spring-soft/lychee-music-hardware/pcb/资料/参考资料/pj320a_back.jpg

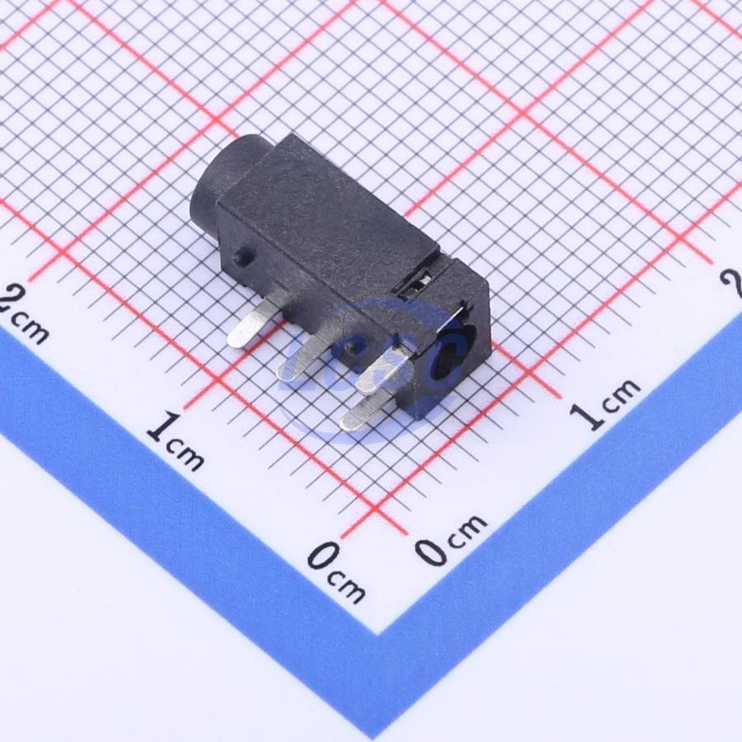
pcb/资料/参考资料/pj320a_back.jpg
