spring-soft/lychee-music-hardware/pcb/资料/设计规格书/README.md

# ESP-Music PCB 设计包 · 从这里开始

---

# 一、这台设备是什么？

## 1.1 一句话

**一台放在桌上、连上家里 WiFi、用耳机听自己音乐库的小播放器。**

## 1.2 它解决什么问题

你家电脑 / NAS / 树莓派上跑着一个 **Navidrome**（开源的自建音乐服务器），里面存着你收藏的全部歌曲。

想听歌的时候：

| 传统做法 | ESP-Music |
|---|---|
| 打开电脑 → 等开机 → 打开网页/客户端 → 找歌 | **插上耳机就能听** |
| 或者掏手机 → 解锁 → 打开 App → 连服务器 | 按键切歌，不看手机 |

**它就是一台"专用音乐终端"** —— 不干别的，只为听歌。

## 1.3 长什么样

```
        ┌─────────────────────────────┐
        │  ┌───────────────────────┐  │
        │  │                       │  │
        │  │   1.8 寸彩屏 128×160  │  │   ← 显示歌名、封面、歌词、进度条
        │  │                       │  │
        │  └───────────────────────┘  │
        │                             │
        │   [K1]  [K2]  [K3]  [K4]    │   ← 4 个按键
        │                             │
        │  ○耳机孔            [Type-C] │   ← 板边：3.5mm 耳机口 + Type-C
        └─────────────────────────────┘
            约 60 × 45 mm，巴掌大
```

## 1.4 怎么用（用户操作流程）

```
1. 插上 Type-C 线供电
      ↓  屏幕亮起，出现启动动画
2. 自动连上你家的 WiFi
      ↓
3. 自动连上你的 Navidrome 服务器
      ↓
4. 自动接着上次听的歌、上次的位置继续放
      ↓
5. 插上耳机就能听
```

**全程不需要任何设置**（WiFi 和服务器地址之前配过一次，存在设备里）。

## 1.5 屏幕显示什么

```
┌─────────────────────────────┐
│ ♪ 越来越不懂                 │  ← 歌名（只显歌名，不带歌手）
│ ┌────────┐                  │
│ │        │  窗外的雨 淋湿了  │  ← 歌词（3 行，当前行高亮）
│ │ 封面   │  我的眼睛          │
│ │        │  我却看不清        │
│ └────────┘                  │
│ ████████░░░░░░  01:23/04:12 │  ← 进度条 + 时间
└─────────────────────────────┘
```

## 1.6 四个按键干什么

| 按键 | 短按 | 长按 |
|---|---|---|
| **K1** | 下一首 | 收藏 / 取消收藏这首歌 |
| **K2** | 播放 / 暂停 | 进入音量调节 |
| **K3** | 上一首 | 打开歌曲列表 |
| **K4** | 切换显示模式（封面+歌词 / 全屏歌词 / 全屏封面） | 打开主菜单 |

**主菜单**里还有：蓝牙遥控、切换音乐来源（最近播放/我的收藏/随机30首）、**屏上搜索**、屏幕亮度、重连 WiFi、系统信息。

## 1.7 还能干什么

| 功能 | 说明 |
|---|---|
| **手机网页控制台** | 手机连上它的 WiFi 或和它同一个局域网，浏览器打开它的 IP 就能选歌、拖进度、看封面 |
| **蓝牙遥控** | 打开"蓝牙遥控"模式后，它会变成蓝牙键盘，**K1~K4 摇身变成控制手机/电脑播放的遥控器** |
| **屏上搜索** | 用 4 个按键在屏幕上打拼音搜歌（设备自带拼音输入法，因为服务器不支持拼音搜索） |
| **收藏双向同步** | 设备上收藏的歌，会同步到 Navidrome 服务器 |

## 1.8 为什么要重新画板

现在的硬件是在**面包板上用杜邦线**连起来的（开发板 + 音频模块 + 屏幕模块各自一块小板），有三个问题：

| 问题 | 现象 |
|---|---|
| **接触不良** | 听歌时断断续续的咔哒声 |
| **音质差** | 没有地平面、杜邦线当天线、功放的开关噪声串进模拟通路 → 底噪大 |
| **不可靠** | 松散、碰一下就断、做不成成品 |

**画一块 PCB 能同时解决这三个问题**：完整地平面 + 短走线 + 焊接替代插接。

## 1.9 新板和旧硬件的区别

| | 旧（面包板） | 新（自制 PCB） |
|---|---|---|
| 主控 | 整块开发板（ESP32-S3-COREBOARD V1.4） | **裸模组** ESP32-S3-WROOM-1-N16R8 |
| 音频 | ES8388 模块 + **PAM8406 功放 + 喇叭** | **ES8388 直接推耳机**，删掉功放和喇叭 |
| 屏幕 | 8 针模块 + 排母 | **1.8" 裸屏 + FPC 座** |
| 连接 | 杜邦线 | **PCB 走线** |

> **为什么删掉功放**：用户只要耳机不要喇叭。而且 **D 类功放的开关噪声正是耳机底噪的主要来源**，删掉等于从根上消除噪声。ES8388 本身内置 40mW 耳机功放，直接就能推 16Ω/32Ω 耳机。

---

# 二、你的任务

**用立创EDA 画出这块板子的原理图和 PCB，交嘉立创制造 + 贴片。**

```
读规格书 → 建工程 → 放元件 → 连线 → 转PCB → 布局 → 布线 → 铺铜 → 下单
```

**完整的设计信息全在 `电路设计规格书.md` 里。**

---

# 三、文档索引

## 📌 主文档：`电路设计规格书.md`

| 章节 | 内容 |
|---|---|
| **第 2 节** | ⭐ **元件清单 —— 每个元件在立创EDA里搜什么、选哪个、封装是什么** |
| **第 3 节** | ⭐ **完整网表 —— 哪个脚连哪个脚** |
| **第 4 节** | ⭐ **在立创EDA里的 10 步操作流程** |
| **第 5 节** | ⭐ **布局位置指引（含分区示意图）** |
| 第 7 节 | 关键参数说明（为什么用这些值） |
| 第 8 节 | 屏幕规格（含 14 脚定义） |
| 第 9 节 | 主控引脚分配表 |
| 第 10 节 | 固件侧配置（I2C 地址等） |
| 第 11 节 | ❗️ 不可违反的硬约束 |

## 📁 `esp32s3/` —— ESP32-S3 与现有硬件资料

| 文件 | 是什么 |
|---|---|
| `ESP32-S3-SCH-V1.4.pdf` | **现有开发板的完整原理图**（USB 部分、自动下载电路、外设接口都可以参考） |
| `ESP32-S3-Metric.pdf` / `ESP32-S3-inch.pdf` | 开发板尺寸图 |
| `sch.txt` / `sch.xml` | 上面原理图的**文字提取版**（可以搜索引脚连接，比看 PDF 快） |
| `sch-1.png` / `usb2-1.png` / `crop_*.png` | 原理图局部截图（USB、RGB、自动下载电路、接口座等） |
| `ES8388+PAM8406立体声CODEC音频模块资料.docx` | **现有音频模块的完整资料**，含实物图、引脚定义、规格参数 |
| `esp32-es8388-v1.1.zip` | 一个针对 ESP32-ES8388 开发板的 ESP-IDF 参考工程（可看 ES8388 代码怎么写的） |

## 📁 `屏幕规格书/` —— 要采购的 1.8" 屏

| 文件 | 是什么 |
|---|---|
| **`UN1770197-C-V02（C14).pdf`** | ⭐ **要买的就是这个版本**：14PIN 插拔式，0.5mm 间距，金手指朝屏幕反面 → 配「**下接**」FPC 座 |
| `UN1770196-C-V03 (H14).pdf` | 同款屏的「14PIN 焊接式」（0.8mm 间距，**不要买**） |
| `M180-128160-RGB-8.pdf` | 同款屏的「8 针排针模块」版（就是现在用的那种） |
| `ST7735S_V1.1_20111121.pdf` | ⭐ **ST7735S 驱动芯片原厂手册（201 页）**，调屏幕时序/伽马靠它 |
| `原理图.pdf` | 屏幕转接板的原理图 |

## 📁 `固件引脚定义/` —— 引脚定义的权威来源

| 文件 | 是什么 |
|---|---|
| `board.h` | 固件里所有引脚的 `#define`（**引脚分配的最终依据**） |
| `board.c` | ES8388 初始化、寄存器序列、音量控制、I2S 配置 |

---

# 四、工具

**立创EDA** —— 免费、中文、元件库直接对接嘉立创商城（元件有库存和价格，能一键下单）。

下载：https://lceda.cn/page/download

### ⚠️ 选「专业版」还是「标准版」

| | 专业版 | 标准版 |
|---|---|---|
| 下载体积 | 346 MB | 95 MB |
| **内存要求** | **8 GB** | 4 GB |
| 装机后占用 | 1.1 GB | 236 MB |

> **本项目用「标准版」完全够。** 唯一区别是专业版有层次原理图、多板设计这些**大型项目**才用得上的功能 —— 这块 45 个元件的单板用不上。
>
> （下载页上 `lceda-pro-...` 是专业版，纯 `lceda-...` 是标准版。）

---

# 五、最终要做出来的东西

```
一块约 60 × 45 mm 的 4 层板，焊好约 45 个元件：

  ┌ ESP32-S3-WROOM-1-N16R8 模组     主控 + WiFi + 蓝牙
  ├ ES8388                          音频 Codec（内置耳机功放）
  ├ TLV75733 LDO                    5V → 3.3V
  ├ Type-C 座                       供电 + 烧录 + 串口 + JTAG
  ├ 3.5mm 立体声耳机座
  ├ FPC 座（0.5mm 14P）             接 1.8" 屏
  ├ 背光 MOSFET + 限流电阻
  ├ 6 个轻触开关                    K1-K4 + RESET + BOOT
  └ 约 32 个电阻电容磁珠

插上屏 → 插上耳机 → 插上 USB 线烧固件 → 就能听歌
```

**制造方式**：嘉立创一站式（PCB 打样 + SMT 贴片 + 插件焊接），到手即成品板。

---

# 六、⚠️ 三条最容易翻车的地方

| # | 注意 | 后果 |
|---|---|---|
| 1 | **模组天线区正下方不能铺铜，且要悬出板边** | 铜在天线下面 → WiFi 辐射效率大幅下降，信号差、卡顿 |
| 2 | **`IO35` / `IO36` / `IO37` 绝对不能接任何东西** | 被 Octal PSRAM 芯片内部占用。网上例程用的是 N8R2（Quad PSRAM）版本，那三根能用，**不能照抄** |
| 3 | **ES8388 的 `CE` 脚必须接 `VCC`** | 决定 I2C 地址（CE=1 → 0x11，正是固件用的）。接错 → 芯片完全无响应 |

（完整清单见规格书第 11 节）
