spring-soft/lychee-music-hardware/交接说明.md

# ESP-Music 项目交接说明

> 交给 DSH（或任何接手的人/agent）的第一份文档。看完这份就能上手，不用重新摸索。
> 最后更新：2026-10-04

> ## 🆕 2026-10-07 更新：拆成两条分支，面包板那条冻结在原版
>
> 面包板与实际 PCB 现在是**两条独立的 git 分支**，各自把板型钉死在受版本控制的
> `firmware/sdkconfig.forced` 里，所以互不干扰、也不依赖那个含密码的 `sdkconfig.local`：
>
> | 分支 | 内容 | 板型 |
> |---|---|---|
> | `breadboard` | **原版 + 24bit 输出**（没有编码器 / TF 卡 / 离线模式 / 新增网页模式接口） | 钉死 `=y` |
> | `v2-pcb` | M9 全部功能（编码器 / TF 卡 / 离线曲库 / 在线离线双模式 / 收藏同步 / 网页模式扫描接口）**+ 24bit 输出** | 钉死 `=n` |
>
> ### 🎵 2026-10-07：24bit 解码已开通（两条分支都有，面包板上真机验证通过）
>
> 改动前整条链路写死 16bit：24bit FLAC 被 `ae_normalize()` 压成 16bit 才送进 DAC
> （播放页显示"24"是**源**位深，芯片实际按 16 在放）。现在 >16bit 的源按原精度送出。
>
> - **>16bit 的源** → 24bit 输出：**32bit 槽 + 数据 MSB 左对齐**，ES8388 `0x17 = 0x00`
> - **≤16bit 的源** → 16bit 输出（与改动前**逐字节相同**，有独立 memcpy 快路径）
> - 为什么不用 24bit 槽：`bclk_div = mclk/(2×槽位宽)` 必须整除，256/48 = 5.33 做不出来；
>   32bit 槽是 256/64 = 4 ✓
> - 回退开关：`audio_engine.c` 顶部 `#define AUDIO_OUT_ALLOW_24BIT 0`
> - 详情（含真机抓出的两个 bug）：`docs\开发记录\esp-music-24bit.md`
>
> ⚠️ **听感上基本听不出来**（差异是 −96dB 级量化噪声，埋在模拟噪声地板之下）。
> 它的意义是"不再无谓丢信息"。真正的听感瓶颈是 MCLK 抖动（S3 无 APLL），那要改硬件。
>
> ⚠️ 顺带修了一个**既有**缺陷：`board_measure_ws_hz()` 原来除以"请求窗口"而不是"实际窗口"
> （`vTaskDelay` 只保证至少睡够），忙时会报出 +30% 的**假**频率。它还会让旧记录里的
> "44.1k 偏差 −7.9‰（MCLK 分数分频）"变成假象 —— 修好后实测是 **−0.2‰**。
>
> ⚠️ **切分支后必须删 `firmware/sdkconfig` 再编译。**
> 它是 gitignore 的生成物，跨分支会残留旧配置 —— 实测从 `v2-pcb` 切到 `breadboard` 后，
> `sdkconfig` 里还带着 M9 打开的 FATFS 长文件名，而面包板分支的 `sdkconfig.forced`
> 里没有那几行，`sync_sdkconfig.py` 不会把它改回去。
>
> ⚠️ **只有 `firmware/` 在 git 里。** `docs/`、`pcb/`、根目录的 README 与本文
> **都不受 git 管辖**，所以它们不随分支切换 —— 看文档时先分清讲的是哪条线。
>
> ### 编译与烧录速度（实测，2026-10-07）
>
> | 场景 | 用时 |
> |---|---|
> | 什么都没改，再 build | **1.9 秒** |
> | 改一个 `.c` 再 build | **30.9 秒**（大部分是链接 2.5MB ELF + 生成镜像） |
> | 全量（删 `build/` 或 fullclean） | **181 秒**（2033 个目标文件 / 127 个静态库） |
> | 全量 + ccache 热缓存 | **122 秒**（省 33%；命中率 1926/1928 ≈ 100%） |
> | 全量 + ccache 冷缓存 | 305 秒（首次要多写缓存，之后就赚回来） |
>
> ccache 只省得下"编译"那一段；剩下的**链接 + 生成镜像 + configure 约 120 秒是地板**，
> 所以别指望更快。另外：`ccache` 的开关是环境变量 `IDF_CCACHE_ENABLE`（写在
> `env/idf.sh` 与 `E:\Espressif\idf.sh` 里）—— **不能**在 `CMakeLists.txt` 里
> `set(CCACHE_ENABLE ...)`，因为 `idf.py` 每次都用命令行 `-D` 传这个变量，会把它压掉
> （试过一轮才发现，坑记在 `CMakeLists.txt` 的注释里）。缓存目录钉在
> `E:\Espressif\ccache`（避开中文用户名路径）。
>
> 所以日常这么用：
> - 只改代码 → `idf.sh build`，**不要** fullclean
> - 只烧 app（`assets.bin` 没变）→ `idf.sh -p COM4 app-flash monitor`，约 50 秒
>   （**全量烧要 ~2.5 分钟**，因为它每次都重写 1.8MB 的 assets —— 这是"感觉编译很慢"
>   的一大半来源，"编译"其实只占其中一段）
> - 换板型 / 切分支 → **必须** `fullclean`（引脚宏影响多个组件的条件编译）
>
> ### M9 相关文档（都是 `v2-pcb` 线的）
>
> - `docs\开发记录\esp-music-m9-offline-tf.md` —— 实施记录 + **真机校准清单 10 项**
> - `docs\踩坑与设计记忆\esp-music-tfcard-plan.md` —— 方案与边界（⚠️ 这份曾丢失，已重建）
> - 顺手修过一个既有 bug：网页控制台 `max_uri_handlers`(32) 小于实际路由数(33)，
>   最后一条 `/api/hid/send` 一直静默 404。已放宽到 40。
>
> **当前实测状态**：面包板原版已烧回板上并跑通（菜单 5 项 / 设置 1 项 = 原样）。
> ⚠️ V2 板还没做好 —— 编码器 / TF 卡 / 离线曲库**尚未在真机上验证过**。

---

## 0. 这是什么

一台**自己画板、自己写固件的 WiFi 音乐播放器**。

```
  Navidrome 音乐服务器 ──WiFi──> [自研 PCB: ESP32-S3-N16R8]
                                        │
                                        ├─ 音频: ES8388 编解码 → 3.5mm 耳机座
                                        ├─ 显示: 1.8" ST7735 160×128 彩屏
                                        ├─ 输入: 4 个按键 (K1~K4)
                                        └─ 网页控制台 + 按键操作
```

固件自己实现：FLAC/MP3/AAC 解码、环形缓冲、直出无损、LVGL 界面、网页控制台。
**不是**刷现成固件改配置，是从零写的工程（约 9500 行 C，12 个自研 component）。

---

## 1. 目录结构

```
E:\program\esp-music\
├── 交接说明.md          ← 本文件
├── README.md            ← 索引 + 快速开始
│
├── firmware\            ← 固件源码（ESP-IDF 工程，带完整 .git 历史）
│   ├── components\      ← 12 个自研组件（板级/音频/UI/网络/播放器/网页控制台…）
│   ├── main\app_main.c  ← 启动编排（8 步开机流程）
│   ├── managed_components\  ← 第三方依赖（已下载，可离线编译）
│   ├── sdkconfig.local  ← ⚠️ 含 WiFi 和 Navidrome 密码，见第 7 节
│   └── tools\           ← 资源生成脚本（字库/拼音/图标）
│
├── pcb\                 ← PCB 设计（嘉立创EDA专业版）
│   ├── esp-music-player-V1+V2工程包.epro2  ← ★ 完整工程包（V1+V2 两块板）
│   ├── V2-TF卡版-单板.epro2
│   ├── V2-TF卡版-Gerber-新.zip             ← ★ 最新打样文件（已下单）
│   ├── 接线表与引脚定义.md                 ← ★ 引脚权威文档
│   ├── 交付说明.md / 交付说明-PCB布线.md
│   ├── SMT_BOM元件清单.xlsx / SMT_贴片坐标.xlsx
│   ├── 元件采购清单*.csv/md                ← 立创商城配单
│   ├── 设计数据\        ← bom.json / netlist.json（EDA 导出的结构化数据）
│   ├── 资料\            ← 芯片手册、屏幕规格书、固件引脚补丁后的 board.h/.c
│   ├── 工具\            ← 99 个 EDA 自动化脚本（见第 6 节）
│   └── 旧文件备份\      ← 早期迭代产物（历史存档，一般不用看）
│
├── docs\                ← 开发记录（★ 信息密度最高，接手先读）
│   ├── 方案与进度（正式）.md     ← 47KB，完整方案 + 进度表
│   ├── esp-music-全部代码.txt    ← 61 个手写文件的拼合版带行号索引
│   ├── 开发记录\                 ← 18 篇专题笔记（音频链路/字库/按键/持久化/搜索…）
│   └── 踩坑与设计记忆\           ← 从 Claude 记忆导出的硬事实（引脚/吞吐/坑）
│
├── env\                 ← 构建环境包装脚本
│   ├── idf.sh           ← ★ 编译入口（Git Bash 下用这个，别直接用 idf.py）
│   └── msys_shim.py     ← 绕开 ESP-IDF 的 Git Bash 检测
│
└── 归档\                ← 原始备份 zip
    ├── lychee-music-backup-20260925.zip  ← 固件的原始备份（212MB）
    └── ESP-Music-PCB.zip
```

---

## 2. 硬件

### 两块板

| | V1 | V2（当前主线） |
|---|---|---|
| 嘉立创工程 | `PCB1` | **`PCB1_1`** |
| 特点 | 面包板验证版 | **TF 卡版**（+ 旋转编码器 + TF 卡槽）|
| 状态 | 已制造 | 已下单，**固件尚未适配新增硬件** |

### V2 引脚表（权威，来自 `pcb\接线表与引脚定义.md` + EDA 导出）

| 功能 | 固件宏 → GPIO |
|---|---|
| I2C | `SDA=1` `SCL=2` |
| I2S（音频） | `MCLK=42` `BCLK=41` `WS=39` `DOUT=40` |
| LCD | `SCLK=4` `MOSI=5` `RST=6` `DC=7` `CS=15` `BL=16` |
| 按键 | `K1=38` `K2=8` `K3=18` `K4=17` |
| 🆕 旋转编码器 | `ENC_A=9` `ENC_B=10` `ENC_SW=11` |
| 🆕 TF 卡 | `TF_CS=12` `TF_MISO=13` `TF_CD=14` |

### ⚠️ 相对面包板版的 3 处关键变化（不打补丁 K1 直接失效）

1. **`KEY_K1`: GPIO3 → GPIO38**。IO3 是 strapping 脚，上电被拉低会进 JTAG。
   **不打补丁就烧录，固件去轮询悬空的 IO3，K1 完全没反应。**
2. 删 `BOARD_PIN_PA_EN`（GPIO47）—— 去掉 PAM8406 功放，ES8388 内置耳放直推耳机。
3. 删 `BOARD_PIN_I2S_DIN`（GPIO38）—— 不录音，GPIO38 正好腾给 K1。

补丁文件 `pcb\firmware-patch.diff`，**打好补丁的版本**在 `pcb\资料\固件引脚定义\board.{h,c}`。
（当前 `firmware\` 里的 board 组件已包含这些改动。）

### ⚠️ TF 卡的关键硬约束

- **TF 卡和屏幕共用 SPI 总线**（`CLK=IO4`、`MOSI=IO5`），**靠 CS 区分**（屏幕 IO15 / TF 卡 IO12）。
- TF 卡 DAT1/DAT2 悬空 → 是 **SPI 模式**，不是 SD 1-bit 模式。
- **电量显示做不到**：IP5306 直接驱动 3 颗 LED，**没有任何一路回到 ESP32**。
  要显示电量必须重新打板加 ADC 分压网络。那 3 颗 LED 就是唯一电量指示。

---

## 3. 固件现状

### 已完成并**实机验证**（面包板上跑通）

| 里程碑 | 内容 |
|---|---|
| M0 | 工具链 / 分区 / PSRAM / 板级 bring-up |
| M1 | 音频管道（解码 → 环形缓冲 → I2S），MP3 精确到帧、FLAC 不崩 |
| M2 | 联网 + Navidrome 拉流 |
| M3 | 播放页 UI（封面/歌名/滚动/进度） |
| M4 | 按键 + 列表页/菜单页/音量页 + 来源切换 |
| M5 | 网页控制台（27 个接口） |
| M6 | 最近播放/收藏落盘 + 与 Navidrome 双向同步 + 开机续播 |
| M8 | 屏幕上的拼音搜索 |

### 近期优化（都在 `v2-pcb` 分支）

- **无损直出**：首次播放 `format=raw` 直出原文件，只有 seek 才转码
- **WiFi 吞吐 100 → 233+ KB/s**：砍掉 BLE + 调 WiFi 接收缓冲 + TCP 窗口 8K→64K
- 实测最重的一首（1864kbps / 24bit / 48kHz，需 233 KB/s）**FLAC 直出、欠载 0**
- 播放页显示解码格式/直出或转码/实时速率
- 内存用量图表页（长按系统信息页的 K3 进入）
- 开机第 7 步「同步曲库」：修掉"本地列表 suffix 为空 → 整列歌变 MP3"的 bug

### 🆕 2026-10-06 新增（代码已完成，等 V2 板验证）

| 项 | 状态 |
|---|---|
| 旋转编码器（PCNT 正交 + 全菜单方向键） | ✅ 完成。**面包板变体不编译**（K1/K2 语义一字未改）；V2 变体才编入 |
| TF 卡（SDSPI，与屏幕共用 SPI2） | ✅ 完成。**懒挂载/用完卸载**（内存取舍），卡检测 IO14 |
| 离线曲库（扫描 / 文件名解析 / 索引 / 搜索） | ✅ `components/musiclib/`；索引在卡上 + PSRAM 常驻；离线搜索不需要拼音索引 |
| 在线 / 离线双模式（歌单、收藏、最近播放分开） | ✅ 主菜单第 4 项（两段确认）；NVS `cfg/mode` |
| 收藏同步到离线 | ✅ 设置页第 2 项（只同步标记，不下载音频；匹配不上就跳过） |

### ❌ 还没做的

- **离线 seek**（现在是"从头重播"，有日志提示）。**刻意留到板子到了再做**：唯一正确的做法
  （decode-and-discard）要动全工程最精细、也是唯一被真机充分验证过的那条音频管道，
  为一个"快进"冒回归在线播放的风险不划算
- 标签解析（离线曲目的时长显示 `--:--`、封面用占位图 —— 用户已确认用文件名元数据）
- 卡热插拔自动重挂（现在只在切模式/扫描/同步时尝试挂载）
- **开机续播**：用户明确说不要了（已删）

### 🔧 编 V2 固件用这个（别手改 sdkconfig.local）

```bash
cd /e/program/esp-music/firmware
tools/build_v2.sh                        # 编 V2 变体（自动 fullclean）
tools/build_v2.sh -p COM5 flash monitor  # 烧录
```

它临时往 `sdkconfig.forced` 加一行板型、编完自动撤掉，**全程不碰含密码的 `sdkconfig.local`**。
面包板变体不需要脚本，直接 `/e/Espressif/idf.sh build`。

---

## 4. 编译 & 烧录

### ⚠️ 这台机器有三个 Windows 坑（都已解决，用包装脚本绕过）

1. **中文用户名**：用户名「春软」导致 xtensa 工具链报路径全是 `????`，
   `ld` 找不到 `crt0.o`/`libgcc`。→ 工具链装在**纯 ASCII 路径** `E:\Espressif\tools`。
2. **Git Bash 的 `MSYSTEM` 删不掉**：`idf_tools.py`/`idf.py` 检测到它就拒绝运行，
   而 `unset`/`env -u` 都无效（会被重新注入）。→ `msys_shim.py` 在 Python 进程内 pop 掉。
3. `export.bat` 同时负责加 PATH，绕开它就得自己加。→ `idf.sh` 里手工加了。

### 编译（在 Git Bash 里）

```bash
cd /e/program/esp-music/firmware
/e/Espressif/idf.sh build            # ← 用这个，不要直接 idf.py
```

> `env\idf.sh` 是同一份脚本的副本；`E:\Espressif\idf.sh` 是原件，两个都能用。

⚠️ **换了路径后第一次编译前**：`build/` 里记着绝对路径，必须先 `idf.py fullclean`
（或直接删 `build/`）。目录刚搬过家，**第一次务必 fullclean**。

⚠️ **改了 `sdkconfig.local` 直接 build 是无效的** —— 顶层 `CMakeLists.txt` 每次 configure 前
跑 `tools/sync_sdkconfig.py`，把 `sdkconfig.local`/`sdkconfig.forced` 强制覆盖进 `sdkconfig`。
这是刻意设计（IDF 的 `SDKCONFIG_DEFAULTS` 对已存在的 `sdkconfig` 无效）。

### 烧录

```bash
/e/Espressif/idf.sh -p COM5 flash monitor
```

原生 USB-Serial-JTAG 走 IO19/IO20，支持自动复位。不行就按住 SW6(BOOT) 再点 SW5(RESET)。

### 施工开关（都在 `main\app_main.c`）

| 开关 | 作用 | 默认 |
|---|---|---|
| `K4_SELFTEST` | 开机自动走一遍按键序列并逐页打印页面名（改完按键逻辑自测用） | 0 |
| `BASELINE_TONE` | 开机放 1.5 秒 440Hz 测试音 | 0 |
| `UI_DUMP_ON_SONG` / `UI_CALIBRATE` | UI 调试 | 0 |

⚠️ `K4_SELFTEST` 开着时会在开机后**自己乱按键**，验证完记得关。

---

## 5. 接手前必读的坑（精选，全文见 `docs\踩坑与设计记忆\`）

| 坑 | 一句话 |
|---|---|
| **内部 SRAM 是最紧的资源** | 共 308KB，BLE 要 40KB。`SPIRAM_MALLOC_ALWAYSINTERNAL=512` 意味着 <512B 的 malloc 进内部 SRAM。**加一个 LVGL 页面就可能挤垮网络。** |
| **BLE 已砍** | `CONFIG_BT_ENABLED=n`，换来内部 SRAM 从 7KB → 49KB。**这是 WiFi 提速的前提**，别随手加回来。 |
| **OGG 不能直出** | Vorbis 解码器吃光内部 SRAM 后停止消费，`ring_in` 涨满、网络挂掉。**OGG 走服务端转码**（那条路是好的）。 |
| **NVS 里残留的 transcode 设置** | 烧新固件不会清。曾经残留 `"raw"` 导致所有格式直出、OGG 卡死，而音质菜单已删、界面改不回来。→ `subsonic_init()` 里强制改回 `auto`。 |
| **本地列表的 suffix 是空的** | 收藏/最近播放来自本地镜像，镜像里 suffix 为空 → 判不出格式 → **整列歌变 MP3**。修法：开机第 7 步同步曲库 + `h_play` 回源。 |
| **诊断利器 `/api/debug` 的 `stream_why`** | 直接告诉你"这次为什么直出/转码"。**查"怎么变 MP3 了"先看它。** |
| **`ui_font_lat` 没有汉字** | 只有拉丁字形，拿它渲染中文会出**方框**。中文要用 `ui_font_12`/`ui_font_16`。 |
| **Navidrome 不支持 `format=flac`** | 静默忽略，直接发回原文件。"把有损源转 FLAC"这条路走不通。 |
| **S3 的 I2S 没有 APLL** | MCLK 只能从 160MHz 分数分频 → 必然抖动。治不了，板子上也没晶振。 |

---

## 6. 工具清单

### 固件侧 `firmware\tools\`
| 脚本 | 用途 |
|---|---|
| `sync_sdkconfig.py` | ★ 把 `sdkconfig.local`/`.forced` 覆盖进 `sdkconfig`（每次 configure 自动跑） |
| `gen_font.sh` / `gen_font_charset.py` | 生成中文字库 bin |
| `gen_pinyin.py` | 生成拼音检索表 |
| `gen_ui_png.py` / `gen_ui_text.py` | 预渲染 UI 素材 |
| `gen_assets.py` | 打包 `assets.bin` |

### PCB 侧 `pcb\工具\`（99 个脚本）+ `pcb\*.js`
这些是 **EasyEDA 自动化脚本**（用 `eda.mjs` 通过 WebSocket 驱动嘉立创EDA专业版）：
布局求解、碰撞检测、DRC 检查、铺铜、走线、Gerber 导出、3D 截图… 
命名规律：`check-*` 检查、`dump-*` 导出、`apply-*`/`fix-*`/`move-*` 改板、`pour-*` 铺铜。

**用之前先读** `docs\踩坑与设计记忆\easyeda-pro-api-pitfalls.md` —— 里面记着哪些 API 是坏的，
免得重复试参数。EDA 专用 skill 也在环境里（`easyeda-api`）。

---

## 7. ⚠️ 凭据与安全

**`firmware\sdkconfig.local` 里有明文密码**：WiFi 密码 + Navidrome 账号密码。
`tools\sync_sdkconfig.py` 会把它们**同步写进 `sdkconfig`**，所以那个文件里也有。

- 两个文件都在 `.gitignore` 里 —— **推 GitHub 的那份是干净的，千万别 `git add` 它们**。
- 设备上的 WiFi/Navidrome 配置还存在设备 NVS 里，所以删掉这个文件不影响已配好的机器；
  换机器编译时照 `sdkconfig.local.template` 填一份即可。

---

## 8. 下一步（V2 板到货后）

**动手前必读** `docs\踩坑与设计记忆\esp-music-tfcard-plan.md`
（方案与边界）＋ `docs\开发记录\esp-music-m9-offline-tf.md`
（实施记录、实测数字、**第 7 节的 10 项真机校准清单**）。

| 原计划阶段 | 状态 |
|---|---|
| 1 板级适配（V2 引脚补丁 + 四键/屏/音频实测） | 代码侧已就绪（board.h 的 V2 分支早就在）；**实测等板子** |
| 2 旋转编码器（PCNT 正交 + 事件映射） | ✅ 已实现。⚠️ 原计划的映射"顺时针=K2、逆时针=K1、按下=K3"**改了**：现在是按页面显式映射（播放页=切歌/暂停，列表页=移行/确认…），见 dev record 第 2 节的键位表 |
| 3.1 **提 SPI 总线** | ✅ **风险消失**：不需要搬时序。`esp_vfs_fat_sdspi_mount()` 只要求总线已初始化，而屏幕开机第 3 步就建好了；只把 `spi_bus_initialize` 换成幂等的 `board_spi_bus_init()`，零时序变化 |
| 3.2 SDSPI 挂 `/sdcard` | ✅ 已实现（20MHz、`format_if_mount_failed=false`、卡不在不阻塞启动；且改成**懒挂载+用完卸载**省内部 SRAM） |
| 3.3 缓存双后端 | ❌ **已废弃**：用户把 TF 卡的用途定为"离线曲库"，在线缓存继续留 flash `cache` 分区（两条线互不干扰） |
| 4 联调 + 整机验收 + 内存核算 | ⏳ 等板子。内存账见 dev record 第 6 节（V2 固件 2,545,392 B，app 分区用 80.9%） |

**用户已拍板的决定（别再问）**：
- 要**无损**不要转码；TF 卡用途是**缓存 + 卡检测**；编码器当**全菜单方向键**
- **断点续播不要了**；**菜单里不要音质选项**（固定最高）；**BLE 可以砍**（已砍）
- 离线方案：**在线/离线双模式、收藏分开、在线收藏能同步到离线（卡上没有的跳过）**

---

## 9. 一上手就能验证的三件事

```bash
# 1. 固件能编
cd /e/program/esp-music/firmware && /e/Espressif/idf.sh fullclean && /e/Espressif/idf.sh build

# 2. 逻辑没坏（读 git 历史，29 个提交）
git log --oneline | head -20

# 3. 硬件设计齐全
ls /e/program/esp-music/pcb/          # 工程包 + Gerber + BOM + 采购清单
```
