spring-soft/lychee-music-hardware/pcb/交付说明-PCB布线.md

# ESP-Music PCB —— 布线交付说明

**日期**：2026-09-27
**工程**：嘉立创EDA专业版 `esp-music-player`
**本阶段范围**：PCB 布局定稿 + 布线 + 铺铜 + DRC
**上一阶段**：见 `交付说明.md`（原理图）

---

## 一、结论

**板子已完整交付，DRC 零违规。**

| 项目 | 结果 |
|---|---|
| 板框 | **58.0 × 50.0 mm**，四层板 |
| 元件 | 70 个（正面 14 / 背面 56） |
| 网络 | 50 个，**全部布通，0 未布通** |
| 走线 | 839 段（顶层 199 / 底层 640） |
| 过孔 | 152 个 |
| 铺铜 | 4 块（内层二 GND / 内层一 VCC / 顶层 GND / 底层 GND） |
| **DRC** | **0 违规** ✅ |

> 布线只用了**顶层和底层**，两个内层完整留给了电源平面和地平面。

---

## 二、叠层设计（四层）

| 层 | ID | 用途 | 说明 |
|---|---|---|---|
| 顶层 Top | 1 | 信号 + GND 铺铜 | 元件少（只 14 个），中间大片空白走线 |
| 内层一 Inner1 | 15 | **VCC 3.3V 电源平面** | 整板铺铜，天线区挖空 |
| 内层二 Inner2 | 16 | **GND 地平面** | 紧贴底层，底层所有信号的完整回流路径 |
| 底层 Bottom | 2 | 信号 + GND 铺铜 | ESP32 / 音频芯片 / 电源都在这层 |

**为什么这么分：**

- **内层二做地平面** —— 它紧贴底层，而 ESP32、ES8388 音频芯片、IP5306 电源全在底层。这层做完整地平面 = 所有信号都有完整回流路径，**这是解决底噪最关键的一步**。
- **内层一做 VCC 平面** —— 见第四节的「VCC 阻抗问题」。

**天线禁布区**：板子上边缘留出 84 mil（约 2.1 mm）不铺铜（所有层），避让 ESP32 模组的 WiFi 天线。同时模组天线本身悬出板边。

---

## 三、本轮修掉的 4 处间距违规

DRC 在布局阶段查出 4 处，**全部是我之前的检查脚本漏掉的** —— 根源是我用「手写的元件本体尺寸表」估算，而编码器、耳机座的**焊盘伸出了本体轮廓之外**。

| # | 问题 | 处理 |
|---|---|---|
| 1 | `C15` ↔ `C16` 焊盘重叠 **16.4 mil** | C15 → (1572, 1330)，C16 → (1560, 1070) |
| 2 | `J4` 电池座固定脚 ↔ `R17` 焊盘，间隙仅 **1.2 mil** | R17 左移到 x=1990 |
| 3 | `J2` 耳机座焊盘**出界 11.8 mil** | J2 左移到 x=2125 |
| 4 | `EC1` 编码器焊盘**出界 5.9 mil** | EC1 左移到 x=2070 |

**改进**：新增 `check-pads.mjs` —— 直接用 EDA 导出的**真实焊盘几何**（形状 + 旋转角）算矩形，不再依赖手写尺寸表。修完复跑，它与 DRC 的结果**完全一致**。

另外修掉的盲区：
- `check-throughhole.js` 改为**自动识别直插件**（读焊盘 layer=12），不再手写清单 —— 之前 SW5/SW6 改成贴片后清单没同步
- 各检查脚本里 SW5/SW6 的本体尺寸从 6×6mm 修正为实际的 4.0×2.9mm

---

## 四、电源设计的一处取舍（请你知悉）

### VCC 阻抗问题 —— 已解决

自动布线把 VCC 走成了 **223 mm 长的 10 mil 细线**。按 1 oz 铜算：

```
电阻 ≈ 0.51 Ω  →  ESP32-S3 峰值 500mA 时压降 0.26V  →  会欠压复位
```

**解决方式**：内层一铺整板 VCC 平面，并打 2 个接入孔接到最关键的节点
（`U3.5` LDO 输出端、`U1.2` ESP32 供电端），另有自动布线顺手打的 8 个 VCC 过孔。
平面把长距离电流的阻抗降了一个数量级。

### 电源线宽 —— 保持 10 mil

`BAT+`/`VBUS`/`+5V` 没能加粗。原因：**自动布线按最小间距密排，事后加粗没有空间**（我写脚本实测了每一段到邻线的距离，88 段里**没有一段**有加宽余量）。

不过按实际电流算，**10 mil 够用**：

| 网络 | 长度 | 估算电流 | 压降 | 判断 |
|---|---|---|---|---|
| `BAT+` | 41.4 mm | ~0.6 A | 47 mV | ✅ |
| `+5V` | 64.8 mm | ~0.4 A | 50 mV | ✅ |
| `VBUS` | 61.5 mm | ~1 A（充电） | 117 mV | ✅ |

> 试过在布线前把线宽规则写进「设计规则」，但**自动布线过程会把网络规则重置回 default**，所以没生效。

### GND 缝合

53 个 GND 过孔均匀分布板面，把顶层/底层的 GND 铺铜与内层二地平面缝合。

---

## 五、布局上的两处外观调整

1. **编码器与按键对齐**（你要求的）
   `EC1` 从 y=250 下移到 **y=195**。原因是这个封装
   （`SW-SMD_HYCW03-2.8D-5P-S`）的**焊盘中心与画出来的本体外形不同心** ——
   焊盘本来就在按键中线上，但外形框偏上约 55 mil。按视觉外形对齐后，本体与
   `SW1~SW4` 的方框上下边缘齐平。焊盘偏移 55 mil 对贴片无影响。

2. **编码器与按键同一行**
   `EC1` x = 2070，与 `SW1~SW4`（x = 500/900/1300/1700）同排，位于 LED 列（x=2080）附近。

---

## 六、打样前请你再肉眼过一遍

自动化检查只能覆盖几何和规则，下面这些**建议你自己看**：

- [ ] **ES8388 的 `CE` 脚接 VCC**（硬约束，接错 I2C 地址不对，芯片无响应）
- [ ] **IO35 / IO36 / IO37 悬空**（N16R8 的 Octal PSRAM 内部占用）
- [ ] **220µF 耦合电容极性**：正极（脚 1）接 codec 输出，负极（脚 2）接耳机座
- [ ] **天线区无铜**（所有层，板子上边缘 2.1mm 条带）
- [ ] **电池不压住背面按钮**、**电池接口外侧无遮挡**（留给电池区 x 800~1981, y 60~1950，区内最高元件 2.2mm）
- [ ] **屏幕排线空间**（屏幕 45.83 × 34 mm，装在正面）

---

## 七、下一步

### 7.1 投板

嘉立创下单时注意：
- **四层板**，1 oz 铜厚（规则集按 1 oz 设的）
- 板厚、阻抗等按默认即可（本板无阻抗控制要求，USB 是 Full-Speed 12 Mbps）

### 7.2 固件补丁（**必须打，否则 K1 按键失效**）

`firmware-patch.diff`，三处改动：

```
BOARD_PIN_KEY1      3  →  38     (避开 strapping 脚)
BOARD_PIN_I2S_DIN   38 →  删除   (不录音)
BOARD_PIN_PA_EN     47 →  删除   (功放已去掉)
```

已验证 `patch -p1` 可干净应用。

### 7.3 首板调试顺序建议

1. 先**只焊电源部分**（Type-C、IP5306、L1、TLV75733），上电测 3.3V 和 5V
2. 再焊 ESP32 模组，测能否烧录（USB 识别）
3. 再焊 ES8388 + 耳机座，测 I2C 能否读到 0x11
4. 最后焊屏幕和按键

---

## 八、本次用到的工具（可复用）

| 文件 | 用途 |
|---|---|
| `check-pads.mjs` | **真实焊盘几何**的间距/板边检查（推荐，替代旧的本体表检查） |
| `compute-vias.mjs` | 计算可打过孔的空位（缝合孔 / 平面接入孔） |
| `compute-widths.mjs` | 计算每段线的可加宽余量 |
| `router.mjs` | 自研 A* 布线器（备用，本次未使用） |
| `shot.mjs` / `shot-zoom.mjs` | 截取 PCB 渲染图 |
| `eda.mjs` | 桥接调用入口：`node eda.mjs <脚本.js>` |

### 值得记下的 API 坑

嘉立创EDA专业版 V4.1.60 的 Run API Gateway 扩展里，以下接口**不可用或行为异常**：

| 接口 | 现象 |
|---|---|
| **`pcb_Document.save()`** | ⚠️ **改完必须调用**。文档会从磁盘重新加载，不保存的接口改动一刷新就回退。症状：脚本里明明创建成功并回读确认，下一次调用却变回原样。**本次因此白丢了两轮自动布线** |
| `pcb_Document.autoRouting()` | 调用后**永不返回**（界面点按钮正常） |
| `pcb_ManufactureData.getDsnFile()` | 导出的 DSN **所有元件坐标都是 0** |
| `pcb_Drc.createNetClass()` | 建不了网络类 |
| `pcb_PrimitivePour.create()` | 只在**闭合点串格式**下可用；`['R',x,y,w,h]` 格式算出的多边形是畸形的 |
| 铺铜填充计算 | API 建完边框后**不会自动算填充**，必须在界面点「重建铺铜」 |
| `pcb_Drc.overwriteNetRules()` | 能写入，但**自动布线时会被重置** |
| 请求超时 | 桥接服务器默认 30 秒，长任务需调 `EDA_BRIDGE_TIMEOUT_MS` |

**另外**：
- 每个脚本开头必须显式 `openDocument()`，否则 `getAll()` 返回 null
- 工程里可能有多个 PCB 文档，**`getAllPcbsInfo()[0]` 的顺序会变** —— 必须用 uuid 显式锁定目标板
- 移动 PCB 元件**会把已有走线全部清空**，布局微调必须在布线之前做完
- 铺铜的填充计算**接口做不了**，必须在界面点「重建铺铜」

### 可靠的工作流（本次验证过）

```
1. 接口改动 → await eda.pcb_Document.save()
2. 切到别的文档再切回来 → 回读校验（确认改动落盘）
3. 界面上做的操作（自动布线 / 重建铺铜）→ 让用户按一次 Ctrl+S
4. 再做第 2 步校验
```

**校验通过再进行下一步** —— 否则可能做完全部工作才发现某一环丢了。
