spring-soft/lychee-music-hardware/pcb/交付说明.md

# ESP-Music PCB —— 原理图交付说明

**日期**：2026-09-26
**工程**：嘉立创EDA专业版，工程名 `esp-music-player`（工程 UUID `0c06a532…552036`）
**本阶段范围**：只出原理图（PCB 布局布线留待下一轮）

---

## 一、结论

原理图已画完并通过验证：

| 验证项 | 结果 |
|---|---|
| 元件数 | **49 个**（规格书 45 个 + 用户确认新增的 4 个退耦电容） |
| 网络数 | 37 个 |
| 引脚连接 | **165 条，与网表逐条比对，零差异** |
| 引脚连通性 | 198 个引脚全部 `noConnected = false` |
| ERC | 5 条警告（来自规格书明确要求悬空的脚，见第四节） |
| 图幅 | A1（原 A4 装不下，更换后 ERC 警告从 330 降到 5） |

---

## 二、与规格书的三处偏离（均已获用户确认）

### 1. K1 从 GPIO3 改到 GPIO38 ★ 需要同步改固件

规格书把 K1 从 `IO3` 改到 `IO38`，避开 strapping 脚。但资料包里的
`固件引脚定义/board.h` 与旧备份 **md5 完全相同**（`e401d911…`），即固件没改过。
**若不改固件就烧录，K1 会直接失效**（固件轮询悬空的 IO3，永远读到"未按下"）。

→ 已交付固件补丁 `firmware-patch.diff`，见第五节。

### 2. 220µF 耳机耦合电容改用固态电容（规格书原要求物理上做不到）

规格书要求 **220µF / ≥10V / 1210 封装**，三个条件在立创库里凑不齐 ——
1210（3.2×2.5mm）封装下 220µF 的最高耐压只到 6.3V。改为：

`KNSCHA RST220UF10V018`，220µF/10V，`CAP-SMD_BD6.3-L6.6-W6.6-FD`，**C4747973**

比钽电容 ESR 更低、无压电噪声、**接反不会起火**。

### 3. 新增 4 颗 ES8388 退耦电容

规格书第 3.8 节写「未列出的脚悬空」，但 `VREF`(10)、`VMID`(20) 悬空会导致
工作点漂移/噪声 —— 原来那块 ES8388 音频模块把这些电容做在模块上了，画成单板就没
了。已新增（用户确认）：

| 位号 | 值 | 接 |
|---|---|---|
| C17 | 10µF | `VREF` → GND |
| C18 | 100nF | `VREF` → GND |
| C19 | 10µF | `VMID` → GND |
| C20 | 100nF | `VMID` → GND |

> `ADCVREF`(19) 仍悬空 —— ADC 已断电（`R_ADCPOWER=0xFF`），无影响。

---

## 三、元件清单（可直接下单）

全部核实自嘉立创系统库，**基础库元件免 SMT 上料费**。

### 主要器件

| 位号 | 型号 | 厂商 | 封装 | 商城编号 |
|---|---|---|---|---|
| U1 | ESP32-S3-WROOM-1-**N16R8** | ESPRESSIF | `WIRELM-SMD_ESP32-S3-WROOM-1` | C2913202 |
| U2 | ES8388 | Everest-semi | `QFN-28_L4.0-W4.0-P0.45-BL-EP` | C365736 |
| U3 | TLV75733PDBVR | TI | `SOT-23-5_L2.9-W1.6-P0.95-LS2.8-BL` | C485517 |
| Q1 | 2N7002 | TWGMC | `SOT-23-3` | C727149 |
| J1 | TYPE-C-31-M-12 | 韩国韩荣 | `USB-C_SMD_TYPE-C-31-M-12` | C165948 |
| J2 | PJ-320A | XKB 星坤 | `AUDIO-TH_XKB_PJ-320A` | C2884926 |
| J3 | 0.5mm 14P 下接翻盖 FPC | — | `FPC-SMD_14P-P0.50_AFC01-S14FCC-00` | C9900014993 |
| SW1–SW6 | 轻触开关 6×6×5 直插（2脚） | — | `KEY-TH_2P-L6.0-W6.0-P5.00` | C71845 |

### 电阻（14 颗，**全部基础库**）

| 值 | 型号 | 商城编号 | 数量 | 位号 |
|---|---|---|---|---|
| 5.1kΩ | 0603WAF5101T5E | C23186 | 2 | R1 R2 |
| 1MΩ | 0603WAF1004T5E | C22935 | 1 | R3 |
| 10kΩ | 0603WAF1002T5E | C25804 | 8 | R4–R11 |
| 100Ω | 0603WAF1000T5E | C22775 | 2 | R12 R13 |
| 100kΩ | 0603WAF1003T5E | C25803 | 1 | R14 |

### 电容（20 颗）

| 值 | 型号 | 商城编号 | 数量 | 位号 | 库 |
|---|---|---|---|---|---|
| 100nF/50V X7R | CC0603KRX7R9BB104 | C14663 | 6 | C4–C9 | 基础 |
| 10µF/10V X5R | CL10A106KP8NNNC | C19702 | 5 | C10–C14 | 基础 |
| 1µF/50V X5R | CL10A105KB8NNNC | C15849 | 2 | C2 C3 | 基础 |
| 4.7nF/50V X7R | CL10B472KB8NNNC | C1621 | 1 | C1 | 扩展 |
| 220µF/10V 固态（极性） | RST220UF10V018 | C4747973 | 2 | C15 C16 | 扩展 |
| 10µF/10V X5R | CL10A106KP8NNNC | C19702 | 2 | C17 C19 | 基础 |
| 100nF/50V X7R | CC0603KRX7R9BB104 | C14663 | 2 | C18 C20 | 基础 |

### 磁珠（2 颗）

| 型号 | 厂商 | 封装 | 商城编号 | 位号 |
|---|---|---|---|---|
| MMZ1608B601CTAH0 600Ω@100MHz | TDK | L0603 | C97120 | FB1 FB2 |

---

## 四、耳机座引脚映射（已定案，含证据链）

用户确认耳机为**三环 4 极（TRRS）**，且不做麦克风。定案接法：

| J2 引脚 | 网络 | 说明 |
|---|---|---|
| 2 | `HP_L` | 尖端 = 左声道 |
| 3 | `HP_R` | 第一环 = 右声道 |
| 4 | 悬空 | 第二环 = 麦克风线，立体声不需要 |
| 5 | `GND` | 筒身 |

**证据链（三个独立来源互相印证）：**

1. **官方引脚图 SVG 的几何坐标**（从 LCSC 商品页取得原始 SVG）
   引脚 5 的走线 `(390,290)→(350,290)→(350,300)`，终点正落在筒身矩形条
   `x:347-353, y:300-318` 的左上角 → **引脚 5 在结构上就是筒身**。

2. **触点深度排序**：三个弹簧触点向左伸出至 x=359(引脚2)、368(引脚3)、373(引脚4)。
   耳机插头插入时**尖端走得最深** → 最深者(引脚2)为尖端。

3. **KiCad 参考库**（源自数据手册）：`Sleeve=1 / Tip=2 / Ring1=3 / Ring2=4`
   —— 引脚 2/3/4 的命名与上面两项分析完全一致。

**残余风险**：引脚 5=地 是结构性证据，置信度高。万一判错，耳机输出串有 220µF
耦合电容、直流被隔断，**最坏情况是某声道无声，不会损坏芯片**。引脚 2/3 若左右
搞反，调换两个耦合电容接线即可。

---

## 五、ERC 的 5 条警告（不影响电气正确性）

排查过程：最初 330 条警告，逐项定性后发现**主要是元件超出图框**导致的
（`zoomToAllPrimitives` 渲染可见元件全在图框外）。换成 A1 图幅、元件全部入框后
降到 7 条；耳机座接完线后降到 **5 条**。

剩余 5 条来自规格书明确要求悬空的脚（ES8388 的 ASDOUT / LIN / RIN、
USB 的 SBU1/SBU2、屏排线 NC 等）。

`SCH_Drc.check()` 只返回 `{type,count}` 聚合值，不提供逐条文本，需在 EDA 的
DRC 面板（工具 → 电气规则检查）查看中文明细。

---

## 六、固件补丁（`firmware-patch.diff`）

针对 `esp-music/components/board/{include/board.h, src/board.c}`，共 44 行改动。

**用法**（在 esp-music 工程根目录）：
```bash
patch -p1 < firmware-patch.diff
```

已验证：`patch -p1 --dry-run` 干净通过，应用后结果逐字节一致。

### 改动内容

| # | 文件 | 改动 |
|---|---|---|
| 1 | board.h | `BOARD_PIN_KEY1` **3 → 38** |
| 2 | board.h | 删除 `BOARD_PIN_I2S_DIN`（不录音，IO38 腾给 K1） |
| 3 | board.h | 删除 `BOARD_PIN_PA_EN`（无 PAM8406 功放） |
| 4 | board.c | `board_pa_enable()` 改空实现（保留签名兼容调用方） |
| 5 | board.c | I2S `din` → `I2S_GPIO_UNUSED`（通道本就是 TX-only：`i2s_new_channel(&chan_cfg, &s_tx, NULL)`） |
| 6 | board.c | 删除 PA 使能脚的 GPIO 初始化 |
| 7 | board.c | 自检日志去掉 PA / DIN 两项 |

**已复查**：改完后 `BOARD_PIN_I2S_DIN` / `BOARD_PIN_PA_EN` 在全文件**零残留引用**。

⚠️ 补丁只覆盖 `board.c` / `board.h` 两个文件。`BOARD_PIN_KEY1` 的实际使用点在
`components/ui/src/ui_keys.c`，该文件不在资料包内 —— **但它是通过宏引用的，
只要 board.h 改了就会自动生效，无需改 ui_keys.c**。

---

## 七、遗留事项

| # | 事项 | 说明 |
|---|---|---|
| 1 | 探针工程 `erc-probe` | 我做 ERC 隔离实验建的临时工程，**API 不支持删除工程，请在 EDA 里手动删掉** |
| 2 | 布局美观度 | 五个功能分区已就位且无重叠，但上下两排区域之间留白较大，可再收紧（纯外观，不影响电气） |
| 3 | PCB 布局布线 | 本阶段未做，下阶段按规格书第 5 节分区指引进行 |

---

## 八、文件索引

| 文件 | 说明 |
|---|---|
| `交付说明.md` | 本文件 |
| `schematic_render.png` | 原理图整图渲染 |
| `firmware-patch.diff` | 固件补丁（44 行） |
| `fw/ESP-Music-PCB/固件引脚定义/` | 打过补丁的 board.h / board.c（含 `.orig` 原版） |
| `bom.json` | 元件清单（含 UUID，供 API 放置用） |
| `netlist.json` | 结构化网表（从规格书第 3 节逐条转译） |
| `netlist_protel.txt` | EDA 导出的 Protel 格式网络表（验证用） |
| `refs/pj_320a_symbol.png` | 耳机座符号渲染（判断引脚用） |
| `refs/pj_320a_footprint.png` | 耳机座封装渲染 |
| `refs/pj320a_pinout.svg` | **官方引脚图原图**（坐标证据来源） |
| `refs/pj320a_3p_pinout.svg` | 3 极版官方引脚图（交叉验证用） |
| `refs/PJ-320A_datasheet.pdf` | 立创商城数据手册 |
| `refs/jack_*.png` | 各版本耳机座符号渲染对比 |
| `eda.mjs` | Bridge 调用助手 |
| `gen-wire.mjs` | 接线生成器（网表 → EDA API 调用） |
| `compare.mjs` | 网表比对验证脚本 |
| `apply-fw-patch.mjs` | 固件补丁应用脚本 |
