spring-soft/lychee-music-hardware/pcb/接线表与引脚定义.md

# ESP-Music PCB —— 接线表与引脚定义

**板子**：58.0 × 50.0 mm，四层板　　**工程**：嘉立创EDA专业版 `esp-music-player`

> 本文件由 PCB 实际网络数据生成（数据源 `pads.raw.json`，导出自 EDA）。
> ESP32 引脚号↔GPIO 名取自原理图符号 `ESP32-S3-WROOM-1-N16R8`，权威。

---

## 一、ESP32-S3-WROOM-1-N16R8 引脚定义

模组共 41 个焊盘。**天线端**是 1、40、41 脚（本板这块悬出板边）。

| 脚号 | GPIO | 本板接的网络 | 功能 |
|---:|---|---|---|
| **1** | GND | `GND` | 地 |
| **2** | 3V3 | `VCC` | **3.3V 供电**（VCC，经内层电源平面） |
| **3** | EN | `RESET_N` | **RESET_N** 复位（接 R4/C2/SW5） |
| **4** | IO4 | `LCD_SCLK` | LCD_SCLK 屏 SPI 时钟 |
| **5** | IO5 | `LCD_MOSI` | LCD_MOSI 屏 SPI 数据 |
| **6** | IO6 | `LCD_RST` | LCD_RST 屏复位 |
| **7** | IO7 | `LCD_DC` | LCD_DC 屏数据/命令 |
| **8** | IO15 | `LCD_CS` | LCD_CS 屏片选 |
| **9** | IO16 | `BL_DRV` | BL_DRV 背光驱动（经 R13→Q1） |
| **10** | IO17 | `KEY_K4` | KEY_K4 按键4 |
| **11** | IO18 | `KEY_K3` | KEY_K3 按键3 |
| **12** | IO8 | `KEY_K2` | KEY_K2 按键2 |
| **13** | IO19 | `USB_DN` | **USB_DN**（Type-C D−） |
| **14** | IO20 | `USB_DP` | **USB_DP**（Type-C D+） |
| **15** | IO3 | — | 悬空 |
| **16** | IO46 | — | 悬空 |
| **17** | IO9 | `ENC_A` | ENC_A 旋转编码器 A 相 |
| **18** | IO10 | `ENC_B` | ENC_B 旋转编码器 B 相 |
| **19** | IO11 | `ENC_SW` | ENC_SW 编码器按压 |
| **20** | IO12 | — | 悬空 |
| **21** | IO13 | — | 悬空 |
| **22** | IO14 | — | 悬空 |
| **23** | IO21 | — | 悬空 |
| **24** | IO47 | — | 悬空 |
| **25** | IO48 | — | 悬空 |
| **26** | IO45 | — | 悬空 |
| **27** | IO0 | `BOOT_N` | **BOOT_N**（接 R5 / SW6，下载模式） |
| **28** | IO35 | — | ⚠️ **禁止接任何东西**（N16R8 的 Octal PSRAM 占用） |
| **29** | IO36 | — | ⚠️ **禁止接任何东西**（同上） |
| **30** | IO37 | — | ⚠️ **禁止接任何东西**（同上） |
| **31** | IO38 | `KEY_K1` | KEY_K1 按键1 |
| **32** | IO39 | `I2S_LRCK` | I2S_LRCK 左右声道时钟 |
| **33** | IO40 | `I2S_DOUT` | I2S_DOUT 音频数据输出 |
| **34** | IO41 | `I2S_BCLK` | I2S_BCLK I2S 位时钟 |
| **35** | IO42 | `I2S_MCLK` | I2S_MCLK I2S 主时钟 |
| **36** | RXD0(IO44) | — | 悬空（默认串口 RX） |
| **37** | TXD0(IO43) | — | 悬空（默认串口 TX） |
| **38** | IO2 | `I2C_SCL` | **I2C_SCL**（接 ES8388 + R11 上拉） |
| **39** | IO1 | `I2C_SDA` | **I2C_SDA**（接 ES8388 + R10 上拉） |
| **40** | GND | `GND` | 地 |
| **41** | GND/EP | `GND` | 地（中心散热焊盘） |

### 已用引脚汇总（按功能分组）

- **音频（I2S → ES8388）**：脚32=IO39→`I2S_LRCK`　脚33=IO40→`I2S_DOUT`　脚34=IO41→`I2S_BCLK`　脚35=IO42→`I2S_MCLK`　脚38=IO2→`I2C_SCL`　脚39=IO1→`I2C_SDA`
- **屏幕（SPI → ST7735S）**：脚4=IO4→`LCD_SCLK`　脚5=IO5→`LCD_MOSI`　脚6=IO6→`LCD_RST`　脚7=IO7→`LCD_DC`　脚8=IO15→`LCD_CS`　脚9=IO16→`BL_DRV`
- **按键**：脚31=IO38→`KEY_K1`　脚12=IO8→`KEY_K2`　脚11=IO18→`KEY_K3`　脚10=IO17→`KEY_K4`　脚27=IO0→`BOOT_N`　脚3=EN→`RESET_N`
- **旋转编码器**：脚17=IO9→`ENC_A`　脚18=IO10→`ENC_B`　脚19=IO11→`ENC_SW`
- **USB（原生）**：脚13=IO19→`USB_DN`　脚14=IO20→`USB_DP`
- **电源**：脚2=3V3→`VCC`　脚1=GND→`GND`　脚40=GND→`GND`　脚41=GND/EP→`GND`

### ⚠️ 必须悬空的引脚

| 脚号 | GPIO | 原因 |
|---:|---|---|
| 28 | IO35 | **N16R8 的 Octal PSRAM 内部占用，接任何东西都会导致无法启动** |
| 29 | IO36 | 同上 |
| 30 | IO37 | 同上 |
| 15 | IO3 | strapping 脚（本板已刻意避开，故 K1 从 IO3 改到 IO38） |
| 16 | IO46 | 规格书未用 |
| 20–26 | IO12/13/14/21/47/48/45 | 规格书未用 |
| 36, 37 | RXD0/TXD0 | 默认串口，留作调试焊盘 |

> ⚠️ 网上大多数 ESP32-S3 例程用的是 **N8R2（Quad PSRAM）**，那三根 IO35/36/37 可以随便用。
> **本板是 N16R8，照抄会直接无法启动。**

---

## 二、完整接线表（50 个网络）

### `GND`　地　（57 个连接点）

`C1.2`　`C2.2`　`C3.2`　`C4.2`　`C5.2`　`C6.2`　`C7.2`　`C8.2`　`C9.2`　`C10.2`　`C11.2`　`C12.2`　`C13.2`　`C14.2`　`C17.2`　`C18.2`　`C19.2`　`C20.2`　`C21.2`　`C22.2`　`C23.2`　`C24.2`　`C25.2`　`C26.2`　`C27.2`　`EC1.5`　`EC1.C`　`J1.A1B12`　`J1.B1A12`　`J2.5`　`J3.13`　`J3.15`　`J3.16`　`J3.2`　`J3.5`　`J4.2`　`Q1.2`　`R1.2`　`R2.2`　`R3.2`　`R14.2`　`SW1.2`　`SW2.2`　`SW3.2`　`SW4.2`　`SW5.2`　`SW6.2`　`SW7.2`　`U1.1`　`U1.40`　`U1.41`　`U2.13`　`U2.18`　`U2.29`　`U2.4`　`U3.2`　`U4.9`

### `VCC`　3.3V 数字电源　（26 个连接点）

`C3.1`　`C5.1`　`C6.1`　`C7.1`　`C11.1`　`C12.1`　`FB1.1`　`FB2.1`　`J3.10`　`J3.11`　`R4.1`　`R5.1`　`R6.1`　`R7.1`　`R8.1`　`R9.1`　`R10.1`　`R11.1`　`R18.1`　`R19.1`　`R20.1`　`U1.2`　`U2.2`　`U2.26`　`U2.3`　`U3.5`

### `+5V`　5V 系统电源（IP5306 升压输出）　（11 个连接点）

`C4.1`　`C10.1`　`C23.1`　`C24.1`　`R12.1`　`R15.1`　`R16.1`　`R17.1`　`U3.1`　`U3.3`　`U4.8`

### `VBUS`　Type-C 5V 输入　（5 个连接点）

`C21.1`　`C22.1`　`J1.A4B9`　`J1.B4A9`　`U4.1`

### `BAT+`　电池正极　（4 个连接点）

`C25.1`　`J4.1`　`L1.1`　`U4.6`

### `SW_NODE`　IP5306 开关节点（接电感 L1）　（2 个连接点）

`L1.2`　`U4.7`

### `AVDD`　ES8388 模拟电源（经 FB1 磁珠）　（4 个连接点）

`C8.1`　`C13.1`　`FB1.2`　`U2.17`

### `BL_DRV`　背光驱动信号　（2 个连接点）

`R13.1`　`U1.9`

### `BL_GATE`　背光 MOS 栅极　（3 个连接点）

`Q1.1`　`R13.2`　`R14.1`

### `BOOT_N`　下载模式　（3 个连接点）

`R5.2`　`SW6.1`　`U1.27`

### `CC1`　Type-C CC1（5.1k 下拉）　（2 个连接点）

`J1.A5`　`R1.1`

### `CC2`　Type-C CC2（5.1k 下拉）　（2 个连接点）

`J1.B5`　`R2.1`

### `ENC_A`　编码器 A 相　（4 个连接点）

`C26.1`　`EC1.A`　`R18.2`　`U1.17`

### `ENC_B`　编码器 B 相　（4 个连接点）

`C27.1`　`EC1.B`　`R19.2`　`U1.18`

### `ENC_SW`　编码器按压开关　（3 个连接点）

`EC1.4`　`R20.2`　`U1.19`

### `HP_L`　耳机左声道（经 C15 耦合）　（2 个连接点）

`C15.2`　`J2.2`

### `HP_R`　耳机右声道（经 C16 耦合）　（2 个连接点）

`C16.2`　`J2.3`

### `HPVDD`　ES8388 耳机功放电源（经 FB2 磁珠）　（4 个连接点）

`C9.1`　`C14.1`　`FB2.2`　`U2.16`

### `I2C_SCL`　I2C 时钟　（3 个连接点）

`R11.2`　`U1.38`　`U2.28`

### `I2C_SDA`　I2C 数据　（3 个连接点）

`R10.2`　`U1.39`　`U2.27`

### `I2S_BCLK`　I2S 位时钟　（2 个连接点）

`U1.34`　`U2.5`

### `I2S_DOUT`　I2S 音频数据（ESP→ES8388）　（2 个连接点）

`U1.33`　`U2.6`

### `I2S_LRCK`　I2S 左右声道时钟　（2 个连接点）

`U1.32`　`U2.7`

### `I2S_MCLK`　I2S 主时钟　（2 个连接点）

`U1.35`　`U2.1`

### `KEY_K1`　按键1　（3 个连接点）

`R6.2`　`SW1.1`　`U1.31`

### `KEY_K2`　按键2　（3 个连接点）

`R7.2`　`SW2.1`　`U1.12`

### `KEY_K3`　按键3　（3 个连接点）

`R8.2`　`SW3.1`　`U1.11`

### `KEY_K4`　按键4　（3 个连接点）

`R9.2`　`SW4.1`　`U1.10`

### `LCD_CS`　屏片选　（2 个连接点）

`J3.12`　`U1.8`

### `LCD_DC`　屏数据/命令　（2 个连接点）

`J3.7`　`U1.7`

### `LCD_MOSI`　屏 SPI 数据　（2 个连接点）

`J3.8`　`U1.5`

### `LCD_RST`　屏复位　（2 个连接点）

`J3.6`　`U1.6`

### `LCD_SCLK`　屏 SPI 时钟　（2 个连接点）

`J3.9`　`U1.4`

### `LED_A`　屏背光 LED 阳极　（2 个连接点）

`J3.4`　`R12.2`

### `LED_K`　屏背光 LED 阴极　（2 个连接点）

`J3.3`　`Q1.3`

### `LED1_K`　电量灯1 阴极　（2 个连接点）

`D1.1`　`U4.2`

### `LED1_R`　电量灯1 限流　（2 个连接点）

`D1.2`　`R15.2`

### `LED2_K`　电量灯2 阴极　（2 个连接点）

`D2.1`　`U4.3`

### `LED2_R`　电量灯2 限流　（2 个连接点）

`D2.2`　`R16.2`

### `LED3_K`　电量灯3 阴极　（2 个连接点）

`D3.1`　`U4.4`

### `LED3_R`　电量灯3 限流　（2 个连接点）

`D3.2`　`R17.2`

### `LOUT1`　ES8388 左声道输出　（2 个连接点）

`C15.1`　`U2.12`

### `PWR_KEY`　电源开关（SW7）　（2 个连接点）

`SW7.1`　`U4.5`

### `RESET_N`　复位　（4 个连接点）

`C2.1`　`R4.2`　`SW5.1`　`U1.3`

### `ROUT1`　ES8388 右声道输出　（2 个连接点）

`C16.1`　`U2.11`

### `SHIELD`　Type-C 外壳屏蔽　（6 个连接点）

`C1.1`　`J1.1`　`J1.2`　`J1.3`　`J1.4`　`R3.1`

### `USB_DN`　USB D−　（3 个连接点）

`J1.A7`　`J1.B7`　`U1.13`

### `USB_DP`　USB D+　（3 个连接点）

`J1.A6`　`J1.B6`　`U1.14`

### `VMID`　ES8388 模拟中点　（3 个连接点）

`C19.1`　`C20.1`　`U2.20`

### `VREF`　ES8388 参考电压　（3 个连接点）

`C17.1`　`C18.1`　`U2.10`

---

## 三、电源树

```
Type-C VBUS (5V)
   │
   ├─→ C21, C22 (滤波)
   └─→ U4 IP5306 VIN
            │  （充电 + 升压 + 电源路径管理）
            ├─→ BAT+ ─→ J4 电池座 ─→ 锂电池 3.7V
            ├─→ L1 (2.2µH) ─→ SW_NODE （开关节点）
            └─→ +5V  ──┬─→ C23, C24 (滤波)
                        ├─→ U3 TLV75733 LDO IN
                        ├─→ R12 → LED_A  （屏幕背光）
                        └─→ R15/R16/R17 → LED1-3_R （电量灯）
                                 │
                        U3 LDO OUT ─→ VCC (3.3V)
                                 ├─→ U1 ESP32-S3 (脚2)
                                 ├─→ U2 ES8388 (脚2,3,26)
                                 ├─→ J3 屏幕座 (脚10,11)
                                 └─→ 各上拉电阻 / 退耦电容
```

| 轨 | 电压 | 来源 | 主要负载 |
|---|---|---|---|
| `VBUS` | 5V | Type-C | IP5306 充电输入 |
| `BAT+` | 3.0–4.2V | 锂电池 | IP5306 升压输入 |
| `+5V` | 5V | IP5306 升压输出 | LDO、背光、电量灯 |
| `VCC` | 3.3V | TLV75733 LDO | ESP32、ES8388、屏幕 |
| `AVDD` | 3.3V | VCC 经 FB1 磁珠 | ES8388 模拟部分 |
| `HPVDD` | 3.3V | VCC 经 FB2 磁珠 | ES8388 耳机功放 |

---

## 四、固件引脚定义对照（`board.h`）

| 宏 | GPIO | 本板网络 | 对应模组脚号 |
|---|---:|---|---:|
| `BOARD_PIN_I2C_SDA` | 1 | `I2C_SDA` | 39 |
| `BOARD_PIN_I2C_SCL` | 2 | `I2C_SCL` | 38 |
| `BOARD_PIN_I2S_MCLK` | 42 | `I2S_MCLK` | 35 |
| `BOARD_PIN_I2S_BCLK` | 41 | `I2S_BCLK` | 34 |
| `BOARD_PIN_I2S_WS` | 39 | `I2S_LRCK` | 32 |
| `BOARD_PIN_I2S_DOUT` | 40 | `I2S_DOUT` | 33 |
| `BOARD_PIN_LCD_SCLK` | 4 | `LCD_SCLK` | 4 |
| `BOARD_PIN_LCD_MOSI` | 5 | `LCD_MOSI` | 5 |
| `BOARD_PIN_LCD_RST` | 6 | `LCD_RST` | 6 |
| `BOARD_PIN_LCD_DC` | 7 | `LCD_DC` | 7 |
| `BOARD_PIN_LCD_CS` | 15 | `LCD_CS` | 8 |
| `BOARD_PIN_LCD_BLK` | 16 | `BL_DRV` | 9 |
| `BOARD_PIN_KEY1` | 38 | `KEY_K1` | 31 |
| `BOARD_PIN_KEY2` | 8 | `KEY_K2` | 12 |
| `BOARD_PIN_KEY3` | 18 | `KEY_K3` | 11 |
| `BOARD_PIN_KEY4` | 17 | `KEY_K4` | 10 |

**已删除的宏**（自制板不适用）：

- `BOARD_PIN_I2S_DIN` —— 不录音，ES8388 ADC 已断电，I2S 通道是 TX-only
- `BOARD_PIN_PA_EN` —— 已去掉 PAM8406 功放，ES8388 内置耳放直推耳机

> ⚠️ `BOARD_PIN_KEY1` 从 **GPIO3 改到了 GPIO38**（避开 strapping 脚）。
> **不打固件补丁就烧录，K1 会直接失效**（固件轮询悬空的 IO3，永远读到"未按下"）。
> 补丁见 `firmware-patch.diff`。

**ES8388 I2C 地址**：`0x11`（7 位）＝ `0x22`（8 位）。由 `CE` 脚接 VCC 决定。
