spring-soft/lychee-music-hardware/docs/开发记录/方案与进度（正式）.md

# ESP-Music：纯原生音乐终端（脱离 esp-claw，从零新建工程）

## Context — 为什么做这件事

现在这台 ESP32-S3（ESP32-S3-COREBOARD V1.4 + ES8388/PAM8406 音频板 + ST7735 屏 + K1–K4）上的音乐功能，跑在 **esp-claw 框架**的 Lua 技能里（源码 `/home/lychee/esp32s3-backup/k3_voice_chat_music/`，部署在设备 `/fatfs`）。

踩到的坑**全部来自框架**：Lua 200 local 上限导致脚本被迫分片、`SKILL.md` 超限让 `app_claw_start` abort（只能重烧）、主循环缺延时饿死 LVGL、**GMF 音频组件内存破坏 bug 导致 FLAC 直传必崩**、`managed_components` 的 4 处手改补丁一拉依赖就丢。实测现在 esp-claw 固件已把 **app 分区吃到 93%**（3.46MB / 3.89MB）。

用户决定：**另起一个纯原生 ESP-IDF 工程**，只保留「本地播放 + 屏幕按键 UI + 蓝牙遥控」，并新增一个**网页控制台**；不做语音对话(ASR/AI)与 IM 通道。设备定位从「AI 助手」变成「纯音乐终端」。

## 步骤 0：先备份现有 esp-claw 固件（烧录前必做，用户要求）

**为什么必须重做**：现有备份 `~/esp32s3-backup/esp-claw-*-20260918.img` 是 **2026-09-18** 拍的，里面的固件是 **8/14** 构建的；而设备上正在跑的是 **9/19 21:46** 构建的版本（含 DI/DO 接反修正、PA gain 6→0、WiFi 关省电、128KB 预取缓冲、64KB 解码缓冲、skill 上限 20K→32K、新分区表），设备上的 NVS 配置与 `/fatfs` 内容（音乐脚本、歌单、录音）也都比备份新。**9/18 那份不等于当前状态。**

要做的（写入 `~/esp32s3-backup/`，文件名带今天日期）：

1. **整片 16MB flash 转储**（最彻底的还原源）
   `python -m esptool --chip esp32s3 -p /dev/ttyACM0 -b 921600 read_flash 0 0x1000000 esp-claw-full-20260924.img`
2. **分区切片**（便于单独还原）：按 esp-claw 分区表切出 nvs(`0xA000,0x6000`)、otadata(`0x10000,0x2000`)、app(`0x20000,0x3B6000`)、system(`0x3D6000,0x28A000`)、storage(`0x660000,0x800000`)，并校验切片与整片对应区域**逐字节相等**（沿用上次的做法）
3. **固件二进制副本**：`application/edge_agent/build/` 下的 `bootloader/bootloader.bin`、`partition_table/partition-table.bin`、`ota_data_initial.bin`、`edge_agent.bin`、`system.bin`、`storage.bin` —— 有这些就能不重编译直接还原
4. **源码侧状态**（最容易丢的一块）：
   - `git diff` 全量导出（11 个已修改文件）
   - 未跟踪项：`boards/espressif/esp32_S3_DevKitC_1/*.bak`、`components/lua_modules/lua_module_audio/skills/`、`components/lua_modules/lua_module_display/skills/`、`partitions_*.csv.bak*`
   - **两个 `managed_components` 手改补丁**：`espressif__gmf_io/include/esp_gmf_io_http.h`、`espressif__gmf_audio/esp_gmf_audio_dec.c`（重拉依赖会被覆盖，必须单独存）
   - 现有 `ESP-CLAW-固件改动清单.md` 一并保留
5. **更新备份目录 `README.md`**：记录新备份的 md5、还原命令、并标注 9/18 那份是旧版
6. 校验：`md5sum` 全部记进 README

**还原方式**（写进 README，将来照做）：
```bash
# 整片还原（最彻底）
python -m esptool --chip esp32s3 -p /dev/ttyACM0 -b 921600 write_flash 0 0x1000000 esp-claw-full-20260924.img
# 或只还原可写数据（保留其它部分）
python -m esptool --chip esp32s3 -p /dev/ttyACM0 -b 921600 write_flash \
  0xA000 esp-claw-nvs-20260924.img 0x660000 esp-claw-storage-20260924.img
```

板子 MAC `44:b1:76:cc:d6:38`；烧录口 `/dev/ttyACM0`（原生 USB-Serial-JTAG，可用 921600）。

## 板级参数（已核实）

| 项 | 数值 | 依据 |
|---|---|---|
| 芯片 / 模组 | ESP32-S3 / N16R8 | 原理图 + 模组丝印 |
| Flash | **16MB** QIO@80MHz | `CONFIG_ESPTOOLPY_FLASHSIZE_16MB=y` |
| PSRAM | **8MB Octal** @80MHz | `CONFIG_SPIRAM_MODE_OCT=y` |
| CPU | 240MHz 双核；**无硬件 ASRC、无硬件 JPEG** | `soc_caps.h` 核实 |
| 内部 SRAM | 512KB（**唯一紧张的资源**） | S3 规格 |

引脚（已核实，直接搬）：

| 用途 | GPIO |
|---|---|
| ES8388 I2C | SDA=1, SCL=2（**I2C 地址填 0x22 八位形式**，内部 `>>1`） |
| ES8388 I2S | MCK=42, BCK=41, WS=39, DOUT=40, DIN=38（丝印 DO→dout、DI→din，不交叉） |
| PAM8406 使能 | 47（高有效） |
| ST7735 | SCLK=4, MOSI=5, RST=6, DC=7, CS=15, BLK=16（SPI2 @40MHz） |
| 按键 | K1=3, K2=8, K3=18, K4=17（低电平按下，内部上拉；**K1/GPIO3 是 strapping 脚**，开机按住会进 JTAG，需提示） |

**预算**：app 预计 1.8–2.4MB（字体/图片都在 assets 分区，不进 app）；PSRAM 用约 1MB；内部 SRAM 峰值约 290KB（WiFi 80K + BLE 40K + HTTP 40K + I2S DMA 12K + 解码状态 40K + 任务栈 44K + LVGL 12K + JPEG 20K），留 100K+ 余量。**铁律：大队列/缓冲/画布全进 PSRAM，内部 SRAM 只放协议栈、任务栈、DMA 描述符**。

## 需求（已与用户逐条确认）

| # | 功能 | 要点 |
|---|---|---|
| 1 | 本地播放 | Navidrome 拉流 → ES8388 出声；**真实可信用播放位置**（进度条 + 歌词对齐 + seek） |
| 2 | 网页控制台 | 播放控制、选歌、歌单、**一键随机 30 首**、**最近播放**、**收藏（与 Navidrome 双向同步）**、Navidrome 地址/账号/密码配置、WiFi 配置（扫描+点选+**不重启生效**）。**不设鉴权**（用户要求）、**默认开启 SoftAP** |
| 3 | 屏幕 + 按键 UI | **浅色系**（用户明确要求）；播放页 / 列表页 / 菜单页 / 音量页 |
| 4 | 蓝牙遥控 | K1–K4 当 BLE HID 遥控器控制手机/PC 播放 |
| 5 | 流畅不卡 | 用户硬要求；预渲染位图 + 局部刷新 + 优先级隔离 |

**屏幕版面（160×128，浅色）**

- 播放页：顶栏 = `♪` 符号 + **歌名（只显歌名、截断、不带作者）**；主体 = 封面 72×72（左）+ **歌词区**（右，80×92，3 行，当前行高亮）；底部 = 进度条 152×6 + `01:23/04:12`
- 列表页：顶栏 = 列表名 + 位置计数；**5 行**，无按键提示行
- 菜单页：6 行窗口滚动；音量页：大字数字 + 长条
- 三种显示模式（K4 短按循环）：封面+歌词 → 全屏歌词 → 全屏封面

**按键语义（用户确认）**

| 页面 | K1 | K2 | K3 | K4 |
|---|---|---|---|---|
| 播放页·短按 | **下一首** | 播放/暂停 | **上一首** | 切换显示模式 |
| 播放页·长按 | 收藏/取消收藏 | 音量页 | 列表页 | 菜单 |
| 列表页·短按 | 上一行（长按连滚 150ms/行） | 下一行（长按连滚） | 播放选中 | 返回播放页 |
| 列表页·长按 | 上一个来源 | 下一个来源 | — | — |
| 菜单页 | 上 | 下 | 确认 | 返回 |
| 音量页 | 音量−（长按连调） | 静音 | 音量＋（长按连调） | 返回 |

来源循环：最近播放 → 我的收藏 → 随机 30 首 → 当前歌单（切换时 toast 提示来源名并重建队列）。

## 技术选型

- **全新独立工程** `/home/lychee/esp-music/`，纯 C，IDF **v5.5.4**，不含 esp-claw / Lua / GMF
- 依赖全部用本机离线缓存（`~/.cache/Espressif/ComponentManager/service_d92d8f1e/`）：

```yaml
dependencies:
  idf: ">=5.5,<5.6"
  espressif/esp_codec_dev: "==1.6.2"      # 含 device/es8388
  espressif/esp_audio_codec: "==2.5.0"    # MP3/AAC/FLAC 解码器（esp32s3 预编译库）
  lvgl/lvgl: "==9.6.0"
  espressif/esp_new_jpeg: "~1.0.2"        # 封面（S3 走软件路径）
  espressif/cjson: "~1.7.19"
  waveshare/esp_lcd_st7735: "==2.0.0"     # IDF 5.5.4 无内置 st7735
  espressif/button: "~4.2.1"              # 短按/长按/长按保持
  espressif/mdns: "~1.13.1"               # esp-music.local
# 绝不出现 esp_audio_simple_player / gmf_*
```

**7 条已核实、会改变实现方式的事实**（实现时必须遵守）：

1. `esp_codec_dev` 1.6.2 的 `es8388_open()` 写 `0x2E/0x2F=0x1E(0dB)` 但 **`0x30/0x31=0x00(-30dB)`**；`esp_codec_dev_set_out_vol()` 只动数字音量 `0x1A/0x1B` → **混合音量必须自己直写 `0x2E–0x31` 四个寄存器，且每次 `esp_codec_dev_open()` 后必须重新施加**（open 会清掉）。
2. I2C 地址填 **0x22**（8 位形式），且 `CONFIG_CODEC_I2C_BACKWARD_COMPATIBLE=n` 时要传 `bus_handle`。
3. ES8388 的 I2C 写入会**静默失败**（用户自己的原生测试已证明：MASTERMODE 会变成 0x80 → 完全无声）→ 初始化必须"**写→读回→重试 8 次**"并统计重试次数。
4. **S3 没有硬件 ASRC** → ❌ 纠正我之前的说法：**主路径不做重采样**，改为首次拿到采样率时**重配 I2S 时钟**（`i2s_channel_reconfig_std_clock/slot` + 重开 codec + 重新施加音量）；软件重采样只作退路。
5. IDF 5.5.4 **无内置 st7735 panel 驱动**、`esp_lvgl_port` 也不在缓存里 → 用 `waveshare/esp_lcd_st7735` + **自写约 90 行 LVGL port**。
6. LVGL 9.6.0 有 `lv_binfont_create_from_buffer()` → 字体可零拷贝从 flash mmap 加载，RAM 占用约 0。
7. 字体源用 `/usr/share/fonts/truetype/droid/DroidSansFallbackFull.ttf`（**单面 TTF**，全 CJK；系统里 Noto CJK 是 `.ttc`，`lv_font_conv` 读不了）。注意它 ASCII 是**全角**，子集要排除 ASCII，靠 fallback 到 `lv_font_montserrat_*`。本机已装 Pillow 10.2.0，PNG→RGB565 与字体退路都能纯 Python 离线做。

## 工程结构

```
/home/lychee/esp-music/
├── CMakeLists.txt / sdkconfig.defaults[.esp32s3] / partitions.csv
├── assets_src/{ui/*.png, font/, web/index.html}
├── tools/{gen_ui_png.py, gen_assets.py, gen_font.sh, gen_font_pil.py}
├── components/
│   ├── app_core/        # 事件/命令/状态快照（不依赖任何东西）
│   ├── board/           # I2C/I2S/SPI/GPIO + ES8388 封装 + 混合音量 + 写校验重试
│   ├── assets/          # assets 分区 mmap + 索引
│   ├── audio_engine/    # 管道：fetch→ring_in→decode→ring_pcm→i2s out；位置/seek ★心脏
│   ├── subsonic/        # Navidrome 客户端：ping/列表/流/收藏/歌词/封面
│   ├── store/           # NVS 配置 + FATFS 缓存
│   ├── net_mgr/         # WiFi STA+AP、扫描、mDNS、PS 切换
│   ├── hid_remote/      # NimBLE HID 消费类遥控
│   ├── ui/              # LVGL 页面 + port + 按键分发
│   └── web_console/     # esp_http_server + REST API + 静态资源
└── main/app_main.c      # 只做编排
```

依赖严格单向：`ui / web_console / hid_remote / net_mgr` **互不引用**，全部经 `app_core` 的命令队列 + `esp_event` 交互 —— 从结构上隔离"一个任务拖死 UI"。

## 分区表（16MB，总和正好）

**分区表偏移刻意对齐 esp-claw**（表在 0x9000、nvs 在 0xA000，而不是 IDF 惯例的 0x8000）：这样新旧固件占用的是同一批 flash 区域，不会留下"残表"；将来整片还原 esp-claw 就是一条命令。设 `CONFIG_PARTITION_TABLE_OFFSET=0x9000`。

```csv
# Name,     Type, SubType, Offset,   Size
nvs,        data, nvs,     0xA000,   0x6000,     # 24K 配置（与 esp-claw 同位置）
otadata,    data, ota,     0x10000,  0x2000,
phy_init,   data, phy,     0x12000,  0x1000,
ota_0,      app,  ota_0,   0x20000,  0x300000,   # 3M 主固件（与 esp-claw app 同起点）
ota_1,      app,  ota_1,   0x320000, 0x300000,   # 3M OTA 备槽（以后改 UI 走 WiFi 升级）
assets,     data, spiffs,  0x620000, 0x200000,   # 2M 预渲染图/字体/网页
cache,      data, fat,     0x820000, 0x7E0000,   # 7.875M 封面/歌词/最近/收藏
```

**资产与网页放分区 + mmap，不嵌进 app**：改一行 HTML 或一张图只需烧 700KB，且 mmap 指针可直接当 `lv_image_dsc_t.data` 和 `httpd_resp_send_chunk()` 的源（零拷贝）。构建期用 IDF 自带的 `esptool_py_flash_to_partition()` 注册烧写。唯一禁忌：mmap 指针不能直接交给 SPI DMA（LVGL 会先绘进 RAM 的 draw buffer，所以走 LVGL 就没事）。

## 任务模型（S3 双核；WiFi/BT 协议栈默认钉 core 0）

| 任务 | 核 | 优先级 | 栈 | 职责 |
|---|---|---|---|---|
| `audio_out` | **1** | **19** | 4K | `ring_pcm` → `esp_codec_dev_write()`；统计 `frames_queued`、underrun |
| `key_dispatch` | 1 | 12 | 3K | 按键事件 → `music_cmd_t` 分发 |
| `audio_decode` | 1 | 8 | 8K | `ring_in` → `esp_audio_simple_dec_process()` → 归一化 → `ring_pcm` |
| `ui_lvgl` | 1 | 5 | 8K | `lv_timer_handler()` + 10ms 睡眠；页面切换/局部刷新 |
| `audio_fetch` | **0** | 6 | 6K | HTTP 读 → 直接写进 `ring_in` 空闲区（零拷贝） |
| `httpd` / `net_mgr` / `meta_fetch` / `cover_decode` | 0 | 5/5/4/3 | — | REST、WiFi、元数据、封面解码 |
| NimBLE host | 0 | 21 | — | 广播/连接/HID report |

**避免 UI 卡顿的四条硬措施**：① 音频路径优先级严格高于 UI；② **解码任务每帧 `vTaskDelay(1)`**，把 UI 最坏延迟钉在 1 tick（不做这个，解码会连跑满缓冲才让出，UI 最长停顿约 700ms —— 这正是老实现"忙死"的形态）；③ 网络/TLS/JSON/JPEG 全在 core 0，不跟 UI 抢核 1；④ 运行时**绝不创建/销毁 widget**（4 个页面 + toast 开机全建好，切换只改 `HIDDEN` 标志和图像 src），避免碎片化。

**缓冲**：`ring_in` 128KB（沿用实测有效的预取量）+ `ring_pcm` 128KB，都在 PSRAM；I2S DMA `6×1024 帧 ≈ 139ms`（**抗 WiFi/BT 尖峰的真正主力**）。ring 提供 `read_span_or_pack()` —— 数据绕回时把尾部 memmove 到头部，保证解码器总能拿到连续帧（`esp_audio_simple_dec_process` 只能吃连续 buffer，这是最容易踩的坑）。所有阻塞等待都用 100ms 超时循环 + 检查**代际号 `gen`**，切歌时立刻退出而不是傻等。

**代际号**：每次切歌 `gen++`；封面/歌词/元数据等异步结果带 `gen`，回来时 `gen` 不符直接丢弃 —— 否则快速连按"下一首"必然封面串台。

## 音频管道

**初始化序列**（`board` 组件）：PA 使能(47) → I2C 新驱动(`i2c_new_master_bus`) → I2S TX(`i2s_new_channel` + `i2s_standard_philips`，16bit/stereo/MCLK=256×) → `esp_codec_dev` 包装 ES8388（**addr=0x22**）→ `esp_codec_dev_open()` → **`board_vol_apply()`（必须在 open 之后）**。

**混合音量**（自己实现，实测"变干净了"）：

```
percent → 目标衰减 dB（0%→-60dB, 100%→0dB）
衰减 ≤30dB : 用模拟音量 0x2E–0x31（0x1E=0dB, 0x00=-30dB），数字音量 0x00
衰减 >30dB : 模拟置 0x00(-30dB)，超出部分用 esp_codec_dev_set_out_vol() 降数字
★ 0x2E/0x2F/0x30/0x31 四个都要写（0x30/0x31 若漏写，走 LOUT2/ROUT2 的耳机白掉 30dB）
```

按键连调音量不要每次都写 I2C（写+读回校验约 2–4ms）：UI 只更新 `target_vol` 原子量，由 `audio_out` 每 100ms 检查差异后再写。

**播放/换曲/seek**：`/rest/stream?id=..&u=..&t=<md5(pass+salt)>&s=<salt>&v=1.16.1&c=esp-music&f=json&format=mp3&maxBitRate=192[&timeOffset=<s>]`（**必须显式 `format=`**，只给 `maxBitRate` Navidrome 会默认给你 **Opus**）。解码循环处理三种返回：`BUFF_NOT_ENOUGH`→按 `needed_size` 扩容重试（**FLAC 单帧远大于 MP3，绝不能按 MP3 定死 16KB**）、`DATA_LACK`→等更多输入、`OK`→commit + 归一化(mono→stereo / 24,32bit→16bit)后写 `ring_pcm`；FLAC 需 `raw.eos=true` 收尾才不丢尾帧。

**格式嗅探**（不依赖 URL 扩展名，老实现就栽在这里）：peek 前 8KB 判 `ID3`/`FF Fx`→MP3、`fLaC`→FLAC、`OggS`→Vorbis、`RIFF..WAVE`→PCM、`FF F1/F9`→AAC、`ftyp`→M4A，都不匹配就按 MP3→AAC→FLAC 顺序试 `open()`。判定结果 + 前 16 字节 hex + `sample_rate/channel/bits` 一起打日志。

**真实播放位置**（这是"必须可信"的核心）：

```
audible_frames = frames_queued - dma_depth(6144 帧)      # 只可能在 write 成功后累加
position_ms    = base_ms + audible_frames * 1000 / sample_rate
```

由**已交给 DMA 的 PCM 帧数**推导，不是墙钟 —— 网络卡顿/任务抢占/暂停都不会让它漂移或跳变，且单调递增；暂停时继续写静音但不累加（位置冻结）。每 10s 打一条自检日志跟手机秒表对账（偏差应 <200ms 且不累积）。

**seek**（Navidrome 只在"真转码"分支尊重 `timeOffset`，否则回落到 raw + **静默忽略** `timeOffset`，表现为"seek 后从头播"）：

```
if (Content-Length == getSong().size 或 Accept-Ranges: none → 说明没转码)
     → 走 Range: bytes=<推算偏移>-（FLAC 用帧头 sample number 反算精确位置；MP3 按 CBR 估算，误差 1–3s）
else → 新请求加 timeOffset=<秒>（OpenSubsonic transcodeOffset 扩展）
esp_audio_simple_dec_reset() → frames_queued=0 → gen++ → 恢复
```

每次 seek 都打日志记录**实际走了哪条 + 返回码 + Content-Length**，这是排查 seek 问题的唯一线索。

**解码器开关**：只开 MP3/AAC/FLAC/PCM（Vorbis 视需要），其余全关省体积。默认配置 `transcode=mp3@192k`（服务端转码，格式永远简单可靠、seek 最省事），FLAC 直传作为高级选项 —— 出问题不影响主流程。

**WiFi**：播放中 `esp_wifi_set_ps(WIFI_PS_NONE)`，空闲 30s 后恢复 `MIN_MODEM`。

## 存储

**NVS**（namespace 分组，key ≤15 字符）：`net/{ssid,pass,ap_ssid,ap_pass,ap_on,hostname}`、`nd/{host,user,pass,transcode,maxbr,insecure,ok}`、`ui/{vol,dmode,bright,gapx,gapy,mirror,swap,invert,bgr}`、`play/{src,srcid,lastid,lastpos}`。

**FATFS（`cache` 分区 + wear levelling）**：`recent.json`（最近 50 条，**10s 去抖**落盘）、`starred.json`、`playlists.json`、`cover/<id>.565`（72×72 RGB565=10,368B，上限 300 个）、`lrc/<id>.json`。超限按 mtime 删到 80%。不用 NVS 存列表（反复写大 blob 磨损快、原子性差）。

## 网页控制台

**REST API**（`/api/*`，无鉴权）：`status`（含 state/pos/dur/vol/queue/net/bt/gen）、`play`/`pause`/`resume`/`toggle`/`next`/`prev`/`seek`/`volume`、`sources`/`source`/`queue`/`queue/play`/`queue/append`、`playlists`/`search`、`starred`/`star`/`recent`、`cover/<id>`（**必须代理**：AP 模式下手机没有到 Navidrome 的路由，也不暴露凭据）、`lyrics/<id>`、`config`（GET/POST，POST 保存前先 `ping` 校验）、`wifi/scan`（**异步，绝不在 httpd 任务里阻塞 4 秒**）+ `wifi/scan/result` + `wifi`（不重启生效）+ `wifi/status`、`ap`、`display`（屏幕校准）、`hid`、`debug`（堆水位/任务栈/underrun/i2c_retries）。

**状态推送：1000ms 轮询 + 前端本地插值**（不做 SSE/WebSocket）。`/api/status` <1KB，1s 一次对局域网无压力，且手机休眠回来不用重连。进度条流畅度靠前端用 `performance.now()` 每 100ms 外推，切歌靠 `gen` 重置。**不要**为"求流畅"把轮询降到 250ms（会让 httpd 频繁醒，反而干扰音频）。

**前端**：`assets_src/web/index.html` 单文件、**浅色系**、内联 CSS/JS/SVG、**零外部引用**（AP 模式无 DNS/公网，任何 CDN 都会白屏）。分块：状态条 / 播放器卡（封面+歌名+进度可拖+控制+音量+收藏心形）/ 来源 Tab（最近·收藏·随机30·歌单）/ 歌曲列表 / 搜索框（debounce 400ms）/ 设置面板（Navidrome、WiFi 扫描点选、SoftAP 开关、显示校准、HID）/ 断连横幅。`gen_assets.py` 同时产出 `index.html.gz`（约 9KB），按 `Accept-Encoding` 发送。

## UI 实现（浅色系）

**页面结构**：`scr_play`（bg_img 预渲染底图 + topbar 符号/歌名 + cover 72×72 + lyr_box 3 行 + prog_track/prog_bar + 时间 + toast）、`scr_list`（5 行 + 高亮条 + 正在播标）、`scr_menu`（6 行窗口）、`scr_vol`。切换用 `lv_screen_load`（4 屏全预建），**显示模式切换不换屏**，只改 `HIDDEN` + 换底图 src。

**预渲染资产清单（约 262KB，全部进 assets 分区）**：`bg_play_a/b/c`（160×128×3）、`bg_list`、`bg_menu`、`bg_vol`（各 40,960B）、`hl_row`(160×20)、`hl_menu`(160×16)、图标 10×10 ×11 个、`placeholder_cover`(72×72)。流程：`gen_ui_png.py` 用 PIL 按固定坐标画底图（**代码可复现，改设计改脚本**）→ `gen_assets.py` 打包 RGB565 小端 + 生成 `assets_index.h`。

**中文字库**：`lv_font_conv` 生成 LVGL bin 字体 → 放 assets 分区 → `lv_binfont_create_from_buffer()` **零内存占用**。字形集 GB2312 一级 3755 字 + 标点，**16px / 2bpp ≈ 270KB**；fallback 到 `lv_font_montserrat_14`（ASCII 走它）。退路：`gen_font_pil.py` 纯 PIL 生成 LVGL C 源（编进 app，+270KB），或 `LV_USE_FREETYPE` + `esp_lv_fs`（assets 扩到 5MB）。

**避免整屏重绘的三条硬规则**：① 底图用 `lv_image`，只在切页/切模式时换 src；② 所有动态元素**小面积**且**父对象无填充/无圆角/无阴影**（圆角+阴影会把重绘区扩到整块，这是 LVGL 最常见的性能陷阱；视觉圆角由预渲染底图提供）；③ 定时器里先比较再 invalidate。进度条 4Hz 更新（`lv_bar_set_value(..., LV_ANIM_OFF)`，重绘面积 912B≈0.2ms）；歌词 200ms 检查行号，只在 `idx` 变化时改文本（重绘 7KB≈1.5ms）。

**歌词**：`getLyricsBySongId`（OpenSubsonic，**毫秒级 `line[].start`**）→ `idx = upper_bound(lines[].t <= pos_ms + user_offset_ms) - 1`，位置来源就是上面的真实位置，所以**歌词与声音天然对齐**；菜单给 ±0.5s 微调（存 NVS）。无同步歌词时（`synced=false`）按行数均分时长做匀速滚动并标注。`getLyrics`（artist+title）只作兜底（会串歌）。

**屏幕校准**：ST7735 有 green-tab/red-tab 差异，把 `gapx/gapy/mirror/swap/invert/bgr` 全做成**运行时可变**（NVS + 菜单 + `/api/display`），改完立刻 `esp_lcd_panel_set_gap/mirror/swap_xy/invert_color` 生效 —— 第一次点屏就不用反复改代码重烧。

## BLE HID 遥控

`esp_hid` + NimBLE：`nimble_port_init` → GAP `ble_svc_gap_device_name_set("ESP-Music Remote")` → `esp_hidd_dev_init(ESP_HID_TRANSPORT_BLE)`。Report Map 用 Consumer 位掩码（play/pause 0xCD、next 0xB5、prev 0xB6、vol ±0xE9/0xEA、mute 0xE2、stop 0xB7、FF/RW 0xB3/0xB4）；发送用 `esp_hidd_dev_input_set()` + 20ms 后发**释放**（否则主机当长按）。配对用 `BLE_SM_IO_CAP_NO_IO`（Just Works）；若某主机强制 MITM，改 `DISP_ONLY` + `sm_mitm=1` 并在 LCD 上显示 6 位 passkey（我们有屏幕，很划算）。**WiFi 必须先于 BT 初始化**；`CONFIG_SW_COEXIST_ENABLE=y`；若播放中出咔哒声改 `ESP_COEX_PREFER_WIFI`。**BLE 失败必须非致命**（只置 `bt.available=false`，播放完全不受影响）。

## 里程碑（每阶段都能上真机验证）

| 阶段 | 目标 | 验收要点 |
|---|---|---|
| **M0** 骨架+bring-up | 能编译烧写；硬件"看得见" | I2C 扫描到 0x11；ES8388 初始化失败 0 项 + **I2C 重试次数为个位数**；关键寄存器复查 `08=00 17=18 18=02`；**实测 WS=4410/100ms @44.1k**；屏出彩条；4 键短/长按打印 |
| **M1** 本机音频（不出网） | 解码→I2S→ES8388 出声 | assets 里放本地 MP3/FLAC 走同一套管道；日志 `[sniff]`/`[dec] info`/`[out] pos=..`；**MP3 干净无爆音；FLAC 直传不崩（老坑回归测试）** |
| **M2** 联网 + Navidrome | WiFi + ping + 随机 30 + stream 出声 | `[http] status=200 accept_ranges=none`；**位置与秒表偏差 <200ms**；切 raw 放 FLAC 验证嗅探/ Range |
| **M3** UI 播放页 | 封面+歌名+进度+歌词，不卡 | `[ui] fps≈30 lv_timer_max=8ms`（>30ms 即有问题）；连按 10 次下一首**无崩溃、无封面串台**、free heap 稳定 |
| **M4** 按键+4 页+来源 | 键位语义完全符合确认表 | 列表页连滚、切来源 toast、菜单 8 项；**长按 K1 收藏后 Navidrome 网页确实已星标** |
| **M5** 网页控制台 | SoftAP 默认开；手机连上即可控 | `curl /api/status|jq`、`/api/seek`、`/api/wifi/scan`→`/api/wifi` **不重启切换且音乐不断**；**飞行模式（只连 AP）下页面样式/图标完全正常**；手机点下一首到出声 <1.5s |
| **M6** 收藏/最近同步 | 与 Navidrome 双向一致；重启不丢 | 双向星标验证；`getStarred2` 数量对齐；连播 40 首后 `ls /fs/cover` ≈40；重启恢复上次曲目与位置 |
| **M7** BLE HID | 手机/PC 配对后按键可控对方播放 | `bluetoothctl` 配对；PC 播放器响应 K1/K2/K3；BLE 连着 + 播放 + 网页同开 10 分钟 underrun 保持 0 |
| **M8** 打磨+长稳 | seek 全路径、歌词偏移、屏幕校准、故障恢复 | seek 矩阵 12 组误差 <1s；拔网线/关 Navidrome 不崩且 10s 自动重试；8 小时长稳 underrun/lv_timer 超时计数为 0；`psram_largest >2MB`；上电到出声 <8s |

**实现顺序上的两个"不要"**：① **M1 之前不碰 Navidrome** —— 先用本地文件把"解码→ring→I2S→ES8388"打通，让"能出声且是对的"变成只有 3 个变量的实验（老实现的教训是一开始就把网络+解码+UI+框架全叠上，出问题无法二分定位）；② **UI 不得直接调音频引擎内部函数** —— 三路（按键/网页/HID）并发控制必须经 `app_core` 命令队列。

## 实施进度

| 阶段 | 状态 | 证据 |
|---|---|---|
| **M0** 骨架 + 板级 bring-up | ✅ 完成 | I2C 扫到 0x11；ES8388 初始化 **失败 0 项 / I2C 重试 0 次**；关键寄存器 `08=00 17=18 18=02`；WS 实测 47910Hz；耳朵验收通过（干净 440Hz + 静音段安静）。工程 `~/esp-music/`，分区表 0x9000 对齐 esp-claw |
| **M1** 本机音频管道 | ✅ 完成（耳朵验收通过） | MP3 12.042s → 位置 11814ms + 185ms DMA = 11.999s，**underrun 0**；**FLAC 直传完整播完不崩**（老 GMF bug 的回归测试通过）；已修：解码器两层注册、ring_pcm 超时丢 PCM、采样率切换未静音、i2s 部分写入未 commit、defrag 并发、"咔哒声"（真凶是测试素材硬切 → 见 [[esp-music-audio-click-sources]]） |
| **M2** 联网 + Navidrome 拉流 | ✅ 完成（用户确认"听到在正常播放"） | WiFi 连上 <WiFi 名> (RSSI -55~-66)；`ping ok: navidrome 0.63.2-SNAPSHOT`；`getRandomSongs` 取到 30 首；服务端转 mp3 192k 流式播放 **underrun 0**，连播 104 秒稳定。踩坑与实测事实见 [[esp-music-navidrome-verified]] |
| **M3** UI 播放页 | ✅ 完成 | 显示定标 invert=0/RGB/RGB565_SWAPPED（见 [[esp-music-display-calibration]]）；启动页 6 步；启动到出声 **5.1s → 3.8s**；封面 gen 对账无串台；`lv_timer` 最坏 4~45ms、刷新 5~9 次/5s |
| **M4** 按键 + 4 页 + 来源 | ✅ 完成（待用户按键验收） | `player` 命令层（core0/prio5，见 [[esp-music-m4-keys-player]]）；K1-K4 用 `espressif/button`；列表/菜单/音量三页；来源=最近/收藏/随机30（第四来源"当前歌单"砍掉）；自动连播 + 出错重试/跳过；**内部 SRAM 起播后只剩 29KB（M7 风险）** |
| **M4 顺带修** | ✅ | `sdkconfig.local` 改了对已存在的 sdkconfig 无效 → 加 `tools/sync_sdkconfig.py`（见 [[esp-music-sdkconfig-local-trap]]）；回退路径忘了收起启动页；音量数字慢一拍的竞态（请求值/已写值分离） |
| **M5** 网页控制台 | ✅ 完成 | 28 个接口 + 27KB 单页（3 tab + 迷你播放器 + 歌词 + 动画）；点歌卡顿 4× 提升（`Connection: close` + `LWIP_MAX_SOCKETS=16` + 元数据快路径）；中文搜索（httpd 不做 URL 解码）；见 [[esp-music-m5-web-console]] |
| **M6** 最近/收藏落盘 + 双向同步 | ✅ 完成（待用户验收） | 新组件 `components/store/`（cache 分区 FATFS+WL，首次上电自动格式化）；最近播放/收藏/封面缓存落盘、开机续播上次位置（实测毫秒级对得上）、收藏本地镜像 + 待重试队列；**踩到两个静默失败的 bug**（FATFS rename 不覆盖目标、8.3 校验把整条路径当一段）见 [[esp-music-m6-persistence]]。⚠️ 待重试队列的在线补发**没做故障注入验证** |

| **M7** 蓝牙 HID 遥控 | ⏳ 机制全部打通（待用户用手机最终确认） | 新组件 `components/hid_remote/`（NimBLE + esp_hid Consumer Control）+ 菜单第 8 项 + `/api/hid`、`/api/hid/send`；**三个不报错的坑**（NimBLE 主机任务要自己启 / 广播只有 31 字节装不下中文名 / BLE 内存走 PSRAM）见 [[esp-music-m7-ble-hid]]；为塞进内部 SRAM 做了任务栈搬 PSRAM、关 WiFi IRAM 优化等，逐阶段账本见同一条。⚠️ 还差最后一步：对端是不是真的做出反应 |
### M1 遗留问题（记到 M8）
| **M8** 屏上搜索（字母 + 拼音输入法） | ✅ 完成（待用户按键验收） | 菜单"搜索"取代"播放/暂停"；拼音输入法（屏上字母格 + 候选字）+ 结果页；K4 统一成"短按回上一级、长按回播放器"（播放页例外）。关键事实与踩坑见 [[esp-music-m8-search]]：**Navidrome 不支持拼音搜索**、拼音表 100% 覆盖字库、**`SPIRAM_MALLOC_ALWAYSINTERNAL` 是 LVGL 控件的内存闸门**。顺带修了两个 bug（搜不到报 502 / 回页面封面消失）|

- **FLAC 直传会丢最后一帧（约 89ms）**：文件本身完整（529200 帧 = 12.000s，ffmpeg 也解出 529200），设备端只解出 525275 帧。原因是流式 FLAC parser 需要"下一帧同步字"来确定当前帧边界，最后一个不完整尾帧在 `eos` 时没被冲出来（多喂 4 次 eos 无效）。
  **影响有限**：M2 起默认走服务端转 `format=mp3`，MP3 路径一帧不差。若以后要主推 FLAC 直传，需要：给尾部补 padding 帧、或改用帧解码器（`use_frame_dec=true`，但那样 FLAC 就得自己解析帧边界）、或上报 esp_audio_simple_dec 的 issue。

## 主要风险与退路

| 风险 | 排查 | 退路 |
|---|---|---|
| **R1** ES8388 I2C 静默写失败 + 混合音量被 open 覆盖（**高**） | M0 就打重试计数 + 关键寄存器复查 + WS 计数；`/api/debug` 长期暴露 | 用已验证的寄存器序列表；I2C 降 100kHz；初始化失败可重试（菜单"重新初始化音频"） |
| **R2** seek 位置不可信 / 服务端静默忽略 `timeOffset`（**高**） | 每次 seek 打 method + Content-Length vs `song.size` | 强制 `maxBitRate` 低于源码率保证转码；raw 全走 Range；最后手段不 seek 改丢字节 |
| **R3** UI 卡顿复发（**中高**） | 三个计数器（lv_timer 最坏耗时/flush 最坏耗时/underrun）+ 任务 CPU 统计，**先量化再优化** | 已完成设计的四条措施；进一步可"手动合成 blit"绕开 LVGL 渲染器；最极端限帧 15fps |
| **R4** PSRAM/OCT 隐蔽不稳定（**中**） | 开机 MEMTEST + 每首歌 `heap_caps_check_integrity_all()` + `HEAP_POISONING` 构建 | draw buffer 用内部 DMA RAM（设计已如此）；PSRAM 降 40MHz；ring 缩到 64KB 进内部 RAM |
| **R5** FLAC/AAC 解码内存回归（**中**） | M1 就单独跑 FLAC 回归；`BUFF_NOT_ENOUGH` 必须打 `needed_size` 日志 | 默认 `transcode=mp3@192k`；某解码器不稳就 Kconfig 关掉并在嗅探阶段拒绝该格式 |
| R6 BLE+WiFi 共存咔哒声 | underrun 与连接间隔的相关性 | `ESP_COEX_PREFER_WIFI` / 增大 conn interval / 播放时暂停广播 |
| R7 字体工具链（低） | — | 三条独立路径（lv_font_conv / PIL 生成 C 源 / FreeType），任一条通即可 |

## 验证方式（端到端）

```bash
cd /home/lychee/esp-music && idf.py build
idf.py -p /dev/ttyACM0 flash monitor      # 逐阶段按上表验收
# 网页与 API
curl -s http://<ip>/api/status | python3 -m json.tool
curl -s -X POST -d '{"id":"<songid>"}' http://<ip>/api/play
curl -s -X POST -d '{"pos_ms":90000}'  http://<ip>/api/seek
curl -s http://<ip>/api/wifi/scan ; sleep 5 ; curl -s http://<ip>/api/wifi/scan/result
curl -s http://<ip>/api/debug          # 堆水位/任务栈/underrun/i2c_retries
# 手机侧：连 ESP-Music-XXXX → http://192.168.4.1 → 点歌/拖进度/看封面（飞行模式验证离线）
# BLE：bluetoothctl → scan on → pair/connect → 用 K1/K2/K3 控制 PC 播放器
```

## 待办前置检查（需要用户配合）

1. **Navidrome 当前不可达**（从这台笔记本 `192.168.0.110:4533` 100% 丢包，笔记本在 192.168.0.109 同网段）→ 请确认那台机器已开机；M2 开始需要它。
2. 可选：`esptool.py flash_id` 确认物理 flash 容量（占用串口数秒）。
3. 确认 SoftAP 默认密码（或先不设密码）。

---

# M8：屏上搜索（字母键盘 + 拼音输入法）+ 导航规则统一

## Context — 为什么做这个

用户要求在设备上直接搜歌。需求原话拆解：菜单里加搜索（**取代原来的"播放/暂停"项**）→
选搜索方式 → 输入 → 看结果 → 选一首播 → K4 回上一级；同时把全机的 K4 规则统一成
**短按回上一级、长按回播放器**。

**关键约束是"中文"**，这一点实测过、也查过：
- 屏上键盘只能打 A-Z，**打不出汉字**；
- Navidrome 服务端**不支持拼音搜索**（实测 `yue`/`ylkbd`/`zjl`/`caijianya` 全部
  返回 0 结果；官方也没有这个功能，第三方镜像做的只是简繁转换）；
- 而**模糊搜索本身是好的**（搜「不懂」能找到「越来越不懂」，实测 2 首）。

用户明确否掉了"设备本地建拼音索引"这条路 —— 理由很实在：**他还会继续往曲库加歌，
本地索引会过时**。

所以采用：**屏上拼音输入法**（把字母在设备上变成真汉字，再把汉字交给服务器搜）。
好处正是用户要的：**搜索始终是服务器做的，新加的歌立刻能搜到，不存在索引过时**。

拼音数据不用联网找，本机就有：用户的中文输入法是 Rime 雾凇拼音，
`~/.local/share/fcitx5/rime/cn_dicts/8105.dict.yaml`（通用规范汉字表）是
`汉字<TAB>拼音<TAB>权重` 的纯文本 —— **权重正好用来给候选字排序**，不用自己猜常用度。

**已实测的数据可行性**（离线算过）：
- 与本机字库（`assets_src/font/charset.txt`，6763 个汉字）取交集 → **覆盖 6653 字（98.4%）**
- 407 个音节、7153 条候选；候选最多的是 `yi`（109 个）
- `yue` 的候选顺序：**越 / 月 / 约 / 跃 / 岳 / 悦 / 乐 / 曰**（「越」正好第一，搜"越来越不懂"很顺）
- 二进制表约 **32KB**，assets 分区（4MB，已用 1.74MB）完全放得下

⚠️ **只保留字库能显示的汉字**（与 charset.txt 取交集）：字库缺字在屏上是【一片空白】
（不是方框，见 [[esp-music-lcd-text-and-state]]），候选字里混进一个看不见的字，
用户选上去就是灾难。

## 已和用户确认的三个决定

1. **做屏上拼音输入法**（而不是只做字母直搜 / 也不是本地索引）
2. **播放页的 K4 保持现状**：短按换来源、长按进菜单 —— 播放页是最外层界面，
   没有"上一级"。其余页面改成新规则（短按回上一级、长按回播放器）。
3. **搜索结果页短按 K4 回【输入页】**（保留已输入内容，方便改几个字母重搜）；
   再按 K4 → 方式选择 → 再按 K4 → 主菜单；长按 K4 任何时候直接回播放器。

## 新增页面（三个，都在 `components/ui/src/ui_pages.c`）

统一约定：`ui_page_register()` + 在 `ui_pages_build()` 里建 + `ui_pages_enter()/tick()` 各加一个
case + `ui_keys.c` 三个入口各加一个 case（探查报告里已给出这 5 步的准确位置）。
**底图全部复用现有素材，只有一个小高亮格需要新画。**
⚠️ 页面切换只 `lv_screen_load`，运行时绝不建/删 widget。

### 1. `UI_PAGE_SEARCH_MODE`（搜索方式，复用 `ASSET_BG_MENU` + `ASSET_HL_MENU`）
两行，K1/K2 选、K3 进入、K4 回主菜单：
```
搜索方式
  字母直搜（英文 / 数字歌名）
  拼音输入（中文歌名）
```

### 2. `UI_PAGE_SEARCH_IN`（输入页）—— 本次最大的一块
一页两用，靠模式标志切换行为（不建两套）：

| 区域 | 内容 |
|---|---|
| 顶栏 0..20 | `搜索: <已输入的字母/汉字>` + 光标 |
| 提示行 ~20..34 | 12px：模式名 + 当前音节（如 `拼音 yue`）/ 或 `没找到` 等状态 |
| 候选区 ~34..88 | **仅拼音模式**：2 行 × 8 = 16 格候选字，16px 中文字体，窗口跟随光标 |
| 字母格 ~88..128 | 2 行 × 14 格 = 28 格：**A-Z + `退格`**（12px 拉丁字体）|
| 高亮 | 一个可移动的小高亮格（新增 `hl_cell.png`，约 13×17，RGB565A8）|

按键（`k` = 0..3 对应 K1..K4）：

| 键 | 字母模式 | 拼音模式 |
|---|---|---|
| K1 / K2 短按 | 光标 ← / →（在 28 格里线性移动，越界不绕回） | 字母格内与字母模式相同；**在候选区则移动候选光标** |
| K3 短按 | 输入当前格子的字母（或执行退格） | 候选区：确定该候选字，追加到已输入汉字，清空音节回到字母格 |
| **K3 长按** | **开始搜索** | **开始搜索**（用已确认的汉字） |
| K4 短按 | 回上一级（方式选择页） | 同左 |
| K4 长按 | 回播放器（全局规则） | 同左 |

**拼音模式的音节判定**（决定何时切到候选区）：每输入一个字母后，用表判断：
- 该串已是一个**完整音节**、且**再追加任何字母都无法构成更长的音节** → 自动切到候选区
  （例：`yue` 不可再延长 → 直接出候选）
- 仍是更长音节的前缀 → 继续在字母格里输入（例：`yu` 还能是 `yuan`/`yun`，不急着出候选）
- 该串**不是任何音节的前缀** → 拒绝这个字母（保持原状，不把输入搞成死路）
- `退格` 格：删掉音节里最后一个字母；音节已空则删掉最后一个已确认汉字

**两种模式共用同一个输入页**：字母模式不显示候选区（那 54px 给已输入的大字/最近搜索留白），
K3 输入字母、长按 K3 直接搜（服务器模糊匹配英文/数字歌名）。

### 3. `UI_PAGE_SEARCH_RES`（结果页，复用 `ASSET_BG_LIST` + `ASSET_HL_ROW`）
**照 `list_render()` 的结构另写一份**，不改动现有列表页 ——
现有列表页的数据源硬绑在 `player_queue_*` 上（`ui_pages.c:63-115`），
把它改成"能显示任意列表"要动正在正常工作的代码，风险不值得；复制一份约 80 行更安全。
- 5 行 × 22px、窗口滚动、高亮滑动全部照搬（含 `list_window()` 那套夹取逻辑）
- 数据源：**player 的搜索结果快照**（见下）
- K1/K2 选、K3 播放选中那首、K4 回输入页
- 顶栏显示 `搜索: <关键词>` + `已显示/总数`
- 行文本**必须过 `ui_sanitize_text()`**（结果标题来自服务器，缺字会整行空白）

## player 侧：加搜索命令（UI 任务绝不能自己做网络）

搜索是阻塞网络调用（几百毫秒），按现有分层必须走命令层 ——
`player` 已经是"三路控制串行化"的地方，加一条命令最省事、也不破坏分层：

```c
/* player.h */
void player_search(const char *query);      /* 非阻塞：塞进命令队列，core0 执行 */
int  player_search_count(void);             /* 结果条数（0 = 没搜到） */
bool player_search_get(int idx, sub_song_t *out);
uint32_t player_search_gen(void);           /* 结果变化计数，UI 据此重建列表 */
bool player_search_busy(void);              /* 正在搜（UI 显示"搜索中…"） */
```
- 新增 `CMD_SEARCH`，在 `player_task` 里调 `subsonic_search()`，结果存 **PSRAM** 数组
  （64 × `sizeof(sub_song_t)` ≈ 24KB，和现有 `s_queue` 一样用 `heap_caps_*`）
- 用现成的 `s_lock` 保护；`player_search_gen++` 让 UI 知道该重画
- 播放选中那首：**`player_play_song(&song)`**（`player.h:64` 已有）——
  元数据已经在手，省一次 `getSong` 往返（⚠️ 它内部是 `play_song_meta()`：
  歌曲**不在队列里就追加到队尾再播**，所以 `player_queue_index()` 会指向那个追加槽位，
  而**不是**结果页的下标）。因此结果页的"正在播"指示**要按歌曲 id 比对**
  （`st.song_id` == 该行 id），不能按下标。
  （**这就是方案 A，不给 player 引 `player_src_t` 新枚举**，改动最小；
  代价是"播放搜索结果"会往当前队列尾部追加，之后按 K1/K3 切歌是在那个队列里走 ——
  可以接受，用户要的是"点了就能听"。）

## 拼音表：生成工具 + 运行时查表

**`tools/gen_pinyin.py`（新）**：
1. 读 `~/.local/share/fcitx5/rime/cn_dicts/8105.dict.yaml`，取**单字**条目 `汉字 拼音 权重`
   （文件里还有词语条目，跳过；⚠️ 多音字在同文件里就是多行，全部保留 —— 打 `hang` 也要能找到「行」）
2. 与 `assets_src/font/charset.txt` 取交集（只留能显示的）
3. 按音节分组，组内**按权重降序**（= 常用度）
4. 输出 `assets_src/pinyin/pinyin.bin`：
   `头(4 字节 magic+版本)` + `音节表(407 × { char name[8]; u16 off; u16 cnt; })` +
   `汉字段(u16 code point 平铺，按音节分组、组内已排好序)`
5. `tools/gen_assets.py` 增加一个 fmt（比如 4 = 原始 blob）把它打进 `assets.bin`，
   枚举名 `ASSET_PINYIN`（文件名推导，见 `gen_assets.py:38-44`）

**`components/ui/src/ui_pinyin.c`（新，只读表、无状态）**：
```c
esp_err_t pinyin_init(void);                 /* mmap assets + 校验 magic，失败非致命 */
int       pinyin_candidates(const char *syllable, uint16_t *out, int max);  /* 返回候选数 */
bool      pinyin_is_syllable(const char *s);        /* 是不是完整音节 */
bool      pinyin_is_prefix(const char *s);          /* 是不是某个音节的前缀（判断能否继续输入）*/
bool      pinyin_can_extend(const char *s);         /* 完整音节 + 还能延长（yu → yuan）*/
```
音节表按名字排序 → 二分查找。只在 UI 任务里调用。

## 顺带修的两个 bug（本次发现，都与搜索无关但都在同一片代码里）

### 1. 搜不到东西时报 502
`get_song_list()`（`components/subsonic/src/subsonic.c`）在**解析成功但 0 条结果**时
`return ESP_FAIL`，于是 `/api/search` 走 `err != ESP_OK && got == 0` 分支返回 502。
实测：搜 `zzzznotexist` → `HTTP 502 {"error":"搜索失败（Navidrome 不可达？）"}`，
而真实情况是**服务器好得很，只是没这首歌**。
**修法**：`get_song_list()` 解析成功后一律返回 `ESP_OK`（0 条也是成功），
"取不到歌"交给调用方按 `got == 0` 判断。⚠️ 要顺带核对全部调用点：
`h_search`（改后自然返回 200 + 空列表）、`load_source`（已有 `got <= 0` → 退回随机 30 首 ✓）、
`h_random` / `h_starred` / `player_starred_refresh` 等。

### 2. ⚠️ 长按 K4 进菜单再回来，**封面消失**
`ui.c:481-513`：从别的页面回来时 `s_play_refresh_all = true` → 进 `force` 分支 →
那里**无条件把封面设回占位图**（`lv_image_set_src(s_img_cover, PLACEHOLDER)`）。
而真封面只在 `s_cover_ready && s_cover_gen == s_ui_gen` 时才贴（`ui.c:516`），
歌曲没变就不会重新触发 → **封面一直是占位图，直到下一首歌**。用户报的就是这个。
**修法**：`force` 分支里优先复用已经解码好的当前封面：
```c
if (s_cover_dsc.data != NULL && s_cover_gen == st.gen) {
    lv_image_set_src(s_img_cover, &s_cover_dsc);      /* 已经有这一代的封面，直接贴回 */
} else if (assets_get(ASSET_PLACEHOLDER_COVER_72, &ph)) {
    lv_image_set_src(s_img_cover, ui_img_dsc(ASSET_PLACEHOLDER_COVER_72));
}
```
（`s_cover_dsc.header.cf` 目前在异步到达分支里每次设，改成 `ui_start()` 里设一次更稳。）

## 导航：把 K4 规则统一起来

新增一个**父页面映射**（`ui_pages.c` 里一个 `ui_page_parent()` 函数），
`key_short` 的 `default` 分支和 `key_long` 都用它，不再各页硬编码：

| 当前页 | 短按 K4（上一级） | 长按 K4 |
|---|---|---|
| PLAY | **保持现状：换下一个来源** | 进菜单（保持现状）|
| MENU | PLAY | PLAY |
| SRC | MENU | PLAY（⚠️ 删掉现有那条"长按 K4 回菜单"的前置特判，`ui_keys.c:162-166`）|
| SEARCH_MODE | MENU | PLAY |
| SEARCH_IN | SEARCH_MODE | PLAY |
| SEARCH_RES | SEARCH_IN | PLAY |
| LIST | PLAY | PLAY |
| VOL | 进入时的来源页（菜单/播放页/BT 页）—— 用一个变量记住 | PLAY |
| INFO | MENU | PLAY |
| BT（模式页）| 退出模式 → PLAY | 同左（退出模式） |

⚠️ `key_hold` 里 K1/K2/K3 在输入页要不要"连发"（快速移光标）——
现在 `HOLD_REPEAT_MS=160` 的节流是可复用的，建议输入页 **K1/K2 长按连移**（26 个字母
按着不放要移很久），K3 长按已经是"搜索"所以不能连发。

## 菜单改动

`MENU_N` 保持 6，只换第 3 项的文字与动作：
```
0 蓝牙控制 <状态>
1 来源: <当前来源>
2 搜索                 ← 取代原来的「播放 / 暂停」（播放/暂停 在播放页有 K2，不缺入口）
3 屏幕亮度
4 重连 WiFi
5 系统信息
```
主菜单那行的脏检查（`menu_render()` 里的字符串比对）不用改。

## 验证方式

1. `python3 tools/gen_pinyin.py` → 检查输出的字/音节/体积，抽查：
   `yue` 第一个候选是「越」、`yi` 第一个是「一」、`hang` 里能找到「行」
2. `python3 tools/gen_assets.py` → 看 `ASSET_PINYIN` 进了 `assets_index.h`，体积 ~32KB
3. `idf.py build` 应无 warning（⚠️ `lv_font_montserrat_16` **没启用**，别用它，
   字母格用 12px（`ui_font_lat`）、候选字用 `ui_font_16`）
4. `idf.py -p /dev/ttyACM0 flash monitor`，串口确认：
   - 启动日志里 `拼音表已加载（407 音节 / 7153 候选）`（`pinyin_init()` 打点）
   - 内存：内部 SRAM 不能比现在更紧（当前播放中 ~11KB）——拼音表走 mmap，
     只在查表时读，**不进 RAM**；但要盯 `PSRAM/内部 SRAM` 两项别突然掉下去
5. **纯逻辑回归（不用按键，用串口/接口验）**：
   - `POST /api/search` 现在搜不到应返回 **200 + 空列表**（不再 502）
   - 中文搜索仍正常（`q=不懂` → 2 首）
6. **真机按键验收（需要用户）**：
   - 长按 K4 → 菜单 → K3 进「搜索」→ 选「拼音输入」→ 用 K1/K2/K3 打 `yue`
     → 候选区应出现「越 月 约 跃…」→ 选「越」→ 打 `lai` 选「来」→ 打 `yue` 选「越」
     → 打 `bu` 选「不」→ 打 `dong` 选「懂」→ 长按 K3 → 结果页应出现「越来越不懂」
   - 结果页 K3 播放选中那首；K4 回输入页（内容还在）；长按 K4 回播放器
   - 字母模式打 `live` 长按 K3 → 能搜到英文歌
   - **回归**：长按 K4 进菜单再回来，**封面还在**（本次修的 bug）
   - **回归**：搜索全程播放不中断、欠载保持 0

## 明确不在本轮范围

- **不做本地拼音索引**（用户否掉：会过时）
- **不做词语级候选**（如打全拼一次出「越来越不懂」）—— Rime 的 `base.dict.yaml` 有词表
  （16MB），但要在设备上做分词+词频排序，复杂度不成比例；先把单字做完看手感
- **英文直搜不支持"中间词"以外的花样**（服务器 search3 就是子串匹配）
- 网页控制台的搜索不改（那边有中文输入框，本来就正常）
