spring-soft/lychee-music-hardware/pcb/工具/数据/元件尺寸表.md

# 元件真实尺寸表（一次性量好，以后不再量）

> 数据来源：嘉立创EDA 专业版 实时导出（`pcb_PrimitiveComponent.getAllPinsByPrimitiveId`）
> 导出脚本：`工具/dump-fresh.js` → `工具/数据/fresh.json`
> 单位：**mil**（1 mil = 0.0254 mm）。换算 mm 乘以 0.0254。
> 最后实测：2026-09-27

## 板框

| 板 | UUID | 板框 | 尺寸 |
|---|---|---|---|
| V1（已打样） | `197f3e3cc67e949b` | x 0~2283, y 0~**1969** | **58.0 × 50.0 mm** |
| V2（TF卡版） | `ec13f49100d66f9f` | x 0~2283, y 0~**2166** | **58.0 × 55.0 mm** |

## 大件本体尺寸（关键！焊盘包围盒 ≠ 本体）

**通用规律：嘉立创封装的「元件原点 = 本体中心」。** 小元件焊盘包围盒已足够
近似本体；**模组这类大件本体远大于焊盘**，必须单独算。

### U1 · ESP32-S3-WROOM-1-N16R8

| 项 | 值 |
|---|---|
| 封装 | `WIRELM-SMD_ESP32-S3-WROOM-1` |
| **本体** | **25.5 × 18.0 mm = 1004 × 709 mil** |
| 焊盘包围盒 | 689 × 700 mil（49 脚） |
| **本体 = 焊盘盒外扩** | **X ±10 mil，Y ±152 mil** |
| 引脚排布 | 左右两列各 14 脚（x 间距 689mil，y 间距 50mil）；底边一排 12 脚；中央 3×3 散热盘 |
| 天线端 | 本体 Y 正向端，需悬出板边 / 铺铜避空 |
| rot | 180，层 L2（背面） |

> ⚠️ **踩过的坑**：只看焊盘包围盒会漏判 —— 本体在 Y 方向比焊盘各多出 152 mil，
> 把电阻塞进「焊盘之外、本体之内」的区域就会撞上模组。

### 其余连接器/大件（焊盘包围盒）

| 位号 | 型号 | 封装 | 焊盘盒(mil) | 说明 |
|---|---|---|---|---|
| CARD1 | TF-01A 推推式 TF 座 | `TF-SMD_TF-01A` | 611 × 416 | 卡口须贴板边 |
| J1 | TYPE-C-31-M-12 | `USB-C_SMD-TYPE-C-31-M-12_1` | 195 × 341 | 口面**故意悬出**板边 |
| J2 | PJ-320A 3.5mm 耳机座 | — | 189 × 315 | rot 270 |
| J3 | 0.5mm FPC 14P 下接 | — | 106 × 390 | rot 90，屏幕排线 |
| J4 | SP088 电池座 | — | 101 × 237 | rot 90 |
| EC1 | HYCW03-2.8D-5P-S 编码器 | — | 311 × 152 | 直插，L1 |
| U2 | ES8388 | — | 152 × 152 | QFN |
| U4 | IP5306 | — | 150 × 229 | ESOP-8 |
| U3 | TLV75733 | — | 75 × 87 | SOT-23-5 |
| L1 | WPN4020H2R2MT 2.2µH | `IND-SMD_L4.0-W4.0` | 126 × 138 | 4×4mm |
| C15/C16 | 220µF 固态 | `CAP-SMD_L3.5-W2.8-FD` | 76 × 142 | **有极性** |

### 标准小件

| 类型 | 焊盘尺寸 | 焊盘间距 |
|---|---|---|
| 0603 电容 | 31.5 × 35.4 | 55 mil |
| 0603 电阻 | 31.8 × 34.0 | 55 mil |
| 6×6×5 直插按键 SW1-4/SW7 | ⌀78.7 圆盘 | 200 mil |
| 3×4 贴片按键 SW5/SW6 | 60.2 × 53.5 | 160 mil |

## 关键坐标（V1 成品布局，已打样验证）

V1 板框 58×50mm，70 元件，全部塞得下且已布线打样。**这是可信的布局基准。**
完整清单见 `工具/数据/v1-layout.json`。

| 位号 | V1 中心 | 位号 | V1 中心 |
|---|---|---|---|
| U1 | 390, 1560 | U2 | 1450, 1520 |
| J1 | 145, 400 | J2 | 2125, 1689 |
| J3 | 220, 850 | J4 | 2165, 1050 |
| EC1 | 2070, 195 | SW1~4 | 500/900/1300/1700, 250 |
| U4 | 1700, 850 | U3 | 900, 1000 |
| L1 | 1440, 850 | SW5/SW6 | 550, 600 / 550, 900 |

## V2 定稿布局（2026-09-27，58.0×50.0mm，DRC 清零）

同样 50mm 高，但比 V1 有三处改进：**模组右移 150mil 打开左侧逃逸通道
（36→186mil）、按键下移贴屏幕下沿、电阻电容铺进下方与顶部空条**。

| 位号 | V2 中心 | 备注 |
|---|---|---|
| U1 | **540, 1560** | 右移 150；本体 x186~895 y1192~2196，天线端悬出板边 227mil |
| CARD1 | 1930, 332 | TF 座下贴板边，卡口朝下边缘 |
| J1 | 145, 380 | Type-C，口面故意出界 |
| J2 / J3 / J4 | 2125,1689 / 220,850 / 2165,1050 | 耳机 / 屏幕 FPC / 电池座 |
| EC1 | 1800, 297 | 与按键同排 |
| SW1~4 | 440 / 740 / 1040 / 1340, 297 | 原 400 起会撞 J1 外壳焊盘，故右移 40 |
| R7/R8/R9 | 600/700/800, 150 | 下方空条 |
| R12/R13/R14 | 950/1100/1250, 150 | 下方空条 |
| C5/C10/C11/C17/C18 | 1000/1160/1320/1500/1660, 1830 | 顶部空条 |

### 两条 DRC 坑（都踩过）

1. **J1 (TYPE-C) 的外壳焊盘是 POLYGON，右边缘伸到 x=268**，比信号焊盘（x≤248）
   还靠里 20mil。按键排到 x=400 时 SW1_1 左边缘 260.65 就压上了 → 按键整体右移 40。
2. **CARD1 封装内含「Slot Region」**（卡口机械区），DRC 规则 `SMD Pad to Slot
   Region` 会拿它跟**背面**的贴片焊盘比。EC1_C 在 y195~247 正好压住 → 整个卡座
   下移 80mil 让开。注意这个图元不在任何 `pcb_Primitive*` 集合里，只能靠 DRC 发现。

## 检查工具

| 脚本 | 用途 |
|---|---|
| `node 工具/dump-fresh.js`（经 eda.mjs） | 重新导出实时几何 → `数据/fresh.json` |
| `node 工具/check-fresh.mjs` | 基于 fresh.json 的焊盘/本体碰撞检查 |
| `node 工具/layout.mjs` | 布局求解：任意坐标下算碰撞 + 找空位 |
