spring-soft/lychee-music-hardware/docs/开发记录/esp-music-screen-readback.md

---
name: esp-music-screen-readback
description: 看不见屏幕时怎么核对 LCD 内容——回读像素成字符画的工具，以及我踩过的 4 个对比方法坑
metadata:
  node_type: memory
  type: project
  originSessionId: 30267fef-3ae8-4bbf-a231-b5467df9ba71
  modified: 2026-09-25T06:26:09.753Z
---

**2026-09-25 建的"屏幕回读"能力**：把 LVGL 真正要发给面板的像素打成字符画输出到串口，
解决"AI 看不见屏幕、只能盲猜屏上显示"的问题。**这是排查一切"屏上显示不对"的唯一真相来源。**

**Where:** `components/ui/src/ui_display.c`
- `ui_display_dump_arm(n)` —— 接下来 n 块 flush 会被打印（`UI_DUMP_ON_SONG` 编译开关控制自动触发，默认 0）
- `ui_display_dump_crop(x1,y1,x2,y2)` —— 只打这个矩形，且 **1 像素 = 1 字符**（查单个字形必须用这个）
- 输出 TAG 是 `ui.dump`

**Why（为什么要单独记）**：这次为了查"中文变成看不懂的字"，我**连续下了两次错误结论**，
都是对比方法不可靠造成的，比 bug 本身更费时间。下面四条是血泪：

**1. ⚠️ 2 像素压 1 字符的字符画【不能用来判断"是不是这个字"**
汉字笔画 1~2px，2:1 降采样后糊成一团。我第一次就是用它"看出"字库画错了字——
其实是错觉。**查字形必须 `ui_display_dump_crop` 做 1:1。**

**2. ⚠️ 亮度归一化要按【实际最大值】**
RGB565 里 r/b 是 5 位、**g 是 6 位**，所以白的 `(r*3+g*6+b)/10 = 50` 而不是 31。
按 31 算会得到**负索引**，`ramp[-5]` 越界读出随机字符（第一版所有白底都变成随机的 `=`）。

**3. ⚠️ 裁剪模式下要区分【屏幕坐标】和【缓冲区内偏移】**
flush 回调给的是屏幕坐标的 `area`，但 `px_map` 是这一块自己的缓冲。
我第一版直接拿屏幕坐标索引缓冲 → 读到了完全不相干的屏幕区域，
还以为"作者行"里出现了进度条。**行/列都要减 `area->x1/y1`。**

**4. ⚠️ 结论要用二值化 + 对齐 + IoU 判，不要肉眼比对字符画**
正确做法：设备点阵二值化（非空白=有墨）→ 去掉四周空白 → 源字体用 PIL 渲染同一个字
（注意别把背景色和墨色弄反）→ 同样二值化去空白 → 缩放到同一尺寸算 IoU。
实测「爱」 IoU **63%**（两者都归一化成 14×14，逐行结构对应，差异来自 2bpp 量化的笔画模糊）
——**63% 就已经是"对的字"了**，别拿"看起来不像"当结论。

**结论（2026-09-25 实测，用户已确认"字体正常了"）**：
- 16px 的「爱」和 12px 的「王」在**2bpp 和 4bpp 下都渲染正确**（"王"能清楚看到三条横 + 中间一竖），
  所以"字形选错了"不成立；**"2 像素压 1 字符"那种字符画的判断不可信**。
- ⚠️ **但用户报的"中文变成看不懂的字"确实存在，最后是靠【字号提到 4bpp】解决的。**
  最可能的原因：2bpp 只有 4 级灰度，汉字细笔画（1px）落在像素边界上被量化掉或糊掉，
  **笔画丢失/粘连之后就成了"别的字"** —— 看起来像认错字，其实是不足以表达笔画。
- ⚠️ 我**无法区分**是哪一步修好的：同一次改动里既把字库从 CJK 全集（28080）退回 GB2312+假名（7311），
  又把两个字号从 2bpp 提到 4bpp。**从证据看 4bpp 更可能是关键**（因为 2bpp/4bpp 的字形都是对的，
  区别只在笔画的灰度表达能力）。要确认可以单独把 4bpp 的 CJK 全集再试一次——但**先用下面的回读方法验收**。
- **教训：中文点阵字库 2bpp 不够，至少 4bpp。** 尤其是 12px 及以下。

**顺带记 lv_font_conv 的 bin 格式**（我手工解析时连错两次，这里是核对过的）：
- 文件结构：`[u32 长度][4字节标签名]` + 段。`head` 段的**长度字段同时是 cmap 段的起始偏移**（=8+40=48）。
- 头 40 字节：12 个字段后才到 10 个 uint8（`version,tables_count,font_size,ascent,descent,typo_ascent,typo_descent,typo_line_gap,min_y,max_y,default_adv,kerning_scale`）
  —— ⚠️ **少写 `kerning_scale` 会整体错位 2 字节**，把 `loc_fmt` 读成 16、`bpp` 读成 1（我第一次就是这样，白折腾一轮）。
- `index_to_loc_format`：**1 = 32 位偏移**（我们 1.7MB 的字库是 1，正常）；0 = 16 位（上限 64KB）。
- glyph 头是**位打包**的：`adv(adv_bits) → ofs_x(xy_bits,有符号) → ofs_y → box_w(wh_bits) → box_h`，
  位流 **LSB 优先**；26 位 → 向上取整到 4 字节对齐。
- cmap 子表 16 字节；`format_type=2`（SPARSE_FULL）时 **`gid = glyph_id_start + list[k]`**
  —— list 里存的是**偏移量不是绝对 gid**（我一开始当成绝对的，又白跑一轮）。

相关：[[esp-music-fonts]] [[esp-music-lcd-text-and-state]]
