spring-soft/lychee-music-hardware/pcb/旧文件备份/netlist_protel.txt

PROTEL NETLIST 2.0
[
DESIGNATOR
U1
FOOTPRINT
WIRELM-SMD_ESP32-S3-WROOM-1
PARTTYPE
ESP32-S3-WROOM-1-N16R8
DESCRIPTION

Component Kind
Standard
Add into BOM
yes
Convert to PCB
yes
Device
ESP32-S3-WROOM-1-N16R8
PCB Layer

Symbol
ESP32-S3-WROOM-1(N16R8)
Designator
U1
Unique ID
gge1
Name

Reuse Block

Group ID

Channel ID

Manufacturer
ESPRESSIF(乐鑫)
Manufacturer Part
ESP32-S3-WROOM-1-N16R8
Supplier
LCSC
Supplier Part
C2913202
LCSC Part Name

Supplier Footprint

JLCPCB Part Class

Datasheet

Utilized IC / Part

Interface Type

Value

Antenna Type

Output Power

Voltage - Supply

Receive  Current

Send  Current

Sensitivity

Operating Temperature

Description

3D Model Title
WIRELM-SMD_ESP32-S3-WROOM-1

*
]
[
DESIGNATOR
U2
FOOTPRINT
QFN-28_L4.0-W4.0-P0.45-BL-EP
PARTTYPE
ES8388
DESCRIPTION

Component Kind
Standard
Add into BOM
yes
Convert to PCB
yes
Device
ES8388
PCB Layer

Symbol
ES8388
Designator
U2
Unique ID
gge2
Name
ES8388
Reuse Block

Group ID

Channel ID

Manufacturer
Everest-semi(顺芯)
Manufacturer Part
ES8388
Supplier
LCSC
Supplier Part
C365736
LCSC Part Name

Supplier Footprint

JLCPCB Part Class

Datasheet

Resolution (Bits)

Number of Channels

Voltage - Supply

Interface Type

The Chip Type

Operating Temperature

Sampling Rate

Quiescent Current (Iq)

Integral non - linearity

Features

Architecture

Differential Non - linearity

Description

3D Model Title
QFN-28_L4.0-W4.0-H0.8-P0.45

*
]
[
DESIGNATOR
U3
FOOTPRINT
SOT-23-5_L2.9-W1.6-P0.95-LS2.8-BL
PARTTYPE
TLV75733PDBVR
DESCRIPTION

Component Kind
Standard
Add into BOM
yes
Convert to PCB
yes
Device
TLV75733PDBVR
PCB Layer

Symbol
TLV75733PDBVR
Designator
U3
Unique ID
gge3
Name
TLV75733PDBVR
Reuse Block

Group ID

Channel ID

Manufacturer
TI(德州仪器)
Manufacturer Part
TLV75733PDBVR
Supplier
LCSC
Supplier Part
C485517
LCSC Part Name

Supplier Footprint

JLCPCB Part Class

Datasheet

Output Configuration

Voltage - Supply

Output Voltage

Output Current

Power Supply Rejection Ratio (PSRR)

Voltage Dropout

standby current

Noise

Features

Operating Temperature

Output Type

Number of Outputs

Description

3D Model Title
SOT-23-5_L2.9-W1.6-P0.95-LS2.8-BL

*
]
[
DESIGNATOR
Q1
FOOTPRINT
SOT-23-3_L2.9-W1.3-P1.90-LS2.4-BR
PARTTYPE
2N7002
DESCRIPTION

Component Kind
Standard
Add into BOM
yes
Convert to PCB
yes
Device
2N7002
PCB Layer

Symbol
2N7002_C727149
Designator
Q1
Unique ID
gge4
Name
2N7002
Reuse Block

Group ID

Channel ID

Manufacturer
TWGMC(迪嘉)
Manufacturer Part
2N7002
Supplier
LCSC
Supplier Part
C727149
LCSC Part Name

Supplier Footprint

JLCPCB Part Class

Datasheet

Number

Drain to Source Voltage

Current - Continuous Drain(Id)

RDS(on)

Pd - Power Dissipation

Gate Threshold Voltage (Vgs(th))

Gate Charge(Qg)

Input Capacitance(Ciss)

Reverse Transfer Capacitance (Crss@Vds)

Operating Temperature

Configuration

Type

Output Capacitance(Coss)

Vgs

Description

3D Model Title
SOT-23-3P_L2.9-W1.3-H1.0-LS2.4-P0.95

*
]
[
DESIGNATOR
J1
FOOTPRINT
USB-C_SMD-TYPE-C-31-M-12_1
PARTTYPE
TYPE-C-31-M-12
DESCRIPTION

Component Kind
Standard
Add into BOM
yes
Convert to PCB
yes
Device
TYPE-C-31-M-12
PCB Layer

Symbol
TYPE-C-31-M-12
Designator
J1
Unique ID
gge5
Name
TYPE-C-31-M-12
Reuse Block

Group ID

Channel ID

Manufacturer
韩国韩荣
Manufacturer Part
TYPE-C-31-M-12
Supplier
LCSC
Supplier Part
C165948
LCSC Part Name

Supplier Footprint

JLCPCB Part Class

Datasheet

Connector Type

Protocol Standard

Gender

Mounting Type

Number of Contacts

Number of Ports

Current Rating-Power

Voltage Rating

Connect-Disconnect Life

Length

Operating Temperature

Description

3D Model Title
USB-C_SMD-TYPE-C-31-M-12_1

*
]
[
DESIGNATOR
J2
FOOTPRINT
AUDIO-TH_XKB_PJ-320A
PARTTYPE
PJ-320A
DESCRIPTION

Component Kind
Standard
Add into BOM
yes
Convert to PCB
yes
Device
PJ-320A
PCB Layer

Symbol
PJ-320A
Designator
J2
Unique ID
gge6
Name
PJ-320A
Reuse Block

Group ID

Channel ID

Manufacturer
XKB Connection(中国星坤)
Manufacturer Part
PJ-320A
Supplier
LCSC
Supplier Part
C2884926
LCSC Part Name

Supplier Footprint

JLCPCB Part Class

Datasheet

Connector Type

Current Rating

Voltage Rating (Max)

Contact Material

Contact Plating

Operating Temperature

Rank Number

Mounting Style

Color

Body Height

Length

Width

Description

3D Model Title
AUDIO-TH_XKB_PJ-320A

*
]
[
DESIGNATOR
J3
FOOTPRINT
FPC-SMD_14P-P0.50_AFC01-S14FCC-00
PARTTYPE
0.5mmFPC连接器:14PIN下接接翻盖式
DESCRIPTION

Component Kind
Standard
Add into BOM
yes
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
Supplier Footprint

JLCPCB Part Class

Datasheet

Supplier
LCSC
3D Model Title
C0603_L1.6-W0.8-H0.8
Value

Tolerance

Voltage Rating

Temperature Coefficient

Name

Description

Reuse Block

Group ID

Channel ID

*
]
[
DESIGNATOR
C24
FOOTPRINT
C0603
PARTTYPE
CC0603KRX7R9BB104
DESCRIPTION

Component Kind
Standard
Unique ID
gge63
Add into BOM
yes
Convert to PCB
yes
Device
CC0603KRX7R9BB104
PCB Layer

Name

Designator
C24
Symbol
CC0603KRX7R9BB104
LCSC Part Name

Supplier Part
C14663
Manufacturer
YAGEO(国巨)
Manufacturer Part
CC0603KRX7R9BB104
Supplier Footprint

JLCPCB Part Class

Datasheet

Supplier
LCSC
3D Model Title
C0603_L1.6-W0.8-H0.8
Value

Tolerance

Voltage Rating

Temperature Coefficient

Description

Reuse Block

Group ID

Channel ID

*
]
[
DESIGNATOR
C25
FOOTPRINT
C0603
PARTTYPE
CL10A106KP8NNNC
DESCRIPTION

Component Kind
Standard
Unique ID
gge64
Add into BOM
yes
Convert to PCB
yes
Device
CL10A106KP8NNNC
PCB Layer

Symbol
CL10A106KP8NNNC
Designator
C25
LCSC Part Name

Supplier Part
C19702
Manufacturer
SAMSUNG(三星)
Manufacturer Part
CL10A106KP8NNNC
Supplier Footprint

JLCPCB Part Class

Datasheet

Supplier
LCSC
3D Model Title
C0603_L1.6-W0.8-H0.8
Value

Tolerance

Voltage Rating

Temperature Coefficient

Name

Description

Reuse Block

Group ID

Channel ID

*
]
(
GND 
U1-1 ESP32-S3-WROOM-1-N16R8-GND Passive 
U1-40 ESP32-S3-WROOM-1-N16R8-GND Passive 
U1-41 ESP32-S3-WROOM-1-N16R8-GND Passive 
U2-4 ES8388-DGND Passive 
U2-13 ES8388-HPGND Passive 
U2-18 ES8388-AGND Passive 
U2-29 ES8388-EP Passive 
U3-2 TLV75733PDBVR-GND Passive 
Q1-2 2N7002-S Passive 
J1-A1B12 TYPE-C-31-M-12-GND Passive 
J1-B1A12 TYPE-C-31-M-12-GND Passive 
J2-5 PJ-320A-5 Passive 
J3-2 0.5mmFPC连接器:14PIN下接接翻盖式-2 Passive 
J3-5 0.5mmFPC连接器:14PIN下接接翻盖式-5 Passive 
J3-13 0.5mmFPC连接器:14PIN下接接翻盖式-13 Passive 
J3-15 0.5mmFPC连接器:14PIN下接接翻盖式-15 Passive 
J3-16 0.5mmFPC连接器:14PIN下接接翻盖式-16 Passive 
SW1-2 轻触开关,6*6*5塑头,260G,行程0.25mm,直插中2脚-2 Passive 
SW2-2 轻触开关,6*6*5塑头,260G,行程0.25mm,直插中2脚-2 Passive 
SW3-2 轻触开关,6*6*5塑头,260G,行程0.25mm,直插中2脚-2 Passive 
SW4-2 轻触开关,6*6*5塑头,260G,行程0.25mm,直插中2脚-2 Passive 
SW5-2 轻触开关,6*6*5塑头,260G,行程0.25mm,直插中2脚-2 Passive 
SW6-2 轻触开关,6*6*5塑头,260G,行程0.25mm,直插中2脚-2 Passive 
R1-2 0603WAF5101T5E-2 Input   
R2-2 0603WAF5101T5E-2 Input   
R3-2 0603WAF1004T5E-2 Input   
R14-2 0603WAF1003T5E-2 Input   
C1-2 CL10B472KB8NNNC-2 Input   
C2-2 CL10A105KB8NNNC-2 Passive 
C3-2 CL10A105KB8NNNC-2 Passive 
C4-2 CC0603KRX7R9BB104-2 Passive 
C5-2 CC0603KRX7R9BB104-2 Passive 
C6-2 CC0603KRX7R9BB104-2 Passive 
C7-2 CC0603KRX7R9BB104-2 Passive 
C8-2 CC0603KRX7R9BB104-2 Passive 
C9-2 CC0603KRX7R9BB104-2 Passive 
C10-2 CL10A106KP8NNNC-2 Passive 
C11-2 CL10A106KP8NNNC-2 Passive 
C12-2 CL10A106KP8NNNC-2 Passive 
C13-2 CL10A106KP8NNNC-2 Passive 
C14-2 CL10A106KP8NNNC-2 Passive 
C17-2 CL10A106KP8NNNC-2 Passive 
C18-2 CC0603KRX7R9BB104-2 Passive 
C19-2 CL10A106KP8NNNC-2 Passive 
C20-2 CC0603KRX7R9BB104-2 Passive 
U4-9 IP5306-EP Passive 
J4-2 SP088-2 Passive 
SW7-2 轻触开关,6*6*5塑头,260G,行程0.25mm,直插中2脚-2 Passive 
C21-2 CL10A106KP8NNNC-2 Passive 
C22-2 CC0603KRX7R9BB104-2 Passive 
C23-2 CL10A106KP8NNNC-2 Passive 
C24-2 CC0603KRX7R9BB104-2 Passive 
C25-2 CL10A106KP8NNNC-2 Passive 
)
(
VCC 
U1-2 ESP32-S3-WROOM-1-N16R8-3V3 Passive 
U2-2 ES8388-DVDD Passive 
U2-3 ES8388-PVDD Passive 
U2-26 ES8388-CE Passive 
U3-5 TLV75733PDBVR-OUT Passive 
J3-10 0.5mmFPC连接器:14PIN下接接翻盖式-10 Passive 
J3-11 0.5mmFPC连接器:14PIN下接接翻盖式-11 Passive 
R4-1 0603WAF1002T5E-1 Input   
R5-1 0603WAF1002T5E-1 Input   
R6-1 0603WAF1002T5E-1 Input   
R7-1 0603WAF1002T5E-1 Input   
R8-1 0603WAF1002T5E-1 Input   
R9-1 0603WAF1002T5E-1 Input   
R10-1 0603WAF1002T5E-1 Input   
R11-1 0603WAF1002T5E-1 Input   
C3-1 CL10A105KB8NNNC-1 Passive 
C5-1 CC0603KRX7R9BB104-1 Passive 
C6-1 CC0603KRX7R9BB104-1 Passive 
C7-1 CC0603KRX7R9BB104-1 Passive 
C11-1 CL10A106KP8NNNC-1 Passive 
C12-1 CL10A106KP8NNNC-1 Passive 
FB1-1 MMZ1608B601CTAH0-1 Passive 
FB2-1 MMZ1608B601CTAH0-1 Passive 
)
(
RESET_N 
U1-3 ESP32-S3-WROOM-1-N16R8-EN Passive 
SW5-1 轻触开关,6*6*5塑头,260G,行程0.25mm,直插中2脚-1 Passive 
R4-2 0603WAF1002T5E-2 Input   
C2-1 CL10A105KB8NNNC-1 Passive 
)
(
LCD_SCLK 
U1-4 ESP32-S3-WROOM-1-N16R8-IO4 Passive 
J3-9 0.5mmFPC连接器:14PIN下接接翻盖式-9 Passive 
)
(
LCD_MOSI 
U1-5 ESP32-S3-WROOM-1-N16R8-IO5 Passive 
J3-8 0.5mmFPC连接器:14PIN下接接翻盖式-8 Passive 
)
(
LCD_RST 
U1-6 ESP32-S3-WROOM-1-N16R8-IO6 Passive 
J3-6 0.5mmFPC连接器:14PIN下接接翻盖式-6 Passive 
)
(
LCD_DC 
U1-7 ESP32-S3-WROOM-1-N16R8-IO7 Passive 
J3-7 0.5mmFPC连接器:14PIN下接接翻盖式-7 Passive 
)
(
LCD_CS 
U1-8 ESP32-S3-WROOM-1-N16R8-IO15 Passive 
J3-12 0.5mmFPC连接器:14PIN下接接翻盖式-12 Passive 
)
(
BL_DRV 
U1-9 ESP32-S3-WROOM-1-N16R8-IO16 Passive 
R13-1 0603WAF1000T5E-1 Input   
)
(
KEY_K4 
U1-10 ESP32-S3-WROOM-1-N16R8-IO17 Passive 
SW4-1 轻触开关,6*6*5塑头,260G,行程0.25mm,直插中2脚-1 Passive 
R9-2 0603WAF1002T5E-2 Input   
)
(
KEY_K3 
U1-11 ESP32-S3-WROOM-1-N16R8-IO18 Passive 
SW3-1 轻触开关,6*6*5塑头,260G,行程0.25mm,直插中2脚-1 Passive 
R8-2 0603WAF1002T5E-2 Input   
)
(
KEY_K2 
U1-12 ESP32-S3-WROOM-1-N16R8-IO8 Passive 
SW2-1 轻触开关,6*6*5塑头,260G,行程0.25mm,直插中2脚-1 Passive 
R7-2 0603WAF1002T5E-2 Input   
)
(
USB_DN 
U1-13 ESP32-S3-WROOM-1-N16R8-IO19 Passive 
J1-B7 TYPE-C-31-M-12-DN2 Passive 
J1-A7 TYPE-C-31-M-12-DN1 Passive 
)
(
USB_DP 
U1-14 ESP32-S3-WROOM-1-N16R8-IO20 Passive 
J1-A6 TYPE-C-31-M-12-DP1 Passive 
J1-B6 TYPE-C-31-M-12-DP2 Passive 
)
(
BOOT_N 
U1-27 ESP32-S3-WROOM-1-N16R8-IO0 Passive 
SW6-1 轻触开关,6*6*5塑头,260G,行程0.25mm,直插中2脚-1 Passive 
R5-2 0603WAF1002T5E-2 Input   
)
(
KEY_K1 
U1-31 ESP32-S3-WROOM-1-N16R8-IO38 Passive 
SW1-1 轻触开关,6*6*5塑头,260G,行程0.25mm,直插中2脚-1 Passive 
R6-2 0603WAF1002T5E-2 Input   
)
(
I2S_LRCK 
U1-32 ESP32-S3-WROOM-1-N16R8-IO39 Passive 
U2-7 ES8388-LRCK Passive 
)
(
I2S_DOUT 
U1-33 ESP32-S3-WROOM-1-N16R8-IO40 Passive 
U2-6 ES8388-DSDIN Passive 
)
(
I2S_BCLK 
U1-34 ESP32-S3-WROOM-1-N16R8-IO41 Passive 
U2-5 ES8388-SCLK Passive 
)
(
I2S_MCLK 
U1-35 ESP32-S3-WROOM-1-N16R8-IO42 Passive 
U2-1 ES8388-MCLK Passive 
)
(
I2C_SCL 
U1-38 ESP32-S3-WROOM-1-N16R8-IO2 Passive 
U2-28 ES8388-CCLK Passive 
R11-2 0603WAF1002T5E-2 Input   
)
(
I2C_SDA 
U1-39 ESP32-S3-WROOM-1-N16R8-IO1 Passive 
U2-27 ES8388-CDATA Passive 
R10-2 0603WAF1002T5E-2 Input   
)
(
VREF 
U2-10 ES8388-VREF Passive 
C17-1 CL10A106KP8NNNC-1 Passive 
C18-1 CC0603KRX7R9BB104-1 Passive 
)
(
ROUT1 
U2-11 ES8388-ROUT1 Passive 
C16-1 RST220UF10V018-1 Input   
)
(
LOUT1 
U2-12 ES8388-LOUT1 Passive 
C15-1 RST220UF10V018-1 Input   
)
(
HPVDD 
U2-16 ES8388-HPVDD Passive 
C9-1 CC0603KRX7R9BB104-1 Passive 
C14-1 CL10A106KP8NNNC-1 Passive 
FB2-2 MMZ1608B601CTAH0-2 Passive 
)
(
AVDD 
U2-17 ES8388-AVDD Passive 
C8-1 CC0603KRX7R9BB104-1 Passive 
C13-1 CL10A106KP8NNNC-1 Passive 
FB1-2 MMZ1608B601CTAH0-2 Passive 
)
(
VMID 
U2-20 ES8388-VMID Passive 
C19-1 CL10A106KP8NNNC-1 Passive 
C20-1 CC0603KRX7R9BB104-1 Passive 
)
(
+5V 
U3-1 TLV75733PDBVR-IN Passive 
U3-3 TLV75733PDBVR-EN Passive 
R12-1 0603WAF1000T5E-1 Input   
C4-1 CC0603KRX7R9BB104-1 Passive 
C10-1 CL10A106KP8NNNC-1 Passive 
U4-8 IP5306-VOUT Passive 
R15-1 0603WAF1001T5E-1 Input   
R16-1 0603WAF1001T5E-1 Input   
R17-1 0603WAF1001T5E-1 Input   
C23-1 CL10A106KP8NNNC-1 Passive 
C24-1 CC0603KRX7R9BB104-1 Passive 
)
(
BL_GATE 
Q1-1 2N7002-G Passive 
R13-2 0603WAF1000T5E-2 Input   
R14-1 0603WAF1003T5E-1 Input   
)
(
LED_K 
Q1-3 2N7002-D Passive 
J3-3 0.5mmFPC连接器:14PIN下接接翻盖式-3 Passive 
)
(
VBUS 
J1-A4B9 TYPE-C-31-M-12-VBUS Passive 
J1-B4A9 TYPE-C-31-M-12-VBUS Passive 
U4-1 IP5306-VIN Passive 
C21-1 CL10A106KP8NNNC-1 Passive 
C22-1 CC0603KRX7R9BB104-1 Passive 
)
(
CC1 
J1-A5 TYPE-C-31-M-12-CC1 Passive 
R1-1 0603WAF5101T5E-1 Input   
)
(
CC2 
J1-B5 TYPE-C-31-M-12-CC2 Passive 
R2-1 0603WAF5101T5E-1 Input   
)
(
SHIELD 
J1-4 TYPE-C-31-M-12-EH Passive 
J1-3 TYPE-C-31-M-12-EH Passive 
J1-2 TYPE-C-31-M-12-EH Passive 
J1-1 TYPE-C-31-M-12-EH Passive 
R3-1 0603WAF1004T5E-1 Input   
C1-1 CL10B472KB8NNNC-1 Input   
)
(
HP_L 
J2-2 PJ-320A-2 Passive 
C15-2 RST220UF10V018-2 Input   
)
(
HP_R 
J2-3 PJ-320A-3 Passive 
C16-2 RST220UF10V018-2 Input   
)
(
LED_A 
J3-4 0.5mmFPC连接器:14PIN下接接翻盖式-4 Passive 
R12-2 0603WAF1000T5E-2 Input   
)
(
LED1_K 
U4-2 IP5306-LED1 Passive 
D1-1 LED0603-RDl绿灯-C Input   
)
(
LED2_K 
U4-3 IP5306-LED2 Passive 
D2-1 LED0603-RDl绿灯-C Input   
)
(
LED3_K 
U4-4 IP5306-LED3 Passive 
D3-1 LED0603-RDl绿灯-C Input   
)
(
PWR_KEY 
U4-5 IP5306-KEY Passive 
SW7-1 轻触开关,6*6*5塑头,260G,行程0.25mm,直插中2脚-1 Passive 
)
(
BAT+ 
U4-6 IP5306-BAT Passive 
L1-1 WPN4020H2R2MT-1 Passive 
J4-1 SP088-1 Passive 
C25-1 CL10A106KP8NNNC-1 Passive 
)
(
SW_NODE 
U4-7 IP5306-SW Passive 
L1-2 WPN4020H2R2MT-2 Passive 
)
(
LED1_R 
D1-2 LED0603-RDl绿灯-A Input   
R15-2 0603WAF1001T5E-2 Input   
)
(
LED2_R 
D2-2 LED0603-RDl绿灯-A Input   
R16-2 0603WAF1001T5E-2 Input   
)
(
LED3_R 
D3-2 LED0603-RDl绿灯-A Input   
R17-2 0603WAF1001T5E-2 Input   
)
