spring-soft/lychee-music-hardware/pcb/antenna-crop.png

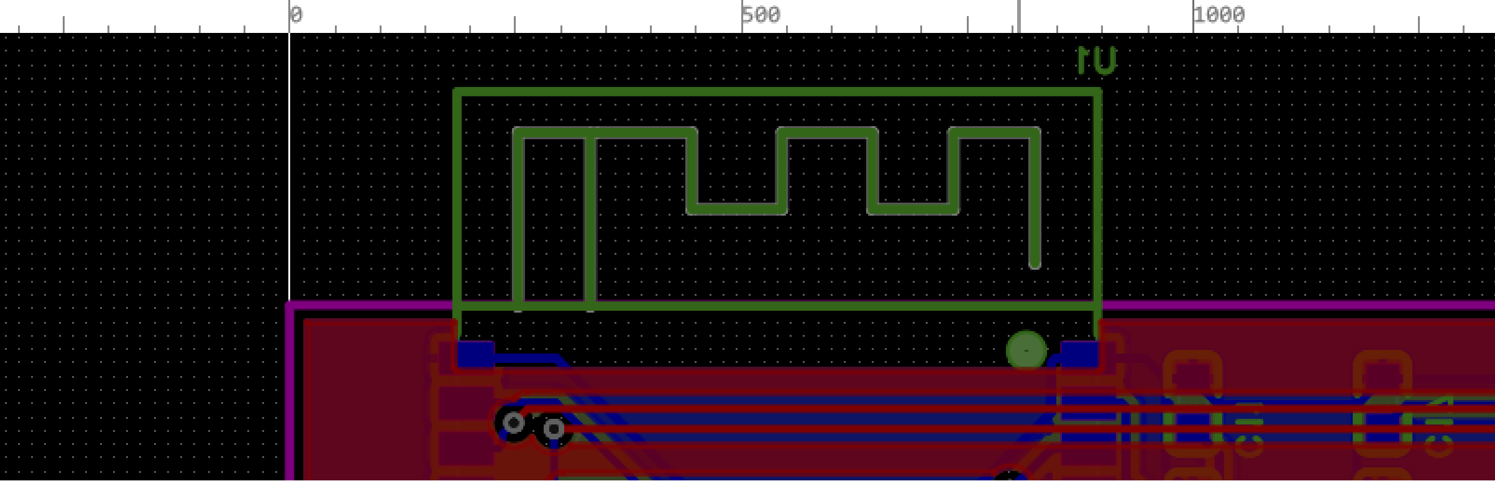
pcb/antenna-crop.png
