spring-soft/lychee-music-hardware/pcb/card_zoom.png

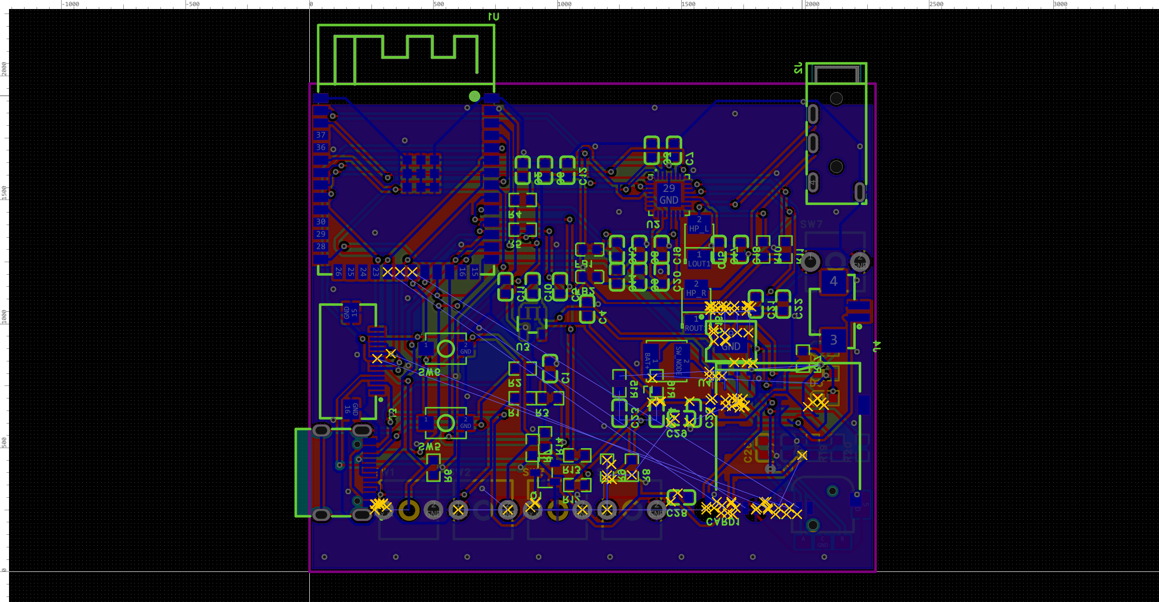
pcb/card_zoom.png
