spring-soft/lychee-music-hardware/pcb/es8388-sym.png

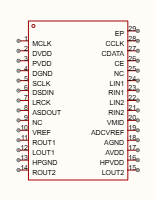
pcb/es8388-sym.png
