spring-soft/lychee-music-hardware/pcb/tf-crop.png

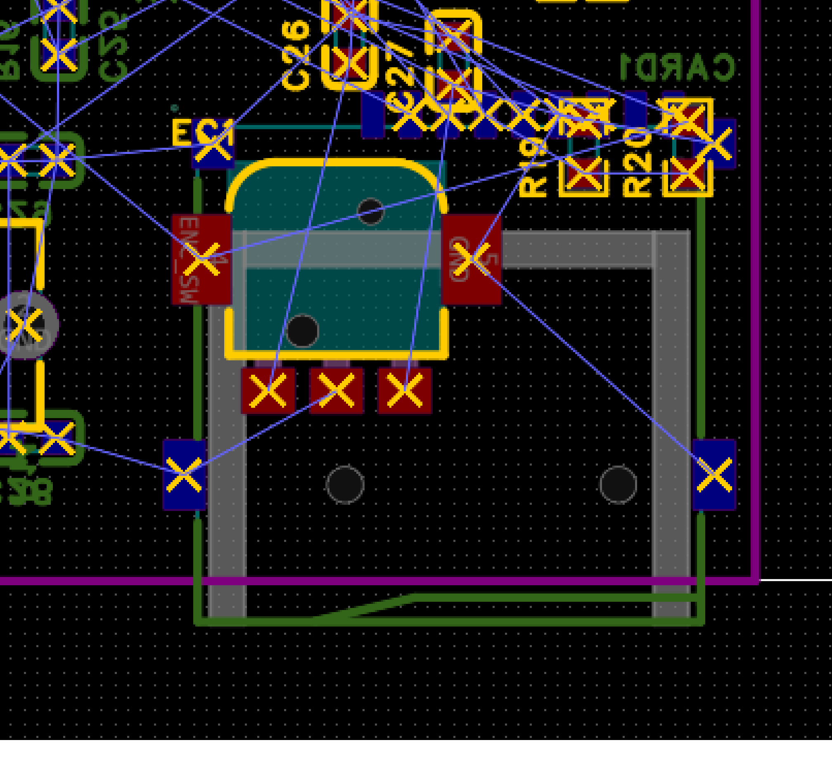
pcb/tf-crop.png
