spring-soft/lychee-music-hardware/pcb/tf-zoom.png

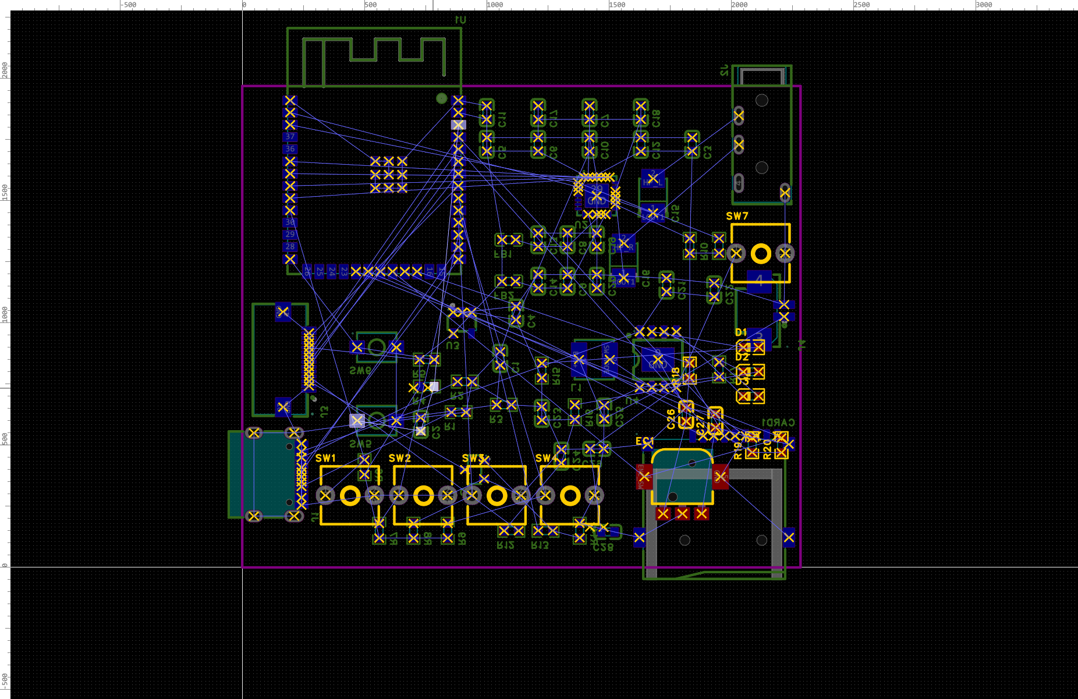
pcb/tf-zoom.png
