spring-soft/lychee-music-hardware/pcb/tfsym-C91145.png

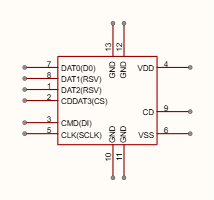
pcb/tfsym-C91145.png
