spring-soft/lychee-music-hardware/pcb/tfsym-C41426929.png

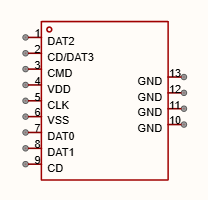
pcb/tfsym-C41426929.png
