spring-soft/lychee-music-hardware/pcb/V2_50mm.png

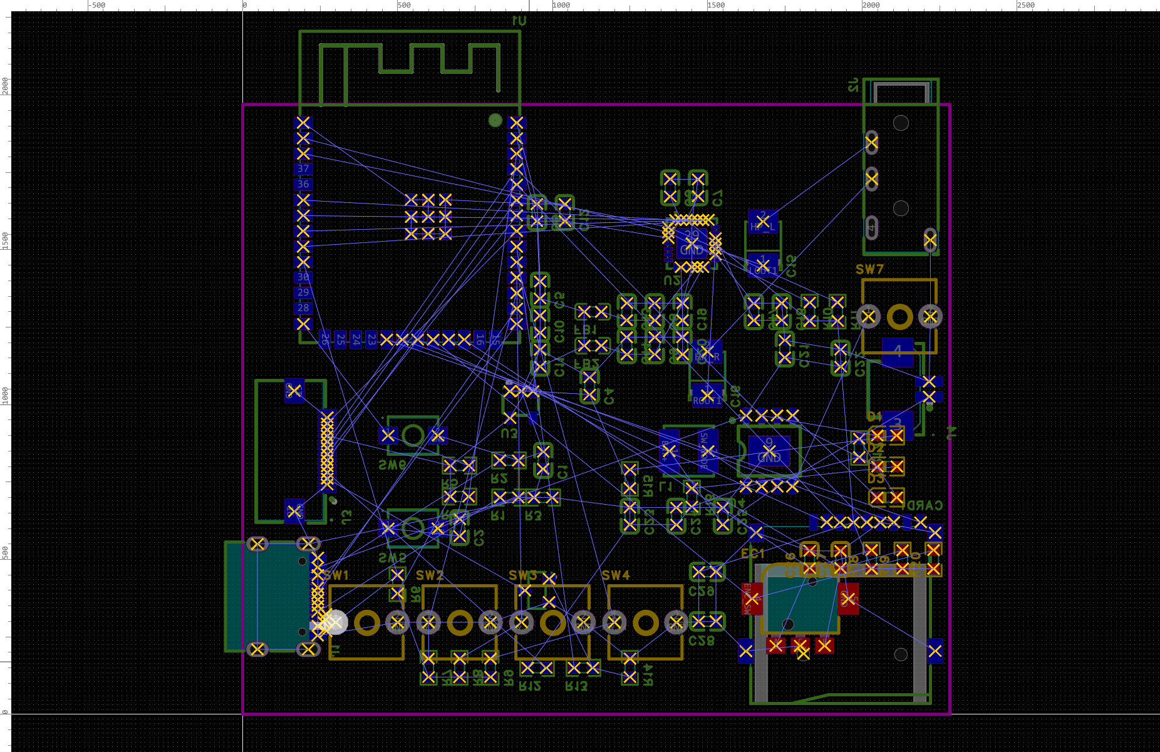
pcb/V2_50mm.png
