spring-soft/lychee-music-hardware/pcb/V2_board2.png

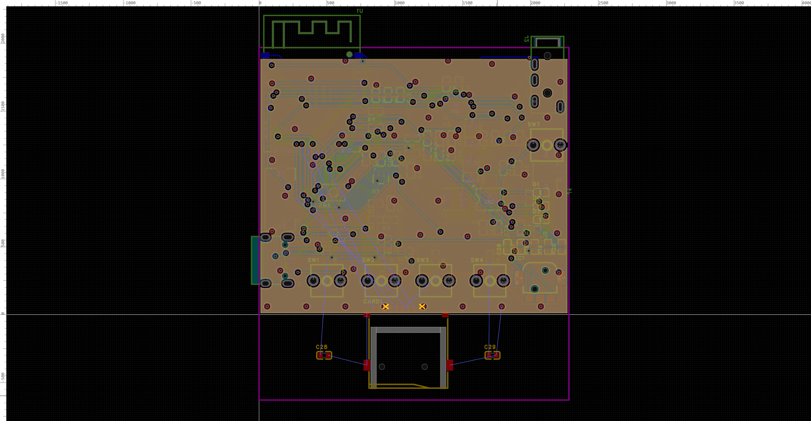
pcb/V2_board2.png
