spring-soft/lychee-music-hardware/pcb/V2_board.png

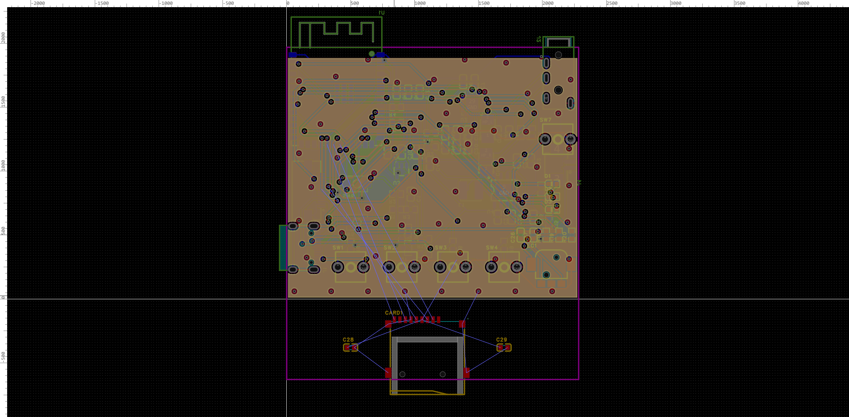
pcb/V2_board.png
