spring-soft/lychee-music-hardware/pcb/V2_done.png

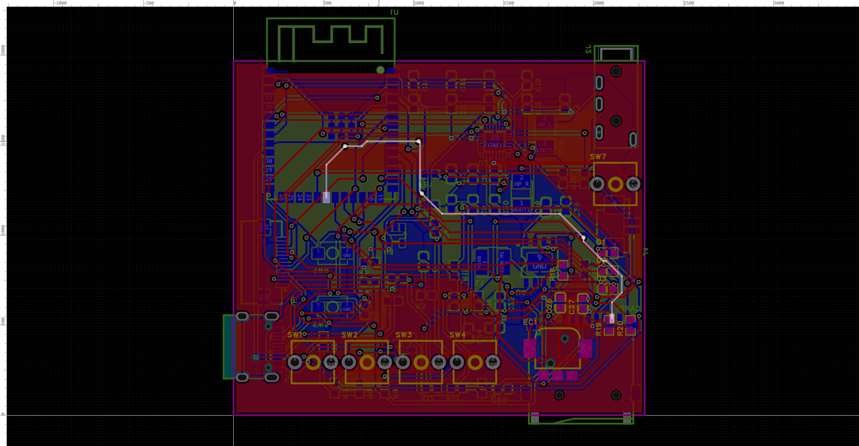
pcb/V2_done.png
