spring-soft/lychee-music-hardware/pcb/V2_final2.png

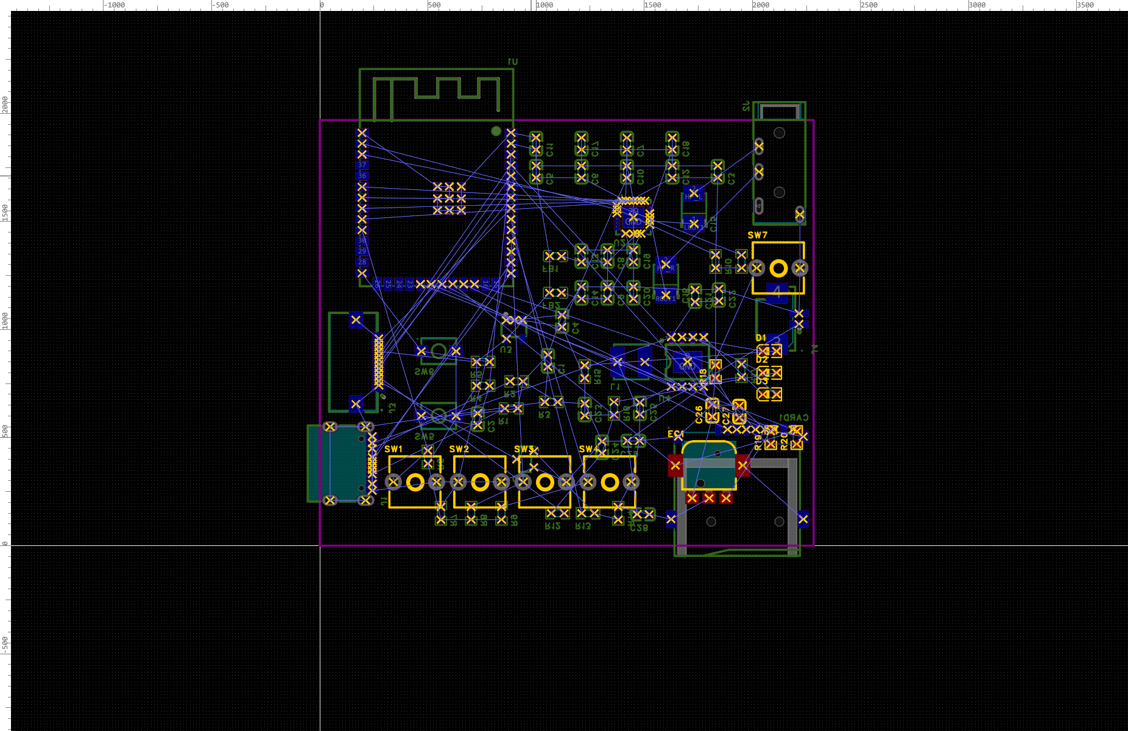
pcb/V2_final2.png
