spring-soft/lychee-music-hardware/pcb/V2_final.png

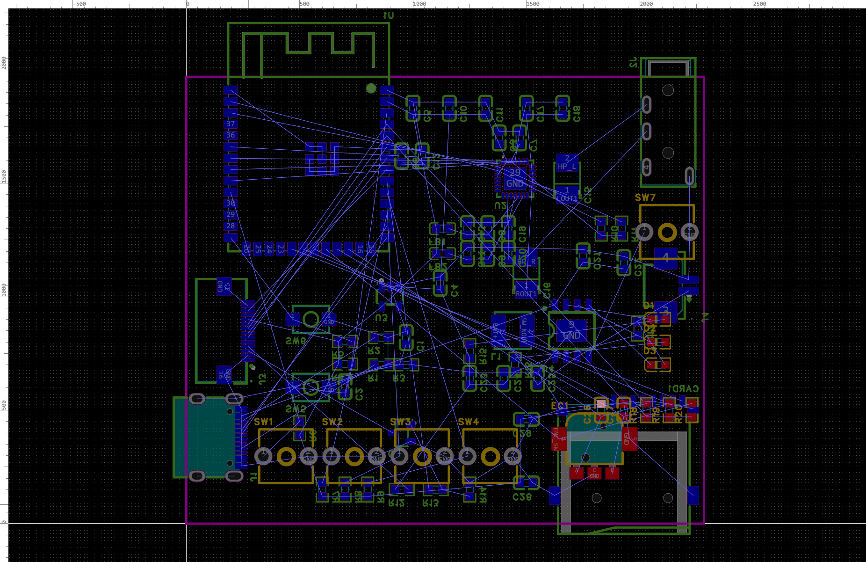
pcb/V2_final.png
