spring-soft/lychee-music-hardware/pcb/V2_now.png

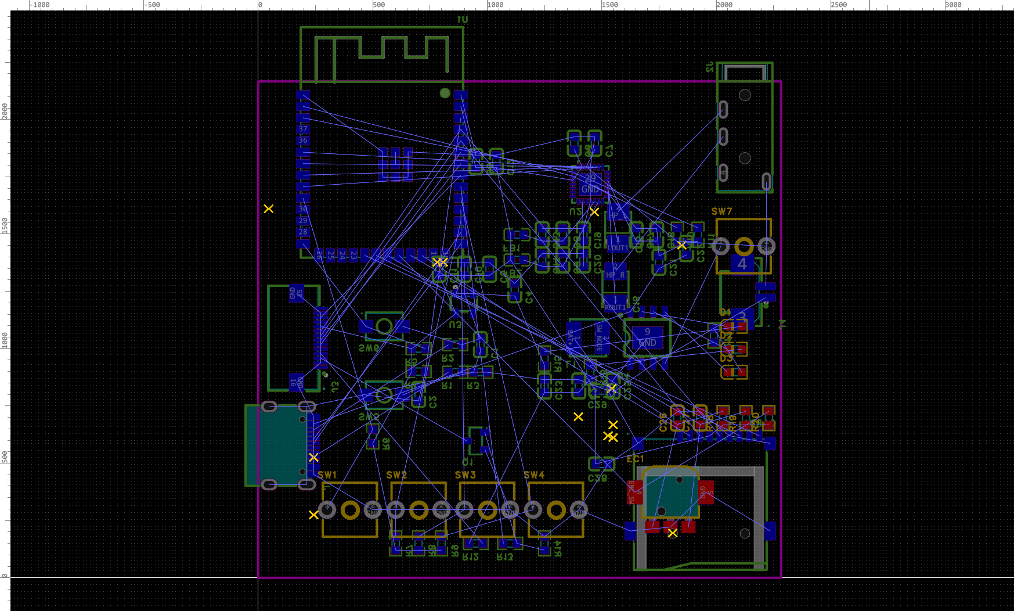
pcb/V2_now.png
