spring-soft/lychee-music-hardware/pcb/V2_r3.png

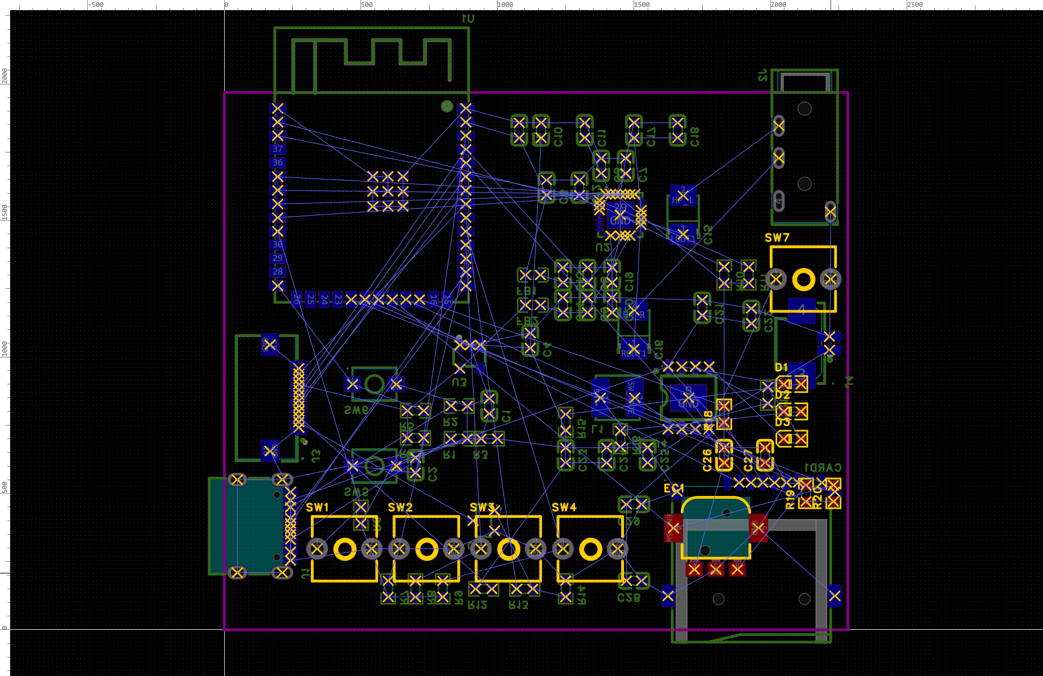
pcb/V2_r3.png
