spring-soft/lychee-music-hardware/pcb/V2_r7.png

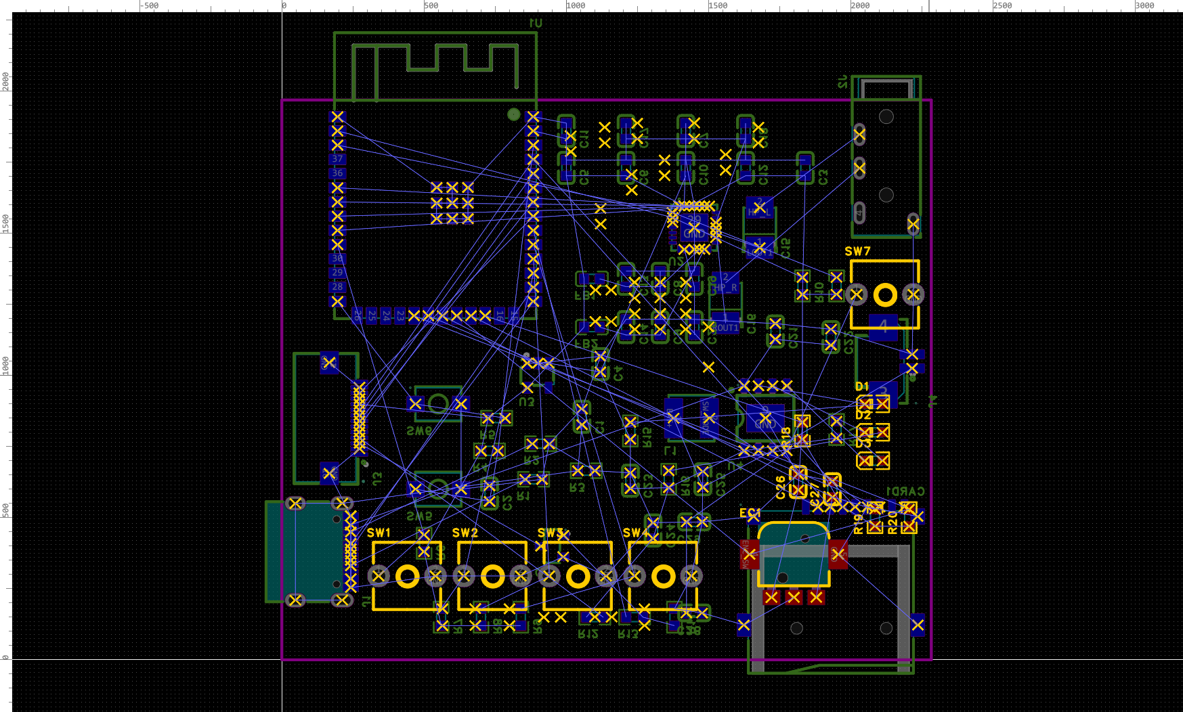
pcb/V2_r7.png
