spring-soft/lychee-music-hardware/pcb/V2_routed.png

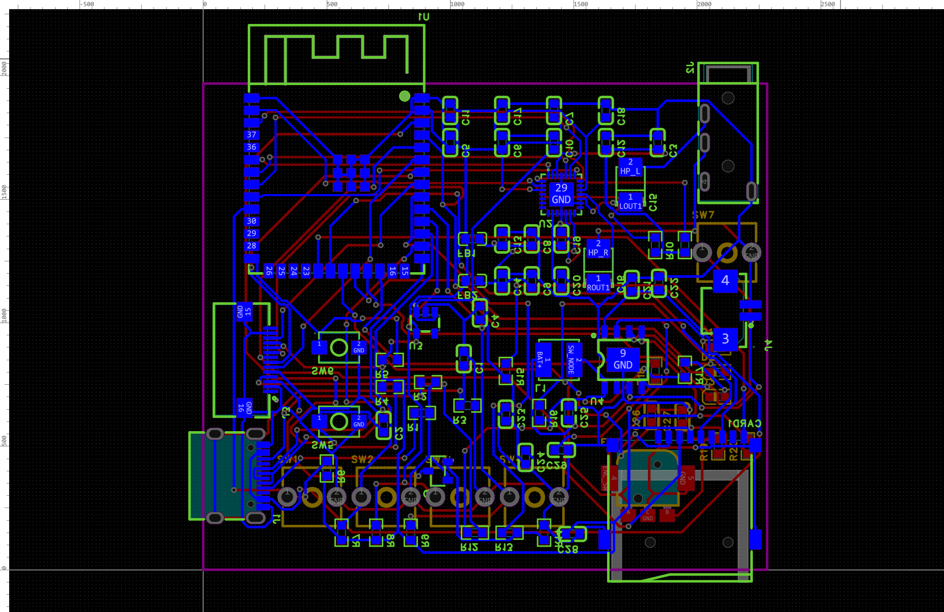
pcb/V2_routed.png
