spring-soft/lychee-music-hardware/pcb/V2_tf.png

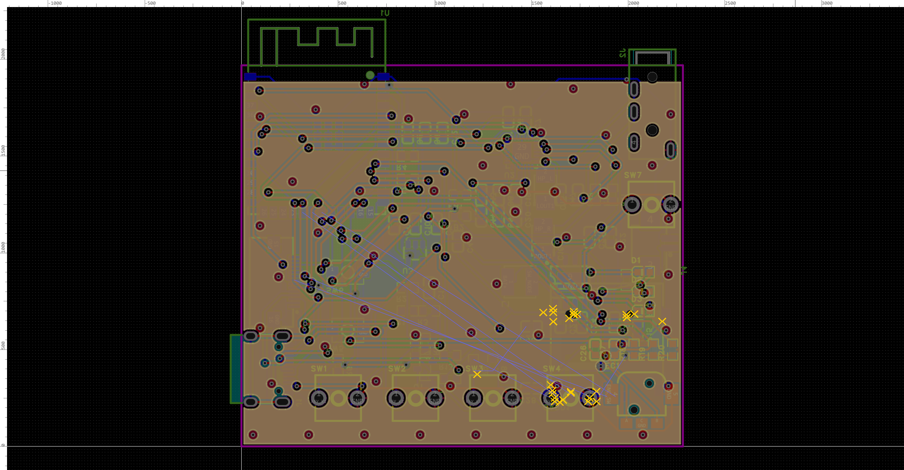
pcb/V2_tf.png
