spring-soft/lychee-music-hardware/pcb/V2_v7.png

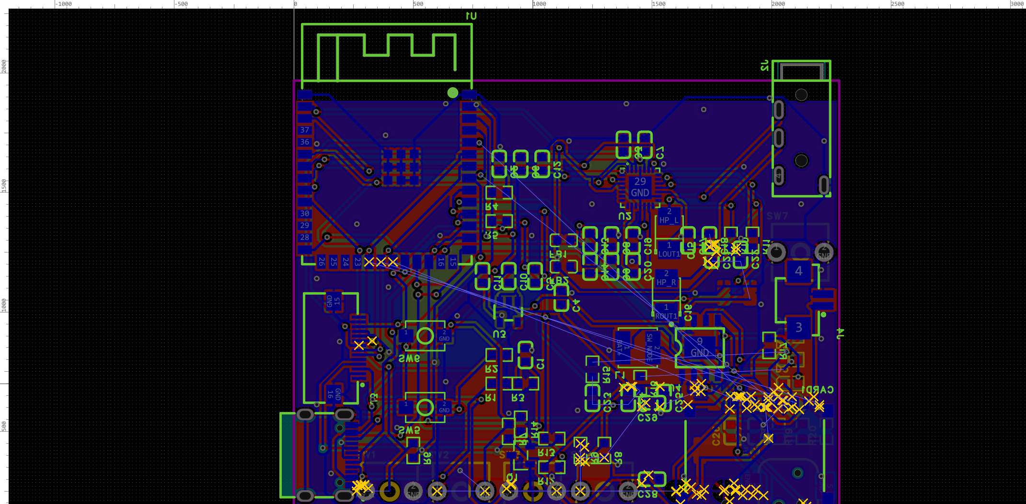
pcb/V2_v7.png
