spring-soft/lychee-music-hardware/pcb/V2_v9.png

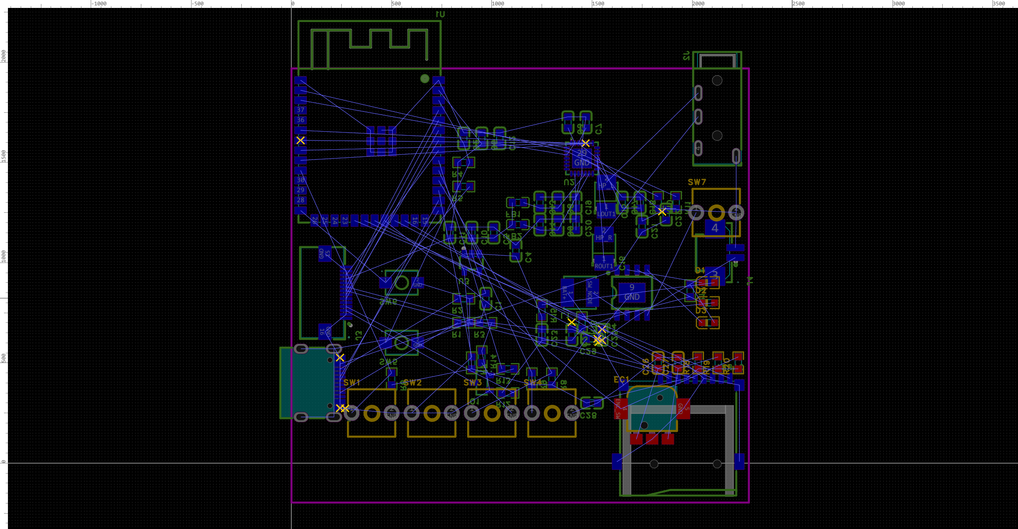
pcb/V2_v9.png
