spring-soft/lychee-music-hardware/pcb/V2_v10.png

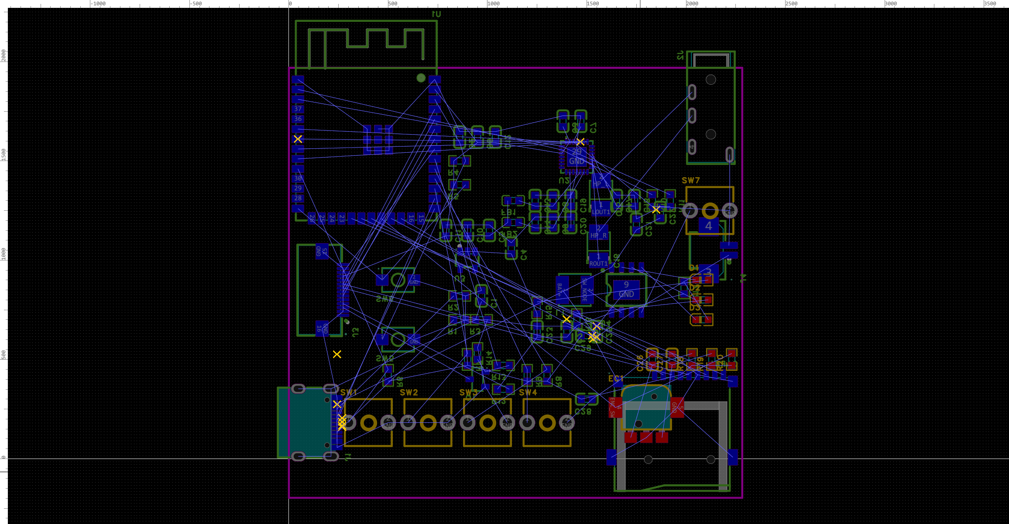
pcb/V2_v10.png
