spring-soft/lychee-music-hardware/pcb/V2_v11.png

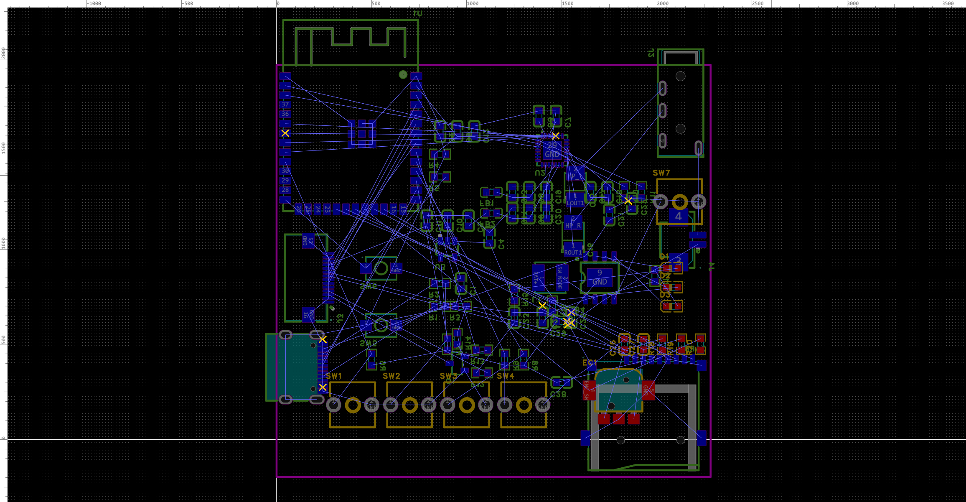
pcb/V2_v11.png
