spring-soft/lychee-music-hardware/pcb/板子渲染图.png

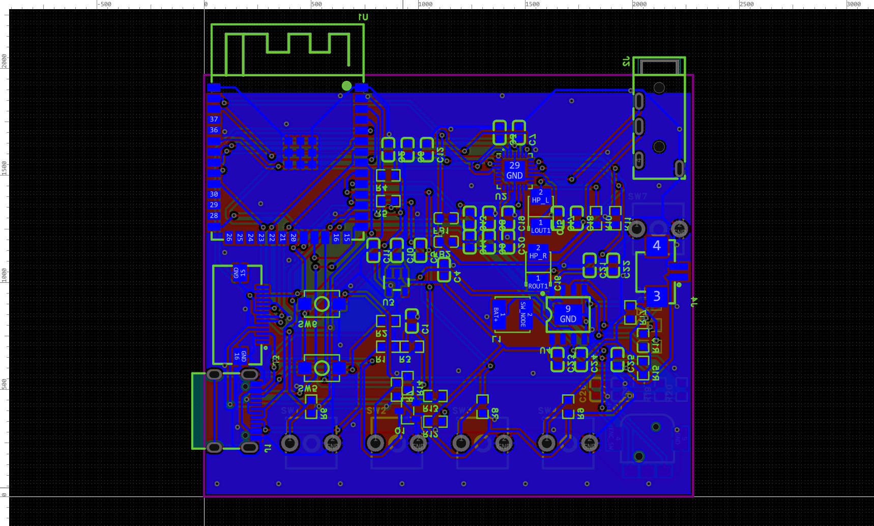
pcb/板子渲染图.png
