spring-soft/lychee-music-hardware/pcb/资料/参考资料/jack_TRRS-4P_ours.png

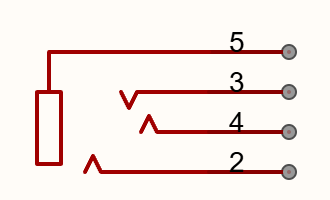
pcb/资料/参考资料/jack_TRRS-4P_ours.png
