spring-soft/lychee-music-hardware/pcb/资料/参考资料/jack_TRS-3P_HCTL.png

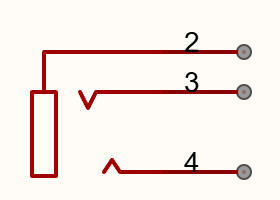
pcb/资料/参考资料/jack_TRS-3P_HCTL.png
