spring-soft/lychee-music-hardware/pcb/资料/参考资料/jack_TRS-3P_SHOUHAN.png

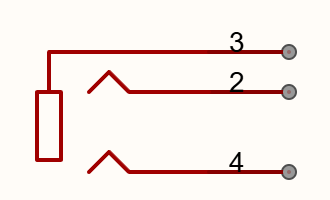
pcb/资料/参考资料/jack_TRS-3P_SHOUHAN.png
