spring-soft/lychee-music-hardware/pcb/资料/参考资料/pj320a_blank.jpg

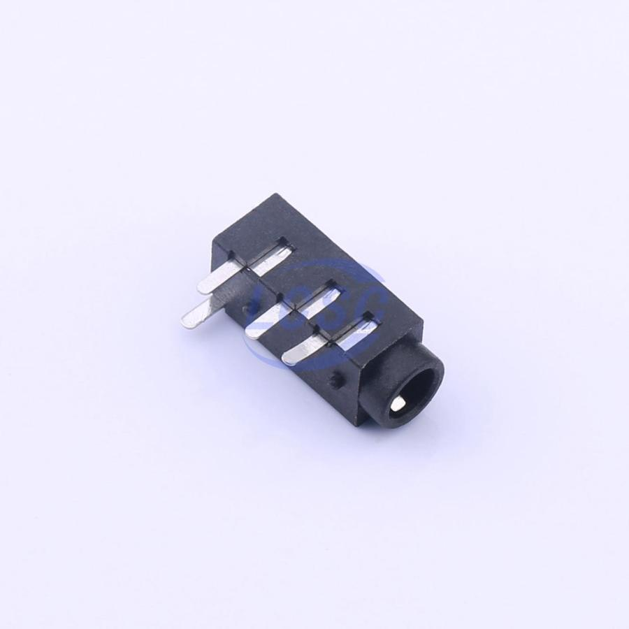
pcb/资料/参考资料/pj320a_blank.jpg
