spring-soft/lychee-music-hardware/pcb/资料/参考资料/pj_320a_footprint.png

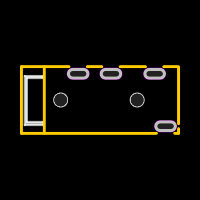
pcb/资料/参考资料/pj_320a_footprint.png
