spring-soft/lychee-music-hardware/pcb/资料/参考资料/tantalum_symbol.png

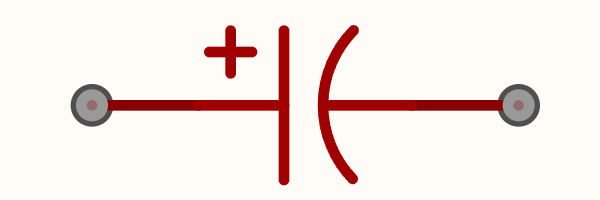
pcb/资料/参考资料/tantalum_symbol.png
