spring-soft/lychee-music-hardware/pcb/bom_grid.txt

范围 A1:Y33
R1: A1=立创商城BOM报价单
R2: A2=BOM配单编号：BOM260927000612 | F2=上传时间：2026-09-27 10:58:36 | J2=1.名称释义：MPQ--最小包装量；MOQ--最小起订量
R3: A3=BOM名称：立创商城_配单_已替换 | F3=采购套数：1
R4: A4=商品总价:￥233.78 (原价:￥240.20, 折扣 | F4=网址：https://bom.szlcsc.com/bo
R5: A5=原始需求 | G5=匹配结果 | N5=订单满足
R6: A6=型号 | B6=原始品牌 | C6=原始封装 | D6=原参数 | E6=立创编号 | F6=数量 | G6=匹配结果 | H6=商品名称 | I6=型号 | J6=品牌 | K6=封装 | L6=参数 | M6=目录 | N6=商品编号 | O6=商品链接 | P6=渠道 | Q6=交期 | R6=MOQ | S6=MPQ | T6=库存 | U6=购买数量 | V6=单价(RMB) | W6=关税税率 | X6=小计(RMB) | Y6=备注
R7: A7=TS60HD50B25B201 轻触开关 6×6×5 直 | E7=C22368614 | F7=15 | G7=人工匹配 | H7=YIYUAN(怡远) 6x6x4.5mm  180gf  | I7=YTS1S0161BBT00 | J7=YIYUAN(怡远) | K7=插件,6x6mm | L7=电路结构：单刀单掷 按钮形状：圆形按钮 作用力：2.6N | M7=按键/开关 | N7=C22368614 | O7=https://item.szlcsc.com/2384 | P7=现货 | Q7=4小时内发货 | R7=20 | S7=1000 | T7=180 | U7=20 | V7=0.09965 | W7=0 | X7=1.99
R8: A8=TS-1185-C-A-B-B 轻触按键 3×4 贴片 | E8=C465999 | F8=6 | G8=系统匹配 | H8=4*3*2mm 立贴 轻触开关 | I8=TS-1185-C-A-B-B | J8=XKB Connection(中国星坤) | K8=SMD,4x3mm | L8=电路结构：单刀单掷 按钮形状：圆形按钮 作用力：2.6N | M8=按键/开关 | N8=C465999 | O8=https://item.szlcsc.com/4713 | P8=现货 | Q8=4小时内发货 | R8=5 | S8=3000 | T8=3800 | U8=10 | V8=0.9225 | W8=0 | X8=9.23
R9: A9=HYCW03-2.8D-5P-S 旋转编码器 | E9=C55218995 | F9=3 | G9=系统匹配 | H9=HYCW03-2.8D-5P-S | I9=HYCW03-2.8D-5P-S | J9=HOAUC(华宇创) | K9=SMD | L9=编码器类型：增量式 节点数/脉冲数(增量式)：12/12 | M9=按键/开关 | N9=C55218995 | O9=https://item.szlcsc.com/5906 | P9=现货 | Q9=4小时内发货 | R9=1 | S9=1500 | T9=70 | U9=3 | V9=1.3524 | W9=0 | X9=4.06
R10: A10=MMZ1608B601CTAH0 600Ω@100MHz | E10=C97120 | F10=6 | G10=系统匹配 | H10=单路 0603磁珠 阻抗600Ω@100MHz | I10=MMZ1608B601CTAH0 | J10=TDK | K10=0603 | L10=阻抗@频率：600Ω@100MHz 误差：±25% 直流 | M10=磁珠/滤波器/EMI优化 | N10=C97120 | O10=https://item.szlcsc.com/9832 | P10=现货 | Q10=4小时内发货 | R10=10 | S10=4000 | T10=80290 | U10=10 | V10=0.0905 | W10=0 | X10=0.91
R11: A11=WPN4020H2R2MT 2.2µH | E11=C98361 | F11=3 | G11=系统匹配 | H11=2.2uH ±20% 7.6A | I11=WPN4020H2R2MT | J11=Sunlord(顺络) | K11=SMD,4x4mm | L11=电感值：2.2uH 精度：±20% 额定电流：4.3A  | M11=电感/线圈/变压器 | N11=C98361 | O11=https://item.szlcsc.com/9957 | P11=现货 | Q11=4小时内发货 | R11=2 | S11=3000 | T11=36762 | U11=4 | V11=0.6192 | W11=0 | X11=2.48
R12: A12=TYPE-C-31-M-12 | E12=C165948 | F12=3 | G12=系统匹配 | H12=Type-C 母 卧贴 | I12=TYPE-C-31-M-12 | J12=韩国韩荣 | K12=SMD | L12=连接器类型：Type-C 协议标准：- 公母：母 安装方 | M12=连接器 | N12=C165948 | O12=https://item.szlcsc.com/1773 | P12=现货 | Q12=4小时内发货 | R12=5 | S12=1000 | T12=433045 | U12=5 | V12=1.051008 | W12=0 | X12=5.26
R13: A13=PJ-320A | E13=C2884926 | F13=3 | G13=系统匹配 | H13=3.5mm耳机座 | I13=PJ-320A | J13=XKB Connection(中国星坤) | K13=插件 | L13=连接器类型：3.5mm耳机座 额定电流：500mA 额定 | M13=连接器 | N13=C2884926 | O13=https://item.szlcsc.com/3095 | P13=现货 | Q13=4小时内发货 | R13=5 | S13=1000 | T13=11340 | U13=5 | V13=0.838945 | W13=0 | X13=4.19
R14: A14=AFC01-S14FCC-00 FPC连接器 14P 0 | E14=C577443 | F14=3 | G14=系统匹配 | H14=翻盖式 下接 P数:14P 间距:0.5mm | I14=AFC01-S14FCC-00 | J14=JS(钜硕电子) | K14=SMD,P=0.5mm,卧贴 | L14=锁定特性：翻盖式 触点类型：下接 触点数量：14P 间距 | M14=连接器 | N14=C577443 | O14=https://item.szlcsc.com/6049 | P14=现货 | Q14=4小时内发货 | R14=5 | S14=50 | T14=16330 | U14=5 | V14=0.6071 | W14=0 | X14=3.04
R15: A15=HC-1.25-2PWT 电池座 1.25mm 2P 卧 | E15=C2845379 | F15=3 | G15=系统匹配 | H15=1x2P 间距:1.25mm 卧贴 系列:PicoBla | I15=HC-1.25-2PWT | J15=HCTL(华灿天禄) | K15=SMD,P=1.25mm,卧贴 | L15=插针结构：1x2P 间距：1.25mm 安装方式：卧贴  | M15=连接器 | N15=C2845379 | O15=https://item.szlcsc.com/3039 | P15=现货 | Q15=4小时内发货 | R15=10 | S15=2000 | T15=254220 | U15=10 | V15=0.3133 | W15=0 | X15=3.13
R16: A16=CC0603KRX7R9BB104 100nF/50V  | E16=C14663 | F16=100 | G16=系统匹配 | H16=100nF ±10% 50V | I16=CC0603KRX7R9BB104 | J16=YAGEO(国巨) | K16=0603 | L16=容值：100nF 精度：±10% 额定电压：50V 温度 | M16=电容 | N16=C14663 | O16=https://item.szlcsc.com/1533 | P16=现货 | Q16=4小时内发货 | R16=50 | S16=4000 | T16=7786400 | U16=100 | V16=0.0751 | W16=0 | X16=7.51
R17: A17=CL10A106KP8NNNC 10µF/10V X5R | E17=C19702 | F17=100 | G17=系统匹配 | H17=10uF ±10% 10V | I17=CL10A106KP8NNNC | J17=SAMSUNG(三星) | K17=0603 | L17=容值：10uF 精度：±10% 额定电压：10V 温度系 | M17=电容 | N17=C19702 | O17=https://item.szlcsc.com/2041 | P17=现货 | Q17=4小时内发货 | R17=20 | S17=4000 | T17=4900400 | U17=100 | V17=0.1957 | W17=0 | X17=19.57
R18: A18=0603X7R105K500NT 1µF/50V X7R | E18=C6266891 | F18=100 | G18=人工匹配 | H18=1uF ±20% 25V | I18=TCC0603X5R105M250CT | J18=CCTC(三环) | K18=0603 | L18=容值：1uF 精度：±20% 额定电压：25V 温度系数 | M18=电容 | N18=C6266891 | O18=https://item.szlcsc.com/7212 | P18=现货 | Q18=4小时内发货 | R18=50 | S18=4000 | T18=1454200 | U18=100 | V18=0.0699 | W18=0 | X18=6.99
R19: A19=RST220UF10V018 220µF/10V 固态电 | E19=C4747973 | F19=6 | G19=系统匹配 | H19=220uF ±20% 10V | I19=RST220UF10V018 | J19=KNSCHA(科尼盛) | K19=SMD,D6.3xL5.4mm | L19=容值：220uF 精度：±20% 额定电压：10V 纹波 | M19=电容 | N19=C4747973 | O19=https://item.szlcsc.com/5320 | P19=现货 | Q19=4小时内发货 | R19=20 | S19=1000 | T19=36300 | U19=20 | V19=0.187088 | W19=0 | X19=3.74
R20: A20=CL10B472KB8NNNC 4.7nF/50V X7 | E20=C1621 | F20=100 | G20=系统匹配 | H20=4.7nF ±10% 50V | I20=CL10B472KB8NNNC | J20=SAMSUNG(三星) | K20=0603 | L20=容值：4.7nF 精度：±10% 额定电压：50V 温度 | M20=电容 | N20=C1621 | O20=https://item.szlcsc.com/1973 | P20=现货 | Q20=4小时内发货 | R20=50 | S20=4000 | T20=500350 | U20=100 | V20=0.0588 | W20=0 | X20=5.88
R21: A21=AA0603FR-0710KL 10kΩ ±1% 060 | E21=C4319854 | F21=100 | G21=系统匹配 | H21=厚膜电阻 10kΩ ±1% 100mW | I21=AA0603FR-0710KL | J21=YAGEO(国巨) | K21=0603 | L21=电阻类型：厚膜电阻 阻值：10kΩ 精度：±1% 功率： | M21=电阻 | N21=C4319854 | O21=https://item.szlcsc.com/4890 | P21=现货 | Q21=4小时内发货 | R21=50 | S21=5000 | T21=3200 | U21=100 | V21=0.0606 | W21=0 | X21=6.06
R22: A22=0603WAF1001T5E 1kΩ | E22=C21190 | F22=100 | G22=系统匹配 | H22=厚膜电阻 1kΩ ±1% 100mW | I22=0603WAF1001T5E | J22=UNI-ROYAL(厚声) | K22=0603 | L22=电阻类型：厚膜电阻 阻值：1kΩ 精度：±1% 功率：1 | M22=电阻 | N22=C21190 | O22=https://item.szlcsc.com/2190 | P22=现货 | Q22=4小时内发货 | R22=100 | S22=5000 | T22=6973400 | U22=100 | V22=0.0154 | W22=0 | X22=1.54
R23: A23=0603WAF5101T5E 5.1kΩ | E23=C23186 | F23=100 | G23=系统匹配 | H23=厚膜电阻 5.1kΩ ±1% 100mW | I23=0603WAF5101T5E | J23=UNI-ROYAL(厚声) | K23=0603 | L23=电阻类型：厚膜电阻 阻值：5.1kΩ 精度：±1% 功率 | M23=电阻 | N23=C23186 | O23=https://item.szlcsc.com/2391 | P23=现货 | Q23=4小时内发货 | R23=100 | S23=5000 | T23=22839400 | U23=100 | V23=0.0091 | W23=0 | X23=0.91
R24: A24=0603WAF1000T5E 100Ω | E24=C22775 | F24=100 | G24=系统匹配 | H24=厚膜电阻 100Ω ±1% 100mW | I24=0603WAF1000T5E | J24=UNI-ROYAL(厚声) | K24=0603 | L24=电阻类型：厚膜电阻 阻值：100Ω 精度：±1% 功率： | M24=电阻 | N24=C22775 | O24=https://item.szlcsc.com/2350 | P24=现货 | Q24=4小时内发货 | R24=100 | S24=5000 | T24=6882500 | U24=100 | V24=0.0189 | W24=0 | X24=1.89
R25: A25=0603WAF1004T5E 1MΩ | E25=C22935 | F25=100 | G25=系统匹配 | H25=厚膜电阻 1MΩ ±1% 100mW | I25=0603WAF1004T5E | J25=UNI-ROYAL(厚声) | K25=0603 | L25=电阻类型：厚膜电阻 阻值：1MΩ 精度：±1% 功率：1 | M25=电阻 | N25=C22935 | O25=https://item.szlcsc.com/2366 | P25=现货 | Q25=4小时内发货 | R25=100 | S25=5000 | T25=4879800 | U25=100 | V25=0.010788 | W25=0 | X25=1.08
R26: A26=0603WAF1003T5E 100kΩ | E26=C25803 | F26=100 | G26=系统匹配 | H26=厚膜电阻 100kΩ ±1% 100mW | I26=0603WAF1003T5E | J26=UNI-ROYAL(厚声) | K26=0603 | L26=电阻类型：厚膜电阻 阻值：100kΩ 精度：±1% 功率 | M26=电阻 | N26=C25803 | O26=https://item.szlcsc.com/2654 | P26=现货 | Q26=4小时内发货 | R26=100 | S26=5000 | T26=16850200 | U26=100 | V26=0.0187 | W26=0 | X26=1.87
R27: A27=2N7002 | E27=C727149 | F27=3 | G27=系统匹配 | H27=1个N沟道 耐压:60V 电流:115mA | I27=2N7002 | J27=TWGMC(迪嘉) | K27=SOT-23 | L27=数量：1个N沟道 漏源电压(Vdss)：60V 连续漏极 | M27=三极管/MOS管/晶体管 | N27=C727149 | O27=https://item.szlcsc.com/7742 | P27=现货 | Q27=4小时内发货 | R27=50 | S27=3000 | T27=62600 | U27=50 | V27=0.0938 | W27=0 | X27=4.69
R28: A28=ESP32-S3-WROOM-1-N16R8 | E28=C2913202 | F28=3 | G28=系统匹配 | H28=不带固件 通用型Wi-Fi+低功耗蓝牙MCU模组 | I28=ESP32-S3-WROOM-1-N16R8 | J28=ESPRESSIF(乐鑫) | K28=SMD,25.5x18mm | L28=核心芯片：ESP32-S3R8 接口类型：I2C；GPI | M28=物联网/通信模块 | N28=C2913202 | O28=https://item.szlcsc.com/3198 | P28=现货 | Q28=4小时内发货 | R28=1 | S28=650 | T28=1584 | U28=3 | V28=31.6 | W28=0 | X28=94.8
R29: A29=ES8388 | E29=C365736 | F29=3 | G29=系统匹配 | H29=音频解码芯片 | I29=ES8388 | J29=Everest-semi(顺芯) | K29=QFN-28-EP(4x4) | L29=分辨率(位)：24 通道数：2 工作电压：1.7V~3. | M29=ADC/DAC/数据转换 | N29=C365736 | O29=https://item.szlcsc.com/3399 | P29=现货 | Q29=4小时内发货 | R29=1 | S29=5000 | T29=45656 | U29=3 | V29=6.79 | W29=0 | X29=20.37
R30: A30=TLV75733PDBVR | E30=C485517 | F30=3 | G30=系统匹配 | H30=3.3V 1A 5.5V | I30=TLV75733PDBVR | J30=TI(德州仪器) | K30=SOT-23-5 | L30=输出极性：正极 工作电压：5.5V 输出电压：3.3V  | M30=电源管理 | N30=C485517 | O30=https://item.szlcsc.com/4939 | P30=现货 | Q30=4小时内发货 | R30=5 | S30=3000 | T30=79830 | U30=5 | V30=1.2248 | W30=0 | X30=6.12
R31: A31=IP5306 | E31=C181692 | F31=3 | G31=系统匹配 | H31=集成2.1A充电器和2.1A放电器的移动电源系统级芯片 | I31=IP5306 | J31=INJOINIC(英集芯) | K31=ESOP-8 | L31=芯片类型：充电芯片；保护芯片 工作电压：4.65V~5. | M31=电源管理 | N31=C181692 | O31=https://item.szlcsc.com/1930 | P31=现货 | Q31=4小时内发货 | R31=5 | S31=4000 | T31=4930 | U31=5 | V31=1.8268 | W31=0 | X31=9.13
R32: A32=LED0603 绿色 | E32=C9900014849 | F32=9 | G32=系统匹配 | H32=翠绿 | I32=19-217/GHC-YR1S2/6T | J32=EVERLIGHT(亿光) | K32=0603 | L32=灯头类型：- 发光颜色：翠绿色 正向压降(Vf)：3.3 | M32=光电器件 | N32=C2986059 | O32=https://item.szlcsc.com/3432 | P32=现货 | Q32=4小时内发货 | R32=50 | S32=6000 | T32=287900 | U32=50 | V32=0.1089 | W32=0 | X32=5.45
R33: E33=C41426929 | G33=系统匹配 | H33=自弹式 MicroSD卡(TF卡) 卡座 | I33=TF-01A | J33=JXTCONN(聚兴泰) | K33=SMD | L33=卡连接方式：自弹式 卡类型：MicroSD卡(TF卡)  | M33=连接器 | N33=C41426929 | O33=https://item.szlcsc.com/4327 | P33=现货 | Q33=4小时内发货 | R33=10 | S33=1000 | T33=3460 | U33=10 | V33=0.39899 | W33=0 | X33=3.99
