spring-soft/lychee-music-hardware/pcb/元件采购清单.md

# 元件采购清单

**去哪买**：**立创商城** https://www.szlcsc.com
> BOM 里的编号全部是立创编号（`C` 开头），可以直接用它的「**BOM 配单**」功能：把 `元件采购清单.csv` 上传进去，自动填购物车。

**每片板 70 个元件，共 26 种**

| # | 立创编号 | 型号 | 每片用量 | 建议买 | 位号 |
|---:|---|---|---:|---:|---|
| 1 | C14663 | CC0603KRX7R9BB104 100nF/50V X7R | 14 | **42** | C4 C5 C6 C7 C8 C9 C18 C20 C21 C22 C23 C24 C26 C27 |
| 2 | C25804 | 0603WAF1002T5E 10kΩ | 11 | **33** | R4 R5 R6 R7 R8 R9 R10 R11 R18 R19 R20 |
| 3 | C19702 | CL10A106KP8NNNC 10µF/10V X5R | 8 | **24** | C10 C11 C12 C13 C14 C17 C19 C25 |
| 4 | C71845 | 轻触开关 6*6*5 直插(2脚) | 5 | **15** | SW1 SW2 SW3 SW4 SW7 |
| 5 | C21190 | 0603WAF1001T5E 1kΩ | 3 | **9** | R15 R16 R17 |
| 6 | C9900014849 | LED0603 绿色 | 3 | **9** | D1 D2 D3 |
| 7 | C15849 | CL10A105KB8NNNC 1µF/50V X5R | 2 | **6** | C2 C3 |
| 8 | C22775 | 0603WAF1000T5E 100Ω | 2 | **6** | R12 R13 |
| 9 | C23186 | 0603WAF5101T5E 5.1kΩ | 2 | **6** | R1 R2 |
| 10 | C4747973 | RST220UF10V018 220µF/10V 固态电容(有极性) | 2 | **6** | C15 C16 |
| 11 | C97120 | MMZ1608B601CTAH0 600Ω@100MHz | 2 | **6** | FB1 FB2 |
| 12 | C9900017573 | 轻触按键 3×4 贴片 | 2 | **6** | SW5 SW6 |
| 13 | C1621 | CL10B472KB8NNNC 4.7nF/50V X7R | 1 | **3** | C1 |
| 14 | C165948 | TYPE-C-31-M-12 | 1 | **3** | J1 |
| 15 | C181692 | IP5306 | 1 | **3** | U4 |
| 16 | C22935 | 0603WAF1004T5E 1MΩ | 1 | **3** | R3 |
| 17 | C25803 | 0603WAF1003T5E 100kΩ | 1 | **3** | R14 |
| 18 | C2884926 | PJ-320A | 1 | **3** | J2 |
| 19 | C2913202 | ESP32-S3-WROOM-1-N16R8 | 1 | **3** | U1 |
| 20 | C365736 | ES8388 | 1 | **3** | U2 |
| 21 | C485517 | TLV75733PDBVR | 1 | **3** | U3 |
| 22 | C55218995 | HYCW03-2.8D-5P-S 旋转编码器 | 1 | **3** | EC1 |
| 23 | C727149 | 2N7002 | 1 | **3** | Q1 |
| 24 | C98361 | WPN4020H2R2MT 2.2µH | 1 | **3** | L1 |
| 25 | C9900013951 | SP088 电池座 | 1 | **3** | J4 |
| 26 | C9900014993 | 0.5MMFPC连接器14PIN下接翻盖式 | 1 | **3** | J3 |

---

## 采购建议

| 元件 | 建议 |
|---|---|
| **ESP32-S3-WROOM-1-N16R8** | 买 **3 个**（¥30 左右一个，焊坏概率不低）|
| **ES8388** | 买 **3 个**（QFN 封装难焊，容易焊坏）|
| **0603 电阻/电容** | 立创一般 **100 个一包起卖**，直接买 100 个（才几块钱）|
| **其他小件** | 按 3 片的量买，多几个无所谓 |
| **电池 / 屏幕 / 耳机** | 不在本清单，另外买 |

---

## 下单流程

1. 打开 https://www.szlcsc.com 注册/登录
2. 找到「**BOM 配单**」（或「批量配单」）
3. 上传 `元件采购清单.csv`
4. 核对匹配结果（可能有几个件需要手动确认）
5. 加购物车、结算

> 立创商城通常 **满 ¥29 包邮**，一次买齐比较划算。
> 元件从深圳发货，一般 2-3 天到。
