spring-soft/lychee-music-hardware/pcb/元件采购清单_按套.md

# 元件采购清单（按套计）

**一套 = 1 片板所需的全部元件**，共 70 个 / 26 种。

**去哪买**：立创商城 https://www.szlcsc.com （用「BOM 配单」上传 `立创商城_配单.csv`）

| 类别 | 立创编号 | 型号 | **每套用量** | 建议购买 | 位号 |
|---|---|---|---:|---:|---|
| 按键 | C71845 | 轻触开关 6*6*5 直插(2脚) | **5** | 15 | SW1 SW2 SW3 SW4 SW7 |
| 按键 | C9900017573 | 轻触按键 3×4 贴片 | **2** | 6 | SW5 SW6 |
| 编码器 | C55218995 | HYCW03-2.8D-5P-S 旋转编码器 | **1** | 3 | EC1 |
| 磁珠 | C97120 | MMZ1608B601CTAH0 600Ω@100MHz | **2** | 6 | FB1 FB2 |
| 电感 | C98361 | WPN4020H2R2MT 2.2µH | **1** | 3 | L1 |
| 连接器 | C165948 | TYPE-C-31-M-12 | **1** | 3 | J1 |
| 连接器 | C2884926 | PJ-320A | **1** | 3 | J2 |
| 连接器 | C9900014993 | 0.5MMFPC连接器14PIN下接翻盖式 | **1** | 3 | J3 |
| 连接器 | C9900013951 | SP088 电池座 | **1** | 3 | J4 |
| 贴片电容 | C14663 | CC0603KRX7R9BB104 100nF/50V X7R | **14** | 100 | C4 C5 C6 C7 C8 C9 C18 C20 C21 C22 C23 C24 C26 C27 |
| 贴片电容 | C19702 | CL10A106KP8NNNC 10µF/10V X5R | **8** | 100 | C10 C11 C12 C13 C14 C17 C19 C25 |
| 贴片电容 | C15849 | CL10A105KB8NNNC 1µF/50V X5R | **2** | 100 | C2 C3 |
| 贴片电容 | C4747973 | RST220UF10V018 220µF/10V 固态电容(有极性) | **2** | 6 | C15 C16 |
| 贴片电容 | C1621 | CL10B472KB8NNNC 4.7nF/50V X7R | **1** | 100 | C1 |
| 贴片电阻 | C25804 | 0603WAF1002T5E 10kΩ | **11** | 100 | R4 R5 R6 R7 R8 R9 R10 R11 R18 R19 R20 |
| 贴片电阻 | C21190 | 0603WAF1001T5E 1kΩ | **3** | 100 | R15 R16 R17 |
| 贴片电阻 | C23186 | 0603WAF5101T5E 5.1kΩ | **2** | 100 | R1 R2 |
| 贴片电阻 | C22775 | 0603WAF1000T5E 100Ω | **2** | 100 | R12 R13 |
| 贴片电阻 | C22935 | 0603WAF1004T5E 1MΩ | **1** | 100 | R3 |
| 贴片电阻 | C25803 | 0603WAF1003T5E 100kΩ | **1** | 100 | R14 |
| 芯片 | C727149 | 2N7002 | **1** | 3 | Q1 |
| 芯片 | C2913202 | ESP32-S3-WROOM-1-N16R8 | **1** | 3 | U1 |
| 芯片 | C365736 | ES8388 | **1** | 3 | U2 |
| 芯片 | C485517 | TLV75733PDBVR | **1** | 3 | U3 |
| 芯片 | C181692 | IP5306 | **1** | 3 | U4 |
| LED | C9900014849 | LED0603 绿色 | **3** | 9 | D1 D2 D3 |

---

## 🎯 立创商城配单结果处理（**下单前必看**）

商城「BOM 智能配单」的结果：**完全匹配 22 / 待确认 3 / 无法匹配 1**。

### ⚠️ 商城的推荐有 2 个是错的，别直接点「一键下单」

| 行 | 原件 | 商城推荐 | 问题 |
|---|---|---|---|
| 9 | `C9900013951` SP088 电池座 | `LAIL-CR2032-SMT-B02-4AA` | ❌ **那是纽扣电池座！完全不对** |
| 1 | `C71845` 6×6×5 直插按键 | `SH-6X6X5H-TP`（标 SMD） | ⚠️ 你要的是**直插**，它给的可能是贴片 |

### ✅ 已核验的替代品（**封装逐字一致，焊盘完全兼容**）

| 行 | 原件 | 推荐替代编号 | 型号 | 封装 |
|---|---|---|---|---|
| 8 | `C9900014993` FPC 14P | **`C577443`** ⭐ | AFC01-S14FCC-00 | 同型号！ |
| 9 | `C9900013951` 电池座 | **`C2845379`** | HC-1.25-2PWT | `CONN-SMD_2P-P1.25-HC-1.25-2PWT` |
| 9 | 备选 | `C2939411` | PH1250-WT-02P | 同上 |
| 1 | `C71845` 6×6×5 直插 | **`C2733615`** | B3F-6000 (**OMRON**) | `KEY-TH_2P-L6.0-W6.0-P5.00` |
| 1 | 备选 | `C2844505` | TS60HD50B25B201 | 同上 |
| 1 | 备选 | `C22368614` | YTS1S0161BBT00 | 同上 |
| 2 | `C9900017573` 3×4 贴片 | **`C465999`** | TS-1185-C-A-B-B | `SW-SMD_L4.0-W2.9-LS5.0` |
| 2 | 备选 | `C557591` | TS342A2P-WZ | 同上 |
| 2 | 备选 | `C2905176` | TD-1185SN-2.5H-250 | 同上 |

### ④⑤ 两颗芯片（TLV75733 / IP5306）

这两个商城的 BOM 工具认不出，但**在嘉立创库里都存在**，编号也对：

| 位号 | 编号 | 型号 | 封装 | 厂商 |
|---|---|---|---|---|
| U3 | `C485517` | TLV75733PDBVR | `SOT-23-5_L2.9-W1.6-P0.95-LS2.8-BL` | TI |
| U4 | `C181692` | IP5306 | `ESOP-8_L4.9-W3.9-P1.27-LS6.0-BL-EP` | 英集芯 |

**直接把这俩编号粘到商城搜索框**，或者搜型号 `TLV75733PDBVR` / `IP5306`。

> ⚠️ 这两颗**不要随便换替代品** —— SOT-23-5 / ESOP-8 封装的芯片有成千上万种，
> 封装一样但功能完全不同。**必须买到同名芯片或确认过的 pin-to-pin 替代。**

---

## ⚠️ 商城 BOM 工具匹配不上的 5 个元件（原始分析）

**这 5 个在嘉立创元件库里都存在，封装也全都对** —— 是立创商城的 BOM 工具认不出它们
（`C99` 开头的是嘉立创自营编号，商城那边识别不了）。

### 办法一：搜索框**直接粘贴编号**

一个个粘 `C71845`、`C9900014849`、`C9900017573`、`C485517`、`C181692`，多数应该能搜到。

### 办法二：搜不到就用下面的替代品

| # | 原编号 | 型号 | 每套 | 要求的封装 |
|---|---|---|---:|---|
| ① | `C71845` | 轻触开关 6×6×5 直插 | 5 | `KEY-TH_2P-L6.0-W6.0-P5.00` |
| ② | `C9900014849` | LED0603 绿色 | 3 | `LED0603-RD_GREEN` |
| ③ | `C9900017573` | 轻触按键 3×4 贴片 | 2 | `SW-SMD_L4.0-W2.9-LS5.0` |
| ④ | `C485517` | TLV75733PDBVR (TI) | 1 | `SOT-23-5` |
| ⑤ | `C181692` | IP5306 (英集芯) | 1 | `ESOP-8` |

#### ✅ 已核验可用的替代品

**③ 轻触按键 3×4（封装完全一致，焊盘兼容）**

| 替代编号 | 型号 |
|---|---|
| **`C5143624`** | HX TS342A2P WZ 250gf |
| **`C2837315`** | 两脚小龟 3*4*2 |
| **`C42431745`** | SH-TS-1185-2P-160gf |

**② LED 0603 绿色（同封装）**

| 替代编号 | 型号 |
|---|---|
| `C9900015925` | ChipCap 翠绿色高亮 0603 470nm |
| `C9900025458` | S_LED0603 绿光 LED |
| `C9900023193` | 0603 0.6mm 高贴片 LED GREEN |

#### ⚠️ 换料铁律

**封装必须完全一致，否则焊不上。** 换之前先核对上表的「要求的封装」。

**④ TLV75733（U3）最要紧** —— 它是 3.3V 主电源，替代品必须满足：
**SOT-23-5 封装 + 3.3V 输出 + 电流 ≥600mA**。
拿不准的把候选型号发给我确认，换错了整板供电都有问题。
