spring-soft/lychee-music-hardware/pcb/SMT_BOM元件清单.xlsx

No. | Quantity | Comment | Designator | Footprint | Value | Manufacturer Part | Manufacturer | Supplier Part | Supplier
1 | 1 | CL10B472KB8NNNC | C1 | C0603 |  | CL10B472KB8NNNC | SAMSUNG(三星) | C1621 | LCSC
2 | 2 | CL10A105KB8NNNC | C2,C3 | C0603 |  | CL10A105KB8NNNC | SAMSUNG(三星) | C15849 | LCSC
3 | 12 | CC0603KRX7R9BB104 | C4,C5,C6,C7,C8,C9,C18,C20,C22,C24,C26,C27 | C0603 |  | CC0603KRX7R9BB104 | YAGEO(国巨) | C14663 | LCSC
4 | 10 | CL10A106KP8NNNC | C10,C11,C12,C13,C14,C17,C19,C21,C23,C25 | C0603 |  | CL10A106KP8NNNC | SAMSUNG(三星) | C19702 | LCSC
5 | 2 | CA45-B-6.3V-220UF-M | C15,C16 | CAP-SMD_L3.5-W2.8-FD |  | CA45-B-6.3V-220UF-M | CEC(振华新云) | C2887903 | LCSC
6 | 3 | LED0603-RDl绿灯 | D1,D2,D3 | LED0603-RD_GREEN |  | LED0603-RDl绿灯 |  | C9900014849 | LCSC
7 | 1 | HYCW03-2.8D-5P-S | EC1 | SW-SMD_HYCW03-2.8D-5P-S |  | HYCW03-2.8D-5P-S | HOAUC(华宇创) | C55218995 | LCSC
8 | 2 | MMZ1608B601CTAH0 | FB1,FB2 | L0603 |  | MMZ1608B601CTAH0 | TDK | C97120 | LCSC
9 | 1 | TYPE-C-31-M-12 | J1 | USB-C_SMD-TYPE-C-31-M-12_1 |  | TYPE-C-31-M-12 | 韩国韩荣 | C165948 | LCSC
10 | 1 | PJ-320A | J2 | AUDIO-TH_XKB_PJ-320A |  | PJ-320A | XKB Connection(中国星坤) | C2884926 | LCSC
11 | 1 | 0.5mmFPC连接器:14PIN下接接翻盖式 | J3 | FPC-SMD_14P-P0.50_AFC01-S14FCC-00 |  | 0.5mmFPC连接器:14PIN下接接翻盖式 |  | C9900014993 | LCSC
12 | 1 | SP088 | J4 | CONN-SMD_2P-P1.25-HC-1.25-2PWT |  | SP088 |  | C9900013951 | LCSC
13 | 1 | WPN4020H2R2MT | L1 | IND-SMD_L4.0-W4.0 |  | WPN4020H2R2MT | Sunlord(顺络) | C98361 | LCSC
14 | 1 | 2N7002 | Q1 | SOT-23-3_L2.9-W1.3-P1.90-LS2.4-BR |  | 2N7002 | TWGMC(迪嘉) | C727149 | LCSC
15 | 2 | 0603WAF5101T5E | R1,R2 | R0603 |  | 0603WAF5101T5E | UNI-ROYAL(厚声) | C23186 | LCSC
16 | 1 | 0603WAF1004T5E | R3 | R0603 |  | 0603WAF1004T5E | UNI-ROYAL(厚声) | C22935 | LCSC
17 | 11 | 0603WAF1002T5E | R4,R5,R6,R7,R8,R9,R10,R11,R18,R19,R20 | R0603 |  | 0603WAF1002T5E | UNI-ROYAL(厚声) | C25804 | LCSC
18 | 2 | 0603WAF1000T5E | R12,R13 | R0603 |  | 0603WAF1000T5E | UNI-ROYAL(厚声) | C22775 | LCSC
19 | 1 | 0603WAF1003T5E | R14 | R0603 |  | 0603WAF1003T5E | UNI-ROYAL(厚声) | C25803 | LCSC
20 | 3 | 0603WAF1001T5E | R15,R16,R17 | R0603 |  | 0603WAF1001T5E | UNI-ROYAL(厚声) | C21190 | LCSC
21 | 5 | 轻触开关,6*6*5塑头,260G,行程0.25mm,直插中2脚 | SW1,SW2,SW3,SW4,SW7 | KEY-TH_2P-L6.0-W6.0-P5.00 |  | 轻触开关,6*6*5塑头,260G,行程0.25mm,直插中2脚 |  | C71845 | LCSC
22 | 2 | 轻触按键3*4*H | SW5,SW6 | SW-SMD_L4.0-W2.9-LS5.0 |  | 轻触按键3*4*H |  | C9900017573 | LCSC
23 | 1 | ESP32-S3-WROOM-1-N16R8 | U1 | WIRELM-SMD_ESP32-S3-WROOM-1 |  | ESP32-S3-WROOM-1-N16R8 | ESPRESSIF(乐鑫) | C2913202 | LCSC
24 | 1 | ES8388 | U2 | QFN-28_L4.0-W4.0-P0.45-BL-EP |  | ES8388 | Everest-semi(顺芯) | C365736 | LCSC
25 | 1 | TLV75733PDBVR | U3 | SOT-23-5_L2.9-W1.6-P0.95-LS2.8-BL |  | TLV75733PDBVR | TI(德州仪器) | C485517 | LCSC
26 | 1 | IP5306 | U4 | ESOP-8_L4.9-W3.9-P1.27-LS6.0-BL-EP |  | IP5306 | INJOINIC(英集芯) | C181692 | LCSC
