spring-soft/lychee-music-hardware/pcb/资料/参考资料/HYCW03_encoder.pdf

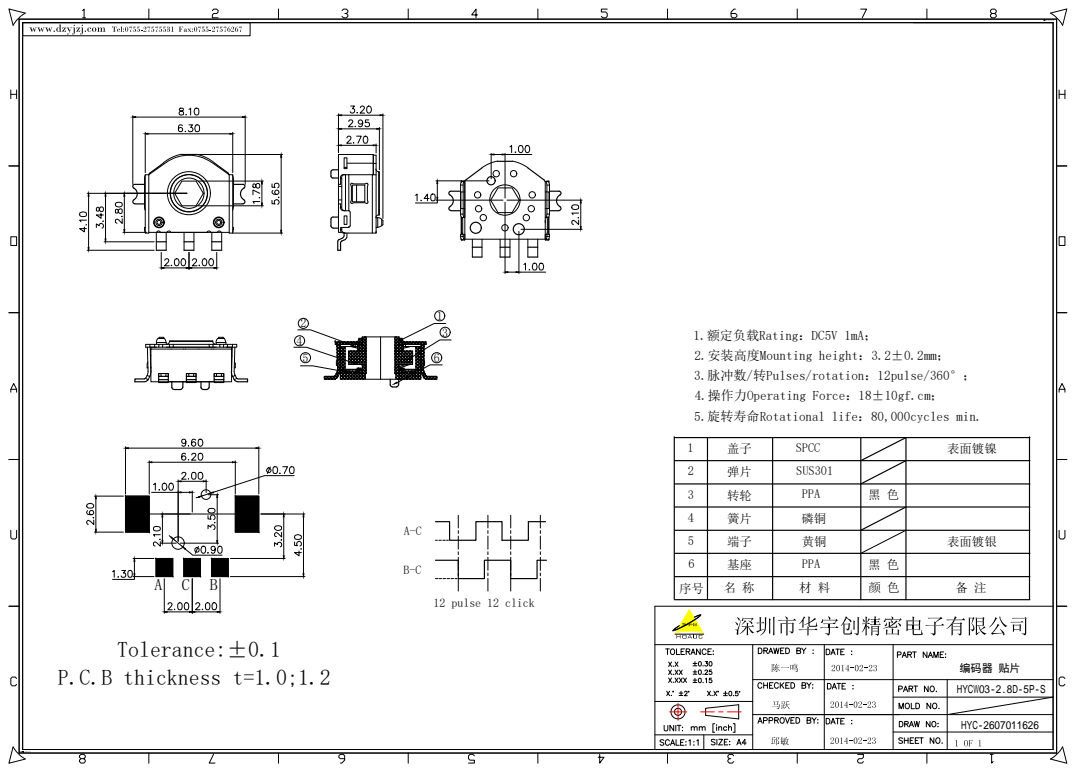
[picture p32: page 1]
Tolerance:±0.1 P.C.B thickness t=1.0;1.2; 12 pulse 12 click; 编码器 贴片

1.额定负载Rating：DC5V 1mA；
2.安装高度Mounting height：3.2±0.2mm；
3.脉冲数/转Pulses/rotation：12pulse/360°；
4.操作力Operating Force：18±10gf.cm；
5.旋转寿命Rotational life：80,000cycles min.

1 | 盖子 | SPCC | | 表面镀镍
2 | 弹片 | SUS301
3 | 转轮 | PPA | 黑 色

4 | 簧片 | 磷铜
5 | 端子 | 黄铜 | | 表面镀银
6 | 基座 | PPA | 黑 色
