spring-soft/lychee-music-hardware/pcb/资料/屏幕规格书/原理图.pdf

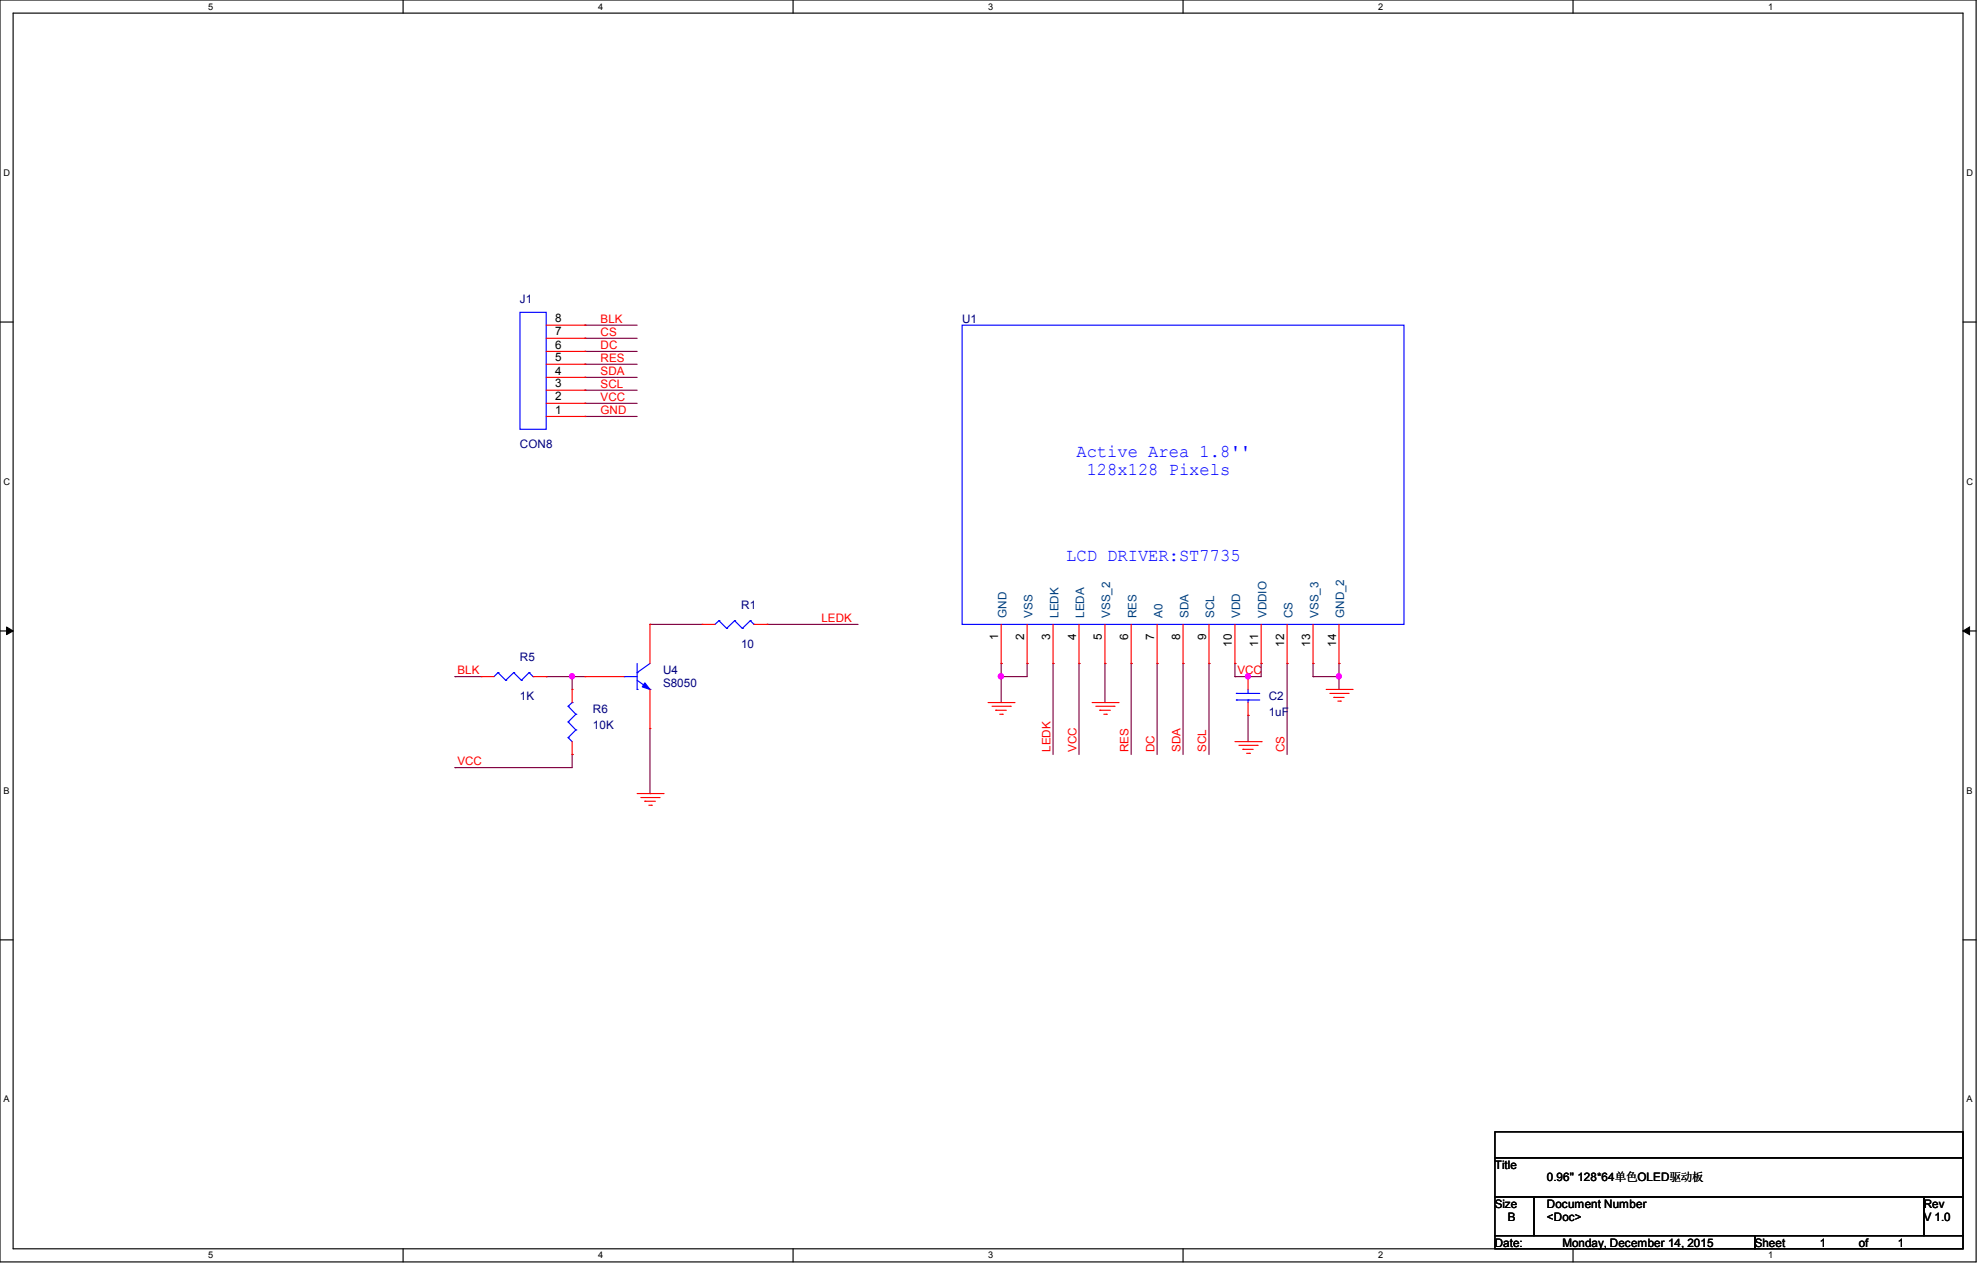
[picture p33: page 1]
CS DC RES SDA SCL VCC GND; LEDK; VCC; RES; SDA; SCL; BLK; Title; Size; Document Number; Rev; Date:; Sheet; <Doc>; 0.96'' 128*64单色OLED驱动板; Monday, December 14, 2015; LCD DRIVER:ST7735; Active Area 1.8'' 128x128 Pixels; GND 1; VSS 2; LEDK 3; LEDA 4; VSS_2 5; RES 6; SDA 8; SCL 9; VDD 10; VDDIO 11; VSS_3 13; GND_2 14; CON8
