spring-soft/lychee-music-hardware/(list of files, drawings)

Other design files:
pcb/旧文件备份/board.dsn
pcb/旧文件备份/pcb-layout.json
