spring-soft/lychee-music-hardware/pcb/bom_dump.txt

工作表: sheet

========== 【sheet】 33 行 ==========
立创商城BOM报价单																								
BOM配单编号：BOM260927000612					上传时间：2026-09-27 10:58:36				1.名称释义：MPQ--最小包装量；MOQ--最小起订量；
2.匹配结果为实时查询结果，库存和价格可能会有波动。如超过24小时，请在立创商城重新匹配后下单；
3.订货商品的价格仅供参考，请提交订单后确定。
4.如有部分物料未能成功匹配，需要整单购买，请联系商城客服。															
BOM名称：立创商城_配单_已替换					采购套数：1																			
商品总价:￥233.78 (原价:￥240.20, 折扣:-￥6.42) 
注：报价单总价不含待确认和无法匹配项					网址：https://bom.szlcsc.com/bom.html																			
原始需求						匹配结果							订单满足											
型号	原始品牌	原始封装	原参数	立创编号	数量	匹配结果	商品名称	型号	品牌	封装	参数	目录	商品编号	商品链接	渠道	交期	MOQ	MPQ	库存	购买数量	单价(RMB)	关税税率	小计(RMB)	备注
TS60HD50B25B201 轻触开关 6×6×5 直插				C22368614	15	人工匹配	YIYUAN(怡远) 6x6x4.5mm  180gf 3.5长中两脚	YTS1S0161BBT00	YIYUAN(怡远)	插件,6x6mm	电路结构：单刀单掷 按钮形状：圆形按钮 作用力：2.6N 安装方式：直插 开关长度：6mm 开关宽度：6mm 开关高度：4.5mm 带支架：不带支架 触点电流：50mA 额定电压：12V 带灯：无 引脚样式：PC引脚	按键/开关	C22368614	https://item.szlcsc.com/23846802.html	现货	4小时内发货	20	1000	180	20	0.09965	0	1.99	
TS-1185-C-A-B-B 轻触按键 3×4 贴片				C465999	6	系统匹配	4*3*2mm 立贴 轻触开关	TS-1185-C-A-B-B	XKB Connection(中国星坤)	SMD,4x3mm	电路结构：单刀单掷 按钮形状：圆形按钮 作用力：2.6N 安装方式：立贴 开关长度：4mm 开关宽度：3mm 开关高度：2mm 带支架：不带支架 触点电流：50mA 额定电压：12V 按钮/盖帽颜色：蓝色 带灯：无 工作寿命：10万次 工作温度：-30℃~+85℃	按键/开关	C465999	https://item.szlcsc.com/471387.html	现货	4小时内发货	5	3000	3800	10	0.9225	0	9.23	
HYCW03-2.8D-5P-S 旋转编码器				C55218995	3	系统匹配	HYCW03-2.8D-5P-S	HYCW03-2.8D-5P-S	HOAUC(华宇创)	SMD	编码器类型：增量式 节点数/脉冲数(增量式)：12/12 输出形式：两相输出 安装方式：立贴 额定电流：1mA 额定电压：5V	按键/开关	C55218995	https://item.szlcsc.com/59065607.html	现货	4小时内发货	1	1500	70	3	1.3524	0	4.06	
MMZ1608B601CTAH0 600Ω@100MHz				C97120	6	系统匹配	单路 0603磁珠 阻抗600Ω@100MHz	MMZ1608B601CTAH0	TDK	0603	阻抗@频率：600Ω@100MHz 误差：±25% 直流电阻(DCR)：400mΩ 额定电流：500mA 通道数：1 工作温度：-55℃~+125℃	磁珠/滤波器/EMI优化	C97120	https://item.szlcsc.com/98325.html	现货	4小时内发货	10	4000	80290	10	0.0905	0	0.91	
WPN4020H2R2MT 2.2µH				C98361	3	系统匹配	2.2uH ±20% 7.6A	WPN4020H2R2MT	Sunlord(顺络)	SMD,4x4mm	电感值：2.2uH 精度：±20% 额定电流：4.3A 饱和电流(Isat)：7.6A 直流电阻(DCR)：48mΩ 类型：-	电感/线圈/变压器	C98361	https://item.szlcsc.com/99570.html	现货	4小时内发货	2	3000	36762	4	0.6192	0	2.48	
TYPE-C-31-M-12				C165948	3	系统匹配	Type-C 母 卧贴	TYPE-C-31-M-12	韩国韩荣	SMD	连接器类型：Type-C 协议标准：- 公母：母 安装方式：卧贴 触点数量：16P 端口数量：1 额定电流 - 电源：5A 额定电压：20V 插拔寿命：1万次 体长(L)：7.35mm 工作温度：-30℃~+80℃	连接器	C165948	https://item.szlcsc.com/177331.html	现货	4小时内发货	5	1000	433045	5	1.051008	0	5.26	
PJ-320A				C2884926	3	系统匹配	3.5mm耳机座	PJ-320A	XKB Connection(中国星坤)	插件	连接器类型：3.5mm耳机座 额定电流：500mA 额定电压：30V 触头材质：青铜 触头镀层：锡 工作温度：-20℃~+70℃ 级数：TRRS 安装方式：弯插 颜色：黑色 板上高度：5mm 长度：14.2mm 宽度：6.2mm	连接器	C2884926	https://item.szlcsc.com/3095418.html	现货	4小时内发货	5	1000	11340	5	0.838945	0	4.19	
AFC01-S14FCC-00 FPC连接器 14P 0.5mm 下接				C577443	3	系统匹配	翻盖式 下接 P数:14P 间距:0.5mm	AFC01-S14FCC-00	JS(钜硕电子)	SMD,P=0.5mm,卧贴	锁定特性：翻盖式 触点类型：下接 触点数量：14P 间距：0.5mm 安装方式：卧贴 接入柔性电缆厚度：0.3mm 板上高度：2mm 触头材质：铜合金 触头镀层：锡 FPC/FFC扣：不带扣 正脚/反脚：无正反区分	连接器	C577443	https://item.szlcsc.com/604977.html	现货	4小时内发货	5	50	16330	5	0.6071	0	3.04	
HC-1.25-2PWT 电池座 1.25mm 2P 卧贴				C2845379	3	系统匹配	1x2P 间距:1.25mm 卧贴 系列:PicoBlade(MX 1.25)	HC-1.25-2PWT	HCTL(华灿天禄)	SMD,P=1.25mm,卧贴	插针结构：1x2P 间距：1.25mm 安装方式：卧贴 参考系列：PicoBlade(MX 1.25) 总PIN数：2P 排数：1 每排PIN数：2 行距：- 额定电流：1A 触头材质：黄铜 触头镀层：锡 工作温度：-40℃~+105℃ 额定电压：125V 塑料材质：LCP 阻燃等级：UL94V-0 附加特征：辅助焊脚 颜色：- Z轴-板上高度：3.57mm X轴-板上底边长度(间距线)：7.55mm Y轴-板上底边宽度：5.25mm	连接器	C2845379	https://item.szlcsc.com/3039060.html	现货	4小时内发货	10	2000	254220	10	0.3133	0	3.13	
CC0603KRX7R9BB104 100nF/50V X7R				C14663	100	系统匹配	100nF ±10% 50V	CC0603KRX7R9BB104	YAGEO(国巨)	0603	容值：100nF 精度：±10% 额定电压：50V 温度系数：X7R	电容	C14663	https://item.szlcsc.com/15331.html	现货	4小时内发货	50	4000	7786400	100	0.0751	0	7.51	
CL10A106KP8NNNC 10µF/10V X5R				C19702	100	系统匹配	10uF ±10% 10V	CL10A106KP8NNNC	SAMSUNG(三星)	0603	容值：10uF 精度：±10% 额定电压：10V 温度系数：X5R	电容	C19702	https://item.szlcsc.com/20411.html	现货	4小时内发货	20	4000	4900400	100	0.1957	0	19.57	
0603X7R105K500NT 1µF/50V X7R 0603				C6266891	100	人工匹配	1uF ±20% 25V	TCC0603X5R105M250CT	CCTC(三环)	0603	容值：1uF 精度：±20% 额定电压：25V 温度系数：X5R	电容	C6266891	https://item.szlcsc.com/7212756.html	现货	4小时内发货	50	4000	1454200	100	0.0699	0	6.99	
RST220UF10V018 220µF/10V 固态电容(有极性)				C4747973	6	系统匹配	220uF ±20% 10V	RST220UF10V018	KNSCHA(科尼盛)	SMD,D6.3xL5.4mm	容值：220uF 精度：±20% 额定电压：10V 纹波电流：85mA@120Hz 等效串联电阻(ESR)：- 电容体直径：6.3mm 电容体长度：5.4mm 工作寿命：2000hrs@105℃ 工作温度：-40℃~+105℃	电容	C4747973	https://item.szlcsc.com/5320100.html	现货	4小时内发货	20	1000	36300	20	0.187088	0	3.74	
CL10B472KB8NNNC 4.7nF/50V X7R				C1621	100	系统匹配	4.7nF ±10% 50V	CL10B472KB8NNNC	SAMSUNG(三星)	0603	容值：4.7nF 精度：±10% 额定电压：50V 温度系数：X7R	电容	C1621	https://item.szlcsc.com/1973.html	现货	4小时内发货	50	4000	500350	100	0.0588	0	5.88	
AA0603FR-0710KL 10kΩ ±1% 0603				C4319854	100	系统匹配	厚膜电阻 10kΩ ±1% 100mW	AA0603FR-0710KL	YAGEO(国巨)	0603	电阻类型：厚膜电阻 阻值：10kΩ 精度：±1% 功率：100mW 温度系数：±150ppm/℃ 工作温度：-55℃~+155℃	电阻	C4319854	https://item.szlcsc.com/4890303.html	现货	4小时内发货	50	5000	3200	100	0.0606	0	6.06	
0603WAF1001T5E 1kΩ				C21190	100	系统匹配	厚膜电阻 1kΩ ±1% 100mW	0603WAF1001T5E	UNI-ROYAL(厚声)	0603	电阻类型：厚膜电阻 阻值：1kΩ 精度：±1% 功率：100mW 工作电压：75V 温度系数：±100ppm/℃ 工作温度：-55℃~+155℃	电阻	C21190	https://item.szlcsc.com/21904.html	现货	4小时内发货	100	5000	6973400	100	0.0154	0	1.54	
0603WAF5101T5E 5.1kΩ				C23186	100	系统匹配	厚膜电阻 5.1kΩ ±1% 100mW	0603WAF5101T5E	UNI-ROYAL(厚声)	0603	电阻类型：厚膜电阻 阻值：5.1kΩ 精度：±1% 功率：100mW 工作电压：75V 温度系数：±100ppm/℃ 工作温度：-55℃~+155℃	电阻	C23186	https://item.szlcsc.com/23913.html	现货	4小时内发货	100	5000	22839400	100	0.0091	0	0.91	
0603WAF1000T5E 100Ω				C22775	100	系统匹配	厚膜电阻 100Ω ±1% 100mW	0603WAF1000T5E	UNI-ROYAL(厚声)	0603	电阻类型：厚膜电阻 阻值：100Ω 精度：±1% 功率：100mW 工作电压：75V 温度系数：±100ppm/℃ 工作温度：-55℃~+155℃	电阻	C22775	https://item.szlcsc.com/23502.html	现货	4小时内发货	100	5000	6882500	100	0.0189	0	1.89	
0603WAF1004T5E 1MΩ				C22935	100	系统匹配	厚膜电阻 1MΩ ±1% 100mW	0603WAF1004T5E	UNI-ROYAL(厚声)	0603	电阻类型：厚膜电阻 阻值：1MΩ 精度：±1% 功率：100mW 工作电压：75V 温度系数：±100ppm/℃ 工作温度：-55℃~+155℃	电阻	C22935	https://item.szlcsc.com/23662.html	现货	4小时内发货	100	5000	4879800	100	0.010788	0	1.08	
0603WAF1003T5E 100kΩ				C25803	100	系统匹配	厚膜电阻 100kΩ ±1% 100mW	0603WAF1003T5E	UNI-ROYAL(厚声)	0603	电阻类型：厚膜电阻 阻值：100kΩ 精度：±1% 功率：100mW 工作电压：75V 温度系数：±100ppm/℃ 工作温度：-55℃~+155℃	电阻	C25803	https://item.szlcsc.com/26546.html	现货	4小时内发货	100	5000	16850200	100	0.0187	0	1.87	
2N7002				C727149	3	系统匹配	1个N沟道 耐压:60V 电流:115mA	2N7002	TWGMC(迪嘉)	SOT-23	数量：1个N沟道 漏源电压(Vdss)：60V 连续漏极电流(Id)：115mA 导通电阻(RDS(on))：7.5Ω@10V 耗散功率(Pd)：200mW 阈值电压(Vgs(th))：2.5V 栅极电荷量(Qg)：- 输入电容(Ciss)：50pF 反向传输电容(Crss)：5pF 工作温度：-55℃~+150℃ 配置：- 类型：N沟道 输出电容(Coss)：11pF 栅极电压(Vgs)：±20V	三极管/MOS管/晶体管	C727149	https://item.szlcsc.com/774254.html	现货	4小时内发货	50	3000	62600	50	0.0938	0	4.69	
ESP32-S3-WROOM-1-N16R8				C2913202	3	系统匹配	不带固件 通用型Wi-Fi+低功耗蓝牙MCU模组	ESP32-S3-WROOM-1-N16R8	ESPRESSIF(乐鑫)	SMD,25.5x18mm	核心芯片：ESP32-S3R8 接口类型：I2C；GPIO；UART；SPI；USB；I2S 频率：2.4GHz 天线形式：板载PCB天线 发射功率：20.5dBm 工作电压：3V~3.6V 接收电流：95mA 发送电流：355mA 接收灵敏度：-103.5dBm 工作温度：-40℃~+65℃  不带固件	物联网/通信模块	C2913202	https://item.szlcsc.com/3198300.html	现货	4小时内发货	1	650	1584	3	31.6	0	94.80	
ES8388				C365736	3	系统匹配	音频解码芯片	ES8388	Everest-semi(顺芯)	QFN-28-EP(4x4)	分辨率(位)：24 通道数：2 工作电压：1.7V~3.6V 接口类型：SPI；I2C 芯片类型：音频ADC；音频解码器 工作温度：-40℃~+85℃ 采样率：96000Hz 静态电流(Iq)：- 积分非线性：- 功能特性：可编程增益 ADC架构：Sigma-Delta 微分非线性：-	ADC/DAC/数据转换	C365736	https://item.szlcsc.com/339918.html	现货	4小时内发货	1	5000	45656	3	6.79	0	20.37	
TLV75733PDBVR				C485517	3	系统匹配	3.3V 1A 5.5V	TLV75733PDBVR	TI(德州仪器)	SOT-23-5	输出极性：正极 工作电压：5.5V 输出电压：3.3V 输出电流：1A 电源纹波抑制比(PSRR)：46dB@(100kHz) 压差：650mV@(1A) 静态电流(Iq)：40uA 噪声：71.5uVrms 功能特性：使能控制；输出放电；内置软启动；过流保护；短路保护；热关断；输入欠压保护 工作温度：-40℃~+125℃@(Tj) 输出类型：固定 输出通道数：1	电源管理	C485517	https://item.szlcsc.com/493903.html	现货	4小时内发货	5	3000	79830	5	1.2248	0	6.12	
IP5306				C181692	3	系统匹配	集成2.1A充电器和2.1A放电器的移动电源系统级芯片	IP5306	INJOINIC(英集芯)	ESOP-8	芯片类型：充电芯片；保护芯片 工作电压：4.65V~5.5V 最大充电电流：2.1A 充电饱和电压：4.2V 放电截止电压：3V 电池类型：锂电池 电池节数：1 工作温度：0℃~+70℃ 电池温度检测：不支持 0V电池充电：不支持 静态电流(Iq)：100uA 均衡电流：- 接口类型：I2C 功能特性：过放保护；恒流充电；自动再充电；充电终止；短路保护；过压保护；过充保护；涓流充电；过流保护；欠压锁定	电源管理	C181692	https://item.szlcsc.com/193089.html	现货	4小时内发货	5	4000	4930	5	1.8268	0	9.13	
LED0603 绿色				C9900014849	9	系统匹配	翠绿	19-217/GHC-YR1S2/6T	EVERLIGHT(亿光)	0603	灯头类型：- 发光颜色：翠绿色 正向压降(Vf)：3.3V 功率：95mW 测试电流：25mA 波长：520nm~535nm 峰值波长：518nm 二极管配置：独立二极管 透镜颜色：无色透明透镜 色温：- 发光强度：- 发光角度：120° 载带方式：- 工作温度：-40℃~+85℃	光电器件	C2986059	https://item.szlcsc.com/3432218.html	现货	4小时内发货	50	6000	287900	50	0.1089	0	5.45	
				C41426929		系统匹配	自弹式 MicroSD卡(TF卡) 卡座	TF-01A	JXTCONN(聚兴泰)	SMD	卡连接方式：自弹式 卡类型：MicroSD卡(TF卡) 连接器类型：卡座 额外插卡检测引脚：无 本体最大高度：2mm 工作温度：-25℃~+90℃	连接器	C41426929	https://item.szlcsc.com/43273754.html	现货	4小时内发货	10	1000	3460	10	0.39899	0	3.99	
