spring-soft/lychee-music-hardware/(commit log)

2026-10-11 项目配套资料：PCB 设计数据 + 开发记录（首次提交）
    这是 lychee-music 的【非固件】部分。固件源码在另一个仓库
    spring-soft/lychee-music（那个才是 ESP-IDF 工程），QQ 音乐契约层服务在
    spring-soft/lychee-music-qqservice。三者分开是因为交付形态完全不同：
    固件是 IDF 工程、服务是 Python 容器、这里是设计资料和文档。
    ## 装了什么
    pcb/ 原理图、PCB 工程包、屏幕与器件规格书、工具、旧文件备份（634 个文件 / 82MB）
    docs/ 开发记录（20+ 篇，按模块：M4 按键 / M5 网页 / M6 落盘 / M7 BLE / M8 搜索 /
    M9 离线TF / 字库 / 显示校准 / 启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
    [Drill_NPTH_Through.DRL, Drill_PTH_Through.DRL, Drill_PTH_Through_Via.DRL, Gerber_BoardOutlineLayer.GKO, Gerber_BottomLayer.GBL, Gerber_BottomPasteMaskLayer.GBP, Gerber_BottomSilkscreenLayer.GBO, Gerber_BottomSolderMaskLayer.GBS]
2026-10-11 tools/audit_secrets.py：推之前查一遍【将要提交的内容】里有没有真实凭据
    这个仓库最需要它：docs/ 会引用真实配置值，pcb/fw_src 下还有 firmware 源码快照
    （里面 sdkconfig/sdkconfig.local 是带密码的，靠 .gitignore 挡）。
    关键是检查目标选对了：不是'扫目录里有没有密码'，而是**只看 git 实际会提交的那份**。
    因为上面那两个 sdkconfig 确实含密码、但已被忽略 —— 按目录扫会一直报假警，
    把真问题淹掉。首次提交前就是靠这条把文档里的明文密码挑出来的。
    真值从 firmware/sdkconfig.local 现读（不写死在脚本里，脚本要进仓库）；
    读不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
